CloudEngineHub/RP1_hardware/00_Docs/README.md

# 硬件说明文档

[RP1 硬件系统架构（PDF）](RP1_Hardware_Architecture.pdf)

先按整机配置选择 BOM，再通过料号查找对应的设计与制造文件。

| 资料 | 内容 |
| --- | --- |
| [整机 BOM](../04_BOM/README.md) | 各配置的物料料号与数量 |
| [机械结构](../01_Mechanic/README.md) | 装配体、零件模型、工程图与制造要求 |
| [PCB](../02_PCB/README.md) | 板级 BOM、Gerber、贴装坐标与加工要求 |
| [线束](../03_Harness/README.md) | 线束 BOM、图纸与制作规范 |

[返回 RP1 硬件首页](../README_CN.md)
