CloudEngineHub/RP1_hardware/02_PCB/11_RBE_PWR_140WCHG/README.md

# 140WCHG 板贴装说明

[PCB 资料](../README.md) · [项目首页](../../README_CN.md)

资料料号：YCL.E000223；板卡修订：V1.0。

| 位号 | 装配状态 | 单板装配数量 |
| --- | --- | --- |
| R59 | NC，不装 | 0 |

[BOM](01_BOM_140WCHG_2026-09-09.xlsx) 的主表为装配物料清单，[CPL](04_CPL_140WCHG_2026-09-16.xlsx) 的主表为有效贴装坐标，两者均包含 164 个装配位号。

47kΩ／FRC0603F4702TS 的装配位号为 `R17,R30`，单板数量为 2。BOM 的 `NC_List` 表单独保留 R59，数量为 0，不计入装配采购数量。

BOM 第 57 行的 `Unique ID` 保留原分组导出追溯信息，原分组包含 R59。各 ID 与位号的逐项映射未确认；采购及装配以主表的 `Designator`、`Quantity` 和有效 CPL 为准。导出装配 BOM 时，仅使用原 BOM 主表，不使用 `NC_List`。
