CloudEngineHub/RP1_hardware/02_PCB/06_RBE-PWR-HEAD/README.md

# HEAD 板贴装说明

资料料号：YCL.E000225；板卡修订：V2.0。

| 位号 | 装配状态 | 单板装配数量 |
| --- | --- | --- |
| C30 | NC，不装 | 0 |

[BOM](01_BOM_HEAD_2026-09-09.xlsx) 的主表为装配物料清单。[CPL](04_CPL_HEAD_2026-09-16.xlsx) 的主表为有效贴装坐标，均包含 200 个装配位号。

CPL 的 `NC_List` 表保留 C30 的型号、封装和原坐标，仅用于追溯。导出或导入贴装坐标时，只使用原 CPL 主表，不使用 `NC_List`。
