CloudEngineHub/RP1_hardware/03_Harness/README.md

# 线束资料

本目录提供 RP1 的 42 种线束及对应 PDF 图纸。

| 资料 | 内容 |
| --- | --- |
| [RP1_Harness_BOM.xlsx](RP1_Harness_BOM.xlsx) | 线束名称、线径、连接器、端子与数量 |
| [加工图纸](Drawings/) | 线束加工图纸 |
| [线束制作规范.docx](线束制作规范.docx) | 制作流程、端接要求与检验方法 |

按线束名称查找图纸。`ARM_10线材` 对应 [ARM_10_信号线.pdf](Drawings/ARM_10_信号线.pdf)。

## BODY01 图纸

BODY01 线束加工图纸

[查看图纸 PDF](Drawings/RP1-BODY01-0线材.pdf)

整机配置所需物料见 [整机 BOM](../04_BOM/README.md)。

[返回 RP1 硬件首页](../README_CN.md)
