CloudEngineHub/RP1_hardware/01_Mechanic/02_Manufacturing/01_CNC/CMF说明/RP1_CNC_CMF_Specification.xlsx

序号 | 零件代号 | 零件名称 | 颜色 | 材质 | 工艺 | 三维视图缩略图
1 | YCL.M000227 | 腰部一号（LS版） | 蓝 | AL6061 | 喷砂、喷涂
2 | YCL.M000228 | 腰部一号抱箍（LS版） | 蓝 | AL6061 | 喷砂、喷涂
3 | YCL.M000229 | 髋关节前（LS版） | 白 | AL6061 | 喷砂、喷涂
4 | YCL.M000230 | 髋关节后（LS版） | 白 | AL6061 | 喷砂、喷涂
5 | YCL.M000231 | 髋关节左（LS版） | 蓝 | AL6061 | 喷砂、喷涂
6 | YCL.M000232 | 髋关节右（LS版） | 蓝 | AL6061 | 喷砂、喷涂
7 | YCL.M000234 | 髋关节限位环 | 蓝 | AL6061 | 喷砂、喷涂
8 | YCL.M000237 | 髋关节电机盖板 | 蓝 | AL6061 | 喷砂、喷涂
9 | YCL.M000239 | 髋关节左抱箍 | 蓝 | AL6061 | 喷砂、喷涂
10 | YCL.M000240 | 髋关节右抱箍 | 蓝 | AL6061 | 喷砂、喷涂
11 | YCL.M000289 | 髋关节前盖板 | 灰 | AL6061 | 喷砂、喷涂
12 | YCL.M000312 | 小臂下本体 | 白 | AL6061 | 喷砂、喷涂
13 | YCL.M000324 | 手腕端头本体 | 白 | AL6061 | 喷砂、喷涂
14 | YCL.M000330 | 转接板固定件 | 白 | AL6061 | 喷砂、喷涂
15 | YCL.M000331 | RP_Hand转接件 | 白 | AL6061 | 喷砂、喷涂
16 | YCL.M000342 | 肩部抱箍 | 白 | AL6061 | 喷砂、喷涂
17 | YCL.M000372 | 造型手本体 | 白 | AL6061 | 喷砂、喷涂
18 | YCL.M000373 | 造型手盖子 | 白 | AL6061 | 喷砂、喷涂
19 | YCL.M000374 | 镜向造型手本体 | 白 | AL6061 | 喷砂、喷涂
20 | YCL.M000376 | 镜向造型手盖子 | 白 | AL6061 | 喷砂、喷涂
21 | YCL.M000437 | 髋关节后盖板 | 灰 | AL6061 | 喷砂、喷涂
22 | YCL.M000444 | 小腿前盖板 | 灰 | ABS | 打磨、喷涂
23 | YCL.M000445 | 小腿后盖板 | 灰 | ABS | 打磨、喷涂
24 | YCL.M000446 | 小腿电机分离块（减重优化） | 白 | AL6061 | 喷砂、喷涂
25 | YCL.M000447 | 小腿本体右（减重优化） | 白 | AL6061 | 喷砂、喷涂
26 | YCL.M000448 | 小腿本体左（减重优化） | 白 | AL6061 | 喷砂、喷涂
27 | YCL.M000449 | 小腿脚踝分离块（减重优化） | 白 | AL6061 | 喷砂、喷涂
28 | YCL.M000451 | 镜向小腿脚踝分离块（减重优化） | 白 | AL6061 | 喷砂、喷涂
29 | YCL.M000452 | 镜向小腿本体左（减重优化） | 白 | AL6061 | 喷砂、喷涂
30 | YCL.M000453 | 镜向小腿本体右（减重优化） | 白 | AL6061 | 喷砂、喷涂
31 | YCL.M000454 | 镜向小腿电机分离块（减重优化） | 白 | AL6061 | 喷砂、喷涂
32 | YCL.M000471 | 手腕本体 | 蓝 | AL6061 | 喷砂、喷涂
33 | YCL.M000472 | 镜向手腕本体 | 蓝 | AL6061 | 喷砂、喷涂
34 | YCL.M000473 | 手腕上抱箍 | 蓝 | AL6061 | 喷砂、喷涂
35 | YCL.M000474 | 手腕下抱箍 | 蓝 | AL6061 | 喷砂、喷涂
36 | YCL.M000475 | 大腿卡箍后 | 白 | AL6061 | 喷砂、喷涂
37 | YCL.M000477 | 大腿卡箍前 | 白 | AL6061 | 喷砂、喷涂
38 | YCL.M000481 | 大腿下本体右 | 白 | AL6061 | 喷砂、喷涂
39 | YCL.M000485 | 大腿下盖板左 | 白 | AL6061 | 喷砂、喷涂
40 | YCL.M000486 | 大腿下盖板右 | 白 | AL6061 | 喷砂、喷涂
41 | YCL.M000640 | 75肩部抱箍（01版） | 蓝 | AL6061 | 喷砂、喷涂
42 | YCL.M000641 | 75肩部本体（01版） | 蓝 | AL6061 | 喷砂、喷涂
43 | YCL.M000642 | 大臂上本体（01版） | 白 | AL6061 | 喷砂、喷涂
44 | YCL.M000643 | 大臂上抱箍（01版） | 白 | AL6061 | 喷砂、喷涂
45 | YCL.M000644 | 大臂下前分件(01版) | 白 | AL6061 | 喷砂、喷涂
46 | YCL.M000645 | 大臂下后分件(01版) | 白 | AL6061 | 喷砂、喷涂
47 | YCL.M000646 | 小臂上本体左（02版） | 白 | AL6061 | 喷砂、喷涂
48 | YCL.M000647 | 小臂上本体右（02版） | 白 | AL6061 | 喷砂、喷涂
49 | YCL.M000648 | 镜向小臂上本体左（02版） | 白 | AL6061 | 喷砂、喷涂
50 | YCL.M000649 | 镜向小臂上本体右（02版） | 白 | AL6061 | 喷砂、喷涂
51 | YCL.M000650 | 镜向大臂下前分件(01版) | 白 | AL6061 | 喷砂、喷涂
52 | YCL.M000651 | 镜向大臂下后分件(01版) | 白 | AL6061 | 喷砂、喷涂
53 | YCL.M000652 | 镜向75肩部抱箍(01版) | 蓝 | AL6061 | 喷砂、喷涂
54 | YCL.M000656 | 镜向75肩部本体(01版) | 蓝 | AL6061 | 喷砂、喷涂
55 | YCL.M000657 | 脚板（01版） | 蓝 | AL6061 | 喷砂、喷涂
56 | YCL.M000662 | 大腿抱箍(01版) | 白 | AL6061 | 喷砂、喷涂
57 | YCL.M000663 | 大腿本体(01版) | 白 | AL6061 | 喷砂、喷涂
58 | YCL.M000666 | 大腿下电机抱箍（01版） | 白 | AL6061 | 喷砂、喷涂
59 | YCL.M000667 | 大腿下本体左(02版) | 白 | AL6061 | 喷砂、喷涂
60 | YCL.M000669 | 镜向大腿下电机抱箍（01版） | 白 | AL6061 | 喷砂、喷涂
61 | YCL.M000670 | 镜向大腿下本体左(02版) | 白 | AL6061 | 喷砂、喷涂
62 | YCL.M000671 | 镜向大腿卡箍后 | 白 | AL6061 | 喷砂、喷涂
63 | YCL.M000672 | 镜向大腿下盖板左 | 白 | AL6061 | 喷砂、喷涂
64 | YCL.M000673 | 镜向大腿卡箍前 | 白 | AL6061 | 喷砂、喷涂
65 | YCL.M000674 | 镜向大腿下本体右 | 白 | AL6061 | 喷砂、喷涂
66 | YCL.M000675 | 镜向大腿下盖板右 | 白 | AL6061 | 喷砂、喷涂
67 | YCL.M000708 | 把手 | 白 | AL6061 | 喷砂、喷涂
68 | YCL.M000716 | kickme版本躯干后壳 | 白 | PC | 打磨、喷涂
69 | YCL.M000717 | kickme版本躯干前壳 | 白 | PC | 打磨、喷涂
70 | YCL.M000722 | 脚板 | 蓝 | AL6061 | 喷砂、喷涂
71 | YCL.M000740 | 头部灯带嵌板 | 白 | ABS | 打磨、喷涂
72 | YCL.M000741 | 运控头头部 | 白 | ABS | 打磨、喷涂
73 | YCL.M000748 | 小电池弹性臂按键 | 白 | PC | 打磨、喷涂
74 | YCL.M000787 | KICKME运控头主体 | 白 | ABS | 打磨、喷涂
75 | YCL.M000788 | KICKME运控头螺丝遮挡盖 | 白 | ABS | 打磨、喷涂
