CloudEngineHub/RP1_hardware/02_PCB/01_FPC柔性板/07_参考图_FPC.jpg

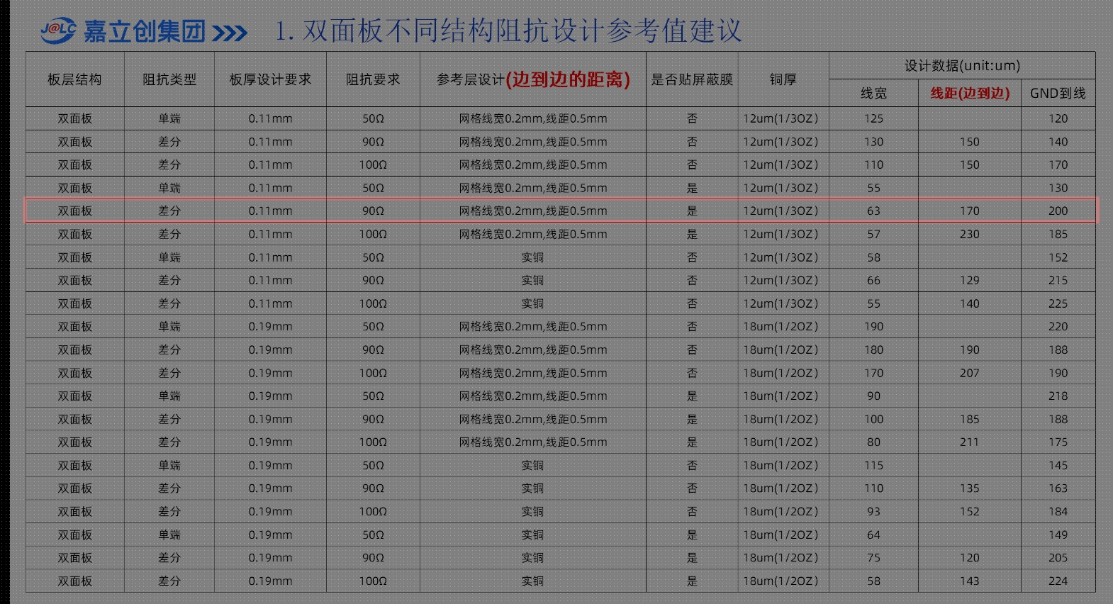
02_PCB/01_FPC柔性板/07_参考图_FPC.jpg
