CloudEngineHub/RP1_hardware/04_BOM/README.md

# RP1 整机 BOM

[返回仓库](../README.md) · [结构资料](../01_Mechanic/README.md) · [PCB](../02_PCB/README.md) · [线束](../03_Harness/README.md)

本目录提供 RP1.3.4 两种配置的整机物料清单。

## 文件与配置

| 配置 | BOM 文件 |
| --- | --- |
| `5DOF_MotionHead` | [RP1_BOM_5DOF_MotionHead.xlsx](RP1_BOM_5DOF_MotionHead.xlsx) |
| `7DOF_MotionHead` | [RP1_BOM_7DOF_MotionHead.xlsx](RP1_BOM_7DOF_MotionHead.xlsx) |

## 工作表

| 工作表 | 内容 |
| --- | --- |
| `总BOM` | 整机装配件、结构件、标准件、板卡、线束及外购件的料号、名称、数量、修订和材料信息 |
| `包材` | 包装物料清单 |

## 使用

按所选配置使用对应 BOM，并通过料号查找配套资料。结构模型与加工文件见 [01_Mechanic](../01_Mechanic/README.md)，板级 BOM 与 PCB 制造文件见 [02_PCB](../02_PCB/README.md)，线束图纸与物料表见 [03_Harness](../03_Harness/README.md)。
