CloudEngineHub/RP1_hardware/03_Harness/RP1_Harness_BOM.xlsx

序号 | 部位 | 线束名称 | 线材规格 | 连接器 | 端子 | 数量
1 | 头部 | NX_Eth_HEAD线材 | 26AWG | A1002H-8P-2+标准网口 | A1002-TP | 1
2 | 头部 | RP1-HEAD1线材 | 28AWG | XT30U (2+2)-F | XT30U (2+2)-F | 1
3 | 头部 | RP1-HEAD2线材 | 28AWG | XT30U (2+2)-F | XT30U (2+2)-F | 1
4 | 头部 | RP1-HEAD3线材 | 28AWG | XT30U (2+2)-F | XT30U (2+2)-F | 1
5 | 主控 | RP1-BODY01-0线材 | CQ-RXG0250 | XT30U (2+2)-F | XT30U (2+2)-F | 1
6 | 主控 | RP1-BODY02-0线材 | CQ-RXG0250 | XT30U (2+2)-F | XT30U (2+2)-F | 1
7 | 主控 | RP1-BODY03-0线材 | CQ-RXG0250 | XT30U (2+2)-F | XT30U (2+2)-F | 1
8 | 主控 | RP1-BODY04-0线材 | CQ-RXG0250 | XT30U (2+2)-F | XT30U (2+2)-F | 1
9 | 主控 | RP1-BODY05-0线材 | CQ-RXG0250 | XT30U (2+2)-F | XT30U (2+2)-F | 1
10 | 主控 | RP1-BODY06-0线材 | 28AWG | GH1.25 4pin | GH1.25 | 1
11 | 主控 | Body_ETH线材 | 26AWG | KW30-8P |  | 2
12 | 主控 | Body-485线材 | 28AWG | A1257H-2P | A1257-TP | 1
13 | 主控 | BODY-stop线材 | 28AWG | A1501H-4P+A2012H-2P | A1501-TP+A2006-TP | 1
14 | 主控 | LED灯板线 | 28AWG | A1257H-3P | A1257-TP | 1
15 | 手部 | RP1-ARM01-0线材 | CQ-RXG0250 | XT30U (2+2)-F | XT30U (2+2)-F | 2
16 | 手部 | RP1-ARM02-0线材 | CQ-RXG0250 | XT30U (2+2)-F | XT30U (2+2)-F | 2
17 | 手部 | RP1-ARM03-0线材 | CQ-RXG0250 | XT30U (2+2)-F | XT30U (2+2)-F | 2
18 | 手部 | RP1-ARM04-0线材 | CQ-RXG0250 | XT30 (2+2)PB-M | XT30 (2+2)PB-M | 2
19 | 手部 | RP1-ARM05-0线材 | CQ-RXG0250 | XT30U (2+2)-F | XT30U (2+2)-F | 2
20 | 手部 | RP1-ARM06-0线材 | CQ-RXG0250 | XT30U (2+2)-F | XT30U (2+2)-F | 2
21 | 手部 | RP1-ARM07-0线材 | CQ-RXG0250 | XT30 (2+2)PB-M | XT30 (2+2)PB-M | 2
22 | 手部 | RP1-ARM08-0线材 | CQ-RXG0250 | XT30U (2+2)-F | XT30U (2+2)-F | 2
23 | 手部 | ARM_10线材 | 28AWG | A2001H-6P | A2001-TP | 2
24 | 手部 | 手部转接线 | 26AWG | PH2.0 6P+ZER-06V-S | SPH-002T-P0.5S +SZE-003T-P0.3 | 2
25 | 腿部 | RP1-LEG01-0线材 | CQ-RXG0250 | XT30U (2+2)-F | XT30U (2+2)-F | 2
26 | 腿部 | RP1-LEG02-0线材 | CQ-RXG0250 | XT30U (2+2)-F | XT30U (2+2)-F | 2
27 | 腿部 | RP1-LEG03-0线材 | CQ-RXG0250 | XT30U (2+2)-F | XT30U (2+2)-F | 2
28 | 腿部 | RP1-LEG04-0线材 | CQ-RXG0250 | XT30 (2+2)PB-M | XT30U (2+2)PB-M | 2
29 | 腿部 | RP1-LEG05-0线材 | CQ-RXG0250 | XT30U (2+2)-F | XT30U (2+2)-F | 2
30 | 腿部 | RP1-LEG06-0线材 | CQ-RXG0250 | XT30U (2+2)-F+XT30(2+2)PB-M | XT30U (2+2)-F+XT30 (2+2)PB-M | 2
31 | 腿部 | RP1-LEG07-0线材 | CQ-RXG0250 | XT30U (2+2)-F | XT30U (2+2)-F | 2
32 | 背板 | Back-GPIO线材 | 28AWG | A1257H-7P | A1257-T | 1
33 | 背板 | Back-Key线材 | 28AWG | A1257H-4P | A1257-T | 1
34 | 背板 | Back_Eth_NX线材 | 26AWG | A1002H-8P-2 | A1002-TP | 1
35 | 背板 | BACK-POWER-NX线材 | 16AWG | PH2.0 6pin+ XT30-F | A2001-TP | 1
36 | 背板 | 电池供电线背部 | 18AWG | XT30-M | XT30-M | 1
37 | 背板 | 电池供电线主控 | 14AWG | XT60-F | XT60-F | 1
38 | 背板 | 电池供电线 | 18AWG | XT30-F | XT30-F | 1
39 | 背板 | 小电池保护板长线 | 16AWG | XT30-F | XT30-F | 1
40 | 背板 | 小电池保护板短线 | 16AWG | XT30-F | XT30-F | 1
41 | 腰部 | RP1-POWER01-0线材 | 28AWG | XT30U (2+2)-F | XT30U (2+2)-F | 1
42 | 腰部 | RP1-POWER02-0线材 | 28AWG | XT30U (2+2)-F | XT30U (2+2)-F | 1
 |  | 数量合计 |  |  |  | 60
