CloudEngineHub/RP1_hardware/02_PCB/08_RBE-PWR-MCAP/01_BOM_MCAP_2026-09-07.xlsx

No. | Quantity | Comment | Designator | Footprint | Value | Manufacturer Part | Manufacturer
1 | 5 | CAP_TH_BD13-L30 | C1,C2,C4,C6,C7 | CAP-TH_BD13-L30-P10.00-L45-W15-FD
2 | 1 | 100nF | C9 | C0603 | 100nF | FCC0603B104K500CT | FOJAN(富捷)
3 | 1 | DDZ16ASF-7 | D1 | SOD-323F_L2.0-W1.6-LS2.5-RD |  | DDZ16ASF-7 | DIODES(美台)
4 | 1 | HSY0149A | Q1 | TOLL-8_L10.4-W9.9-P1.20-LS11.7-BL_2 |  | HSY0149A | HUASHUO(华朔)
5 | 1 | 280kΩ | R1 | R1206 | 280kΩ | FRC1206F2803TS | FOJAN(富捷)
6 | 1 | 680kΩ | R2 | R1206 | 680kΩ | FRC1206J684 TS | FOJAN(富捷)
7 | 1 | XT30PW(2+2)-M.G.B | U1 | CONN-TH_4P-XT30PW-M |  | XT30PW(2+2)-M.G.B | AMASS(艾迈斯)
