CloudEngineHub/RP1_hardware/02_PCB/04_RBE-PWR-FAN/01_BOM_FAN_V2.0.xlsx

No. | Quantity | Comment | Designator | Footprint | Value | Name | Device | Supplier | Voltage Rated | Tolerance
1 | 5 | 100nF | C1,C2,C3,C5,C9 | C0402 | 100nF | 100nF | CAP_0603
2 | 1 | 33pF | C4 | C0402 | 33pF | 33pF | CAP_0603
3 | 1 | 4.7uF | C6 | C1206 | 4.7uF | 4.7uF | GRM31CC72A475KE11L | LCSC |  | ±10%
4 | 1 | 47uF | C7 | C1210 | 47uF | 47uF | HGC1210R5476M250NSVK | LCSC |  | ±20%
5 | 1 | 47uF | C8 | C1206 | 47uF | 47uF | HGC1206R5476M250NSPJ | LCSC |  | ±20%
6 | 1 | 1.25-2P | CN1 | CONN-SMD_1.25-2P |  | 1.25-2P | 1.25-2P | LCSC
7 | 1 | WAFER-254W-2A | CN2 | CONN-SMD_2P-L10.0-W7.8-P2.5 |  | WAFER-254W-2A | WAFER-254W-2A | LCSC
8 | 1 | SMBJ60A | D1 | SMB_L4.5-W3.7-LS5.4-RD |  | SMBJ60A | SMBJ60A_C49066953 | LCSC
9 | 1 | DSS310 | D2 | SOD-123F_L2.8-W1.8-LS3.7-RD |  | DSS310 | DSS310 | LCSC
10 | 1 | 68uH | L1 | IND-SMD_L7.2-W6.6_GPSR07X0 | 68uH | 68uH | CYA0650-68UH | LCSC |  | ±20%
11 | 1 | AO3400 | Q1 | SOT-23-3_L2.9-W1.3-P1.90-LS2.4-BR |  | AO3400 | AO3400_C181090 | LCSC
12 | 1 | 47kΩ | R1 | R0402 | 47kΩ | 47kΩ | FRC0402F4702TS | LCSC |  | ±1%
13 | 1 | 4.7kΩ | R2 | R0402 | 4.7kΩ | 4.7kΩ | RC0402FR-074K7L | LCSC |  | ±1%
14 | 1 | 100kΩ | R3 | R0402 | 100kΩ | 100kΩ | FRC0402F1003TS | LCSC |  | ±1%
15 | 1 | 8.06kΩ | R4 | R0402 | 8.06kΩ | 8.06kΩ | RC0402FR-078K06L | LCSC |  | ±1%
16 | 1 | 140kΩ | R5 | R0402 | 140kΩ | 140kΩ | RC0402FR-07140KL | LCSC |  | ±1%
17 | 1 | 68k | R6 | R0402 | 68k | 68k | Res_0603
18 | 1 | 100K | R7 | R0603 | 100K | 100K | Res_0603
19 | 1 | 4.7k | R8 | R0402 | 4.7k | 4.7k | Res_0603
20 | 2 | ZX-PH2.0-WT2P | U1,U2 | CONN-SMD_ZX-PH2.0-WT2P |  | ZX-PH2.0-WT2P | ZX-PH2.0-WT2P | LCSC
21 | 1 | TL331IDBVR | U3 | SOT-23-5_L3.0-W1.7-P0.95-LS2.8-BR |  | TL331IDBVR | TL331IDBVR | LCSC
22 | 1 | MX8015EP | U4 | ESOP-8_L4.9-W3.9-P1.27-LS6.0-BL-EP |  | MX8015EP | MX8015EP | LCSC
