CloudEngineHub/RP1_hardware/01_Mechanic/02_Manufacturing/01_CNC/RP1_CNC_BOM.xlsx

序号 | 料号 | 零件名称 | 版本 | 材料要求 | 5DOF 运控头 单机数量 | 7DOF 运控头 单机数量
1 | YCL.A000018 | 热压连杆装配体左 | 1 |  | 1 | 1
2 | YCL.A000019 | 热压连杆装配体右 | 1 |  | 1 | 1
3 | YCL.M000225 | 腰部Yaw限位环 | 1 | AISI 1045 钢，冷拔 | 1 | 1
4 | YCL.M000226 | 腰部Roll限位环 | 1 | AISI 1045 钢，冷拔 | 1 | 1
5 | YCL.M000227 | 腰部一号（LS版） | 2 | AL6061-T6 | 1 | 1
6 | YCL.M000228 | 腰部一号抱箍（LS版） | 1 | AL6061-T6 | 1 | 1
7 | YCL.M000229 | 髋关节前（LS版） | 1 | AL6061-T6 | 1 | 1
8 | YCL.M000230 | 髋关节后（LS版） | 1 | AL6061-T6 | 1 | 1
9 | YCL.M000231 | 髋关节左（LS版） | 1 | AL6061-T6 | 1 | 1
10 | YCL.M000232 | 髋关节右（LS版） | 1 | AL6061-T6 | 1 | 1
11 | YCL.M000234 | 髋关节限位环（LS版） | 1 | AISI 1045 钢，冷拔 | 2 | 2
12 | YCL.M000237 | 髋关节电机盖板 | 1 | AL6061-T6 | 2 | 2
13 | YCL.M000238 | 腰部电机罩壳（LS版） | 1 | AL6061-T6 | 1 | 1
14 | YCL.M000239 | 髋关节左抱箍 | 1 | AL6061-T6 | 1 | 1
15 | YCL.M000240 | 髋关节右抱箍 | 1 | AL6061-T6 | 1 | 1
16 | YCL.M000243 | 风机固定块 | 1 | AL6061-T6 | 2 | 2
17 | YCL.M000249 | Yaw限位3 | 1 | 45 | 2 | 2
18 | YCL.M000271 | Pitch限位 | 1 | 45 | 1 | 1
19 | YCL.M000272 | 脚底十字轴 | 1 | 45 | 2 | 2
20 | YCL.M000284 | 镜向Pitch限位 | 1 | #45 | 1 | 1
21 | YCL.M000289 | 髋关节前盖板 | 1 | AL6061-T6 | 1 | 1
22 | YCL.M000292 | 膝盖轴承座 | 1 | P20 | 2 | 2
23 | YCL.M000312 | 小臂下本体 | 1 | AL6061-T6 | 0 | 2
24 | YCL.M000324 | 手腕端头本体 | 1 | AL6061-T6 | 0 | 2
25 | YCL.M000330 | 转接板固定件 | 1 | AL6061-T6 | 0 | 2
26 | YCL.M000331 | 灵巧手转接件 | 1 | AL6061-T6 | 0 | 2
27 | YCL.M000332 | 手臂转接法兰 | 1 | AL6061-T6 | 2 | 2
28 | YCL.M000334 | 限位环 | 1 | 45 | 2 | 2
29 | YCL.M000336 | 肘部轴承座 | 1 | P20 | 2 | 2
30 | YCL.M000337 | 限位环2 | 1 | 45 | 2 | 2
31 | YCL.M000341 | 55限位环 | 1 | 45 | 0 | 4
32 | YCL.M000342 | 肩部抱箍 |  | AL6061-T6 | 2 | 2
33 | YCL.M000372 | 造型手本体 | 1 | AL6061-T6 | 1 | 0
34 | YCL.M000373 | 造型手盖子 | 1 | AL6061-T6 | 1 | 0
35 | YCL.M000374 | 镜向造型手本体 | 1 | AL6061-T6 | 1 | 0
36 | YCL.M000376 | 镜向造型手盖子 | 1 | AL6061-T6 | 1 | 0
37 | YCL.M000399 | 75限位环 | 1 | 45 | 2 | 2
38 | YCL.M000437 | 髋关节后盖板 | 1 | AL6061-T6 | 1 | 1
39 | YCL.M000446 | 小腿电机分离块 | 1 | AL6061-T6 | 1 | 1
40 | YCL.M000447 | 小腿本体右 | 1 | AL6061-T6 | 1 | 1
41 | YCL.M000448 | 小腿本体左 | 1 | AL6061-T6 | 1 | 1
42 | YCL.M000449 | 小腿脚踝分离块 | 1 | AL6061-T6 | 1 | 1
43 | YCL.M000451 | 镜向小腿脚踝分离块 | 1 | AL6061-T6 | 1 | 1
44 | YCL.M000452 | 镜向小腿本体左 | 1 | AL6061-T6 | 1 | 1
45 | YCL.M000453 | 镜向小腿本体右 | 1 | AL6061-T6 | 1 | 1
46 | YCL.M000454 | 镜向小腿电机分离块 | 1 | AL6061 | 1 | 1
47 | YCL.M000471 | 手腕本体 | 1 | AL6061-T6 | 0 | 1
48 | YCL.M000472 | 镜向手腕本体 | 1 | AL6061-T6 | 0 | 1
49 | YCL.M000473 | 手腕上抱箍 | 1 | AL6061-T6 | 0 | 2
50 | YCL.M000474 | 手腕下抱箍 | 1 | AL6061-T6 | 0 | 2
51 | YCL.M000475 | 大腿卡箍后 | 1 | AL6061-T6 | 2 | 2
52 | YCL.M000477 | 大腿卡箍前 | 1 | AL6061-T6 | 2 | 2
53 | YCL.M000481 | 大腿下本体右 | 1 | AL6061-T6 | 1 | 1
54 | YCL.M000485 | 大腿下盖板左 | 1 | AL6061-T6 | 2 | 2
55 | YCL.M000486 | 大腿下盖板右 | 1 | AL6061-T6 | 2 | 2
56 | YCL.M000640 | 75肩部抱箍（01版） | 1 | AL6061-T6 | 1 | 1
57 | YCL.M000641 | 75肩部本体（01版） | 1 | AL6061-T6 | 1 | 1
58 | YCL.M000642 | 大臂上本体（01版） | 1 | AL6061-T6 | 2 | 2
59 | YCL.M000643 | 大臂上抱箍（01版） | 1 | AL6061-T6 | 2 | 2
60 | YCL.M000644 | 大臂下前分件(01版) | 1 | AL6061-T6 | 1 | 1
61 | YCL.M000645 | 大臂下后分件(01版) | 1 | AL6061-T6 | 1 | 1
62 | YCL.M000646 | 小臂上本体左（02版） | 1 | AL6061-T6 | 1 | 1
63 | YCL.M000647 | 小臂上本体右（02版） | 1 | AL6061-T6 | 1 | 1
64 | YCL.M000648 | 镜向小臂上本体左（02版） | 1 | AL6061-T6 | 1 | 1
65 | YCL.M000649 | 镜向小臂上本体右（02版） | 1 | AL6061-T6 | 1 | 1
66 | YCL.M000650 | 镜向大臂下前分件(01版) | 1 | AL6061-T6 | 1 | 1
67 | YCL.M000651 | 镜向大臂下后分件(01版) | 1 | AL6061-T6 | 1 | 1
68 | YCL.M000652 | 镜向75肩部抱箍(01版) | 1 | AL6061-T6 | 1 | 1
69 | YCL.M000656 | 镜向75肩部本体(01版) | 1 | AL6061-T6 | 1 | 1
70 | YCL.M000659 | 脚底固定二号（02版） | 1 | 45 | 2 | 2
71 | YCL.M000660 | Roll限位 | 1 | 45 | 2 | 2
72 | YCL.M000662 | 大腿抱箍（量产） | 1 | AL6061-T6 | 2 | 2
73 | YCL.M000663 | 大腿本体（量产） | 1 | AL6061-T6 | 2 | 2
74 | YCL.M000664 | Yaw限位4（03版） | 1 | 45 | 2 | 2
75 | YCL.M000665 | 大腿法兰右 | 1 | AL6061-T6 | 1 | 1
76 | YCL.M000666 | 大腿下电机抱箍（01版） | 1 | AL6061-T6 | 1 | 1
77 | YCL.M000667 | 大腿下本体左(02版) | 1 | AL6061-T6 | 1 | 1
78 | YCL.M000668 | 大腿法兰左 | 1 | AL6061-T6 | 1 | 1
79 | YCL.M000669 | 镜向大腿下电机抱箍（01版） | 1 | AL6061-T6 | 1 | 1
80 | YCL.M000670 | 镜向大腿下本体左(02版) | 1 | AL6061-T6 | 1 | 1
81 | YCL.M000674 | 镜向大腿下本体右 | 1 | AL6061-T6 | 1 | 1
82 | YCL.M000702 | 腰部支架 |  | AL6061-T6 | 2 | 2
83 | YCL.M000703 | 外层拓扑支架 |  | AL6061-T6 | 1 | 1
84 | YCL.M000704 | kickme版本躯干框架 |  | AL6061-T6 | 1 | 1
85 | YCL.M000708 | 把手-kickme |  | AL6061-T6 | 1 | 1
86 | YCL.M000713 | PC缓冲支架 |  | PC | 1 | 1
87 | YCL.M000714 | 交互头安装支架 |  | AL6061-T6 | 1 | 1
88 | YCL.M000716 | kickme版本躯干后壳 |  | PC | 1 | 1
89 | YCL.M000717 | kickme 版本躯干前壳 |  | PC | 1 | 1
90 | YCL.M000722 | 脚板 | 1 | AL7075 | 2 | 2
91 | YCL.M000723 | 脚面 | 1 | 聚氨酯PU | 2 | 2
92 | YCL.M000746 | 前壳卡扣件 |  | PC | 2 | 2
93 | YCL.M000750 | 充电板安装与定位支架 |  | AL6061-T6 | 1 | 1
94 | YCL.M000765 | 镜向97限位环 | 1 | 45 | 1 | 1
95 | YCL.M000766 | 97限位环 | 1 | 45 | 1 | 1
96 | YCL.M000782 | 运控头转接件支架 |  | AL6061-T6 | 1 | 1
97 | YCL.M000818 | 脚踝限位环2 | 1 | 45 | 4 | 4
98 | YCL.M000925 | 鞋垫 | 1 | 止滑型TPU | 2 | 2
99 | YCL.M000927 | 运控头根部安装转接件 |  | AL6061-T6 | 1 | 1
100 | YCL.M000946 | 小腿前盖板 | 1 | 6061-T6 | 2 | 2
101 | YCL.M000947 | 小腿后盖板 | 1 | 6061-T6 | 2 | 2
102 | YCL.M000948 | 侧边线槽 |  | AL5052 | 1 | 1
103 | YCL.M000949 | 运控头拓展板 |  | AL6061-T6 | 1 | 1
 |  | 单机数量合计 |  |  | 127 | 141
