CloudEngineHub/RP1_hardware/01_Mechanic/02_Manufacturing/01_CNC/5DOF/YCL.M000373 造型手盖子.STEP

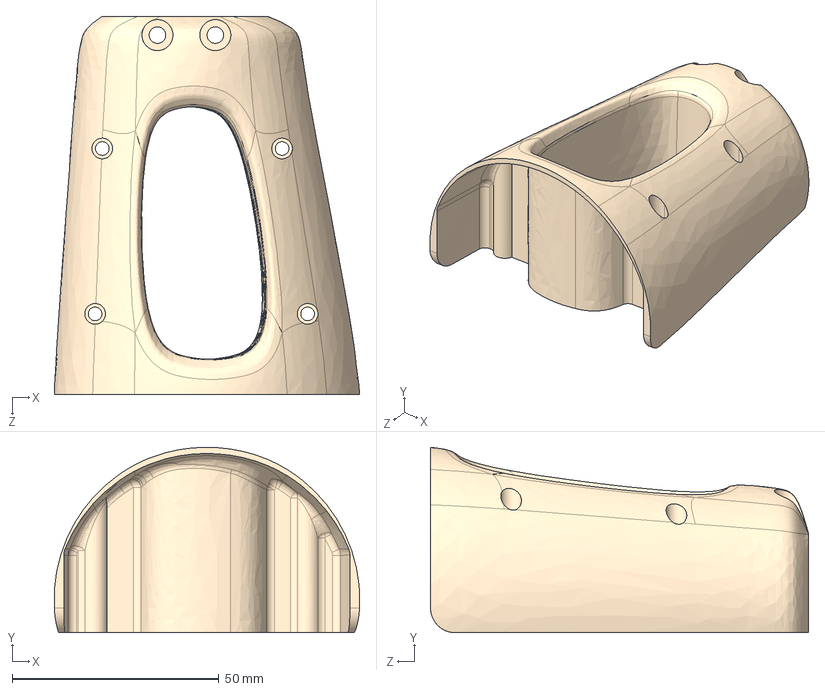
[picture p5: CAD file, 2026-09-30]
01_Mechanic/02_Manufacturing/01_CNC/5DOF/YCL.M000373 造型手盖子.STEP
73.9 x 44.8 x 91.4 mm
