CloudEngineHub/RP1_hardware/01_Mechanic/02_Manufacturing/01_CNC/7DOF/YCL.M000331 灵巧手转接件.STEP

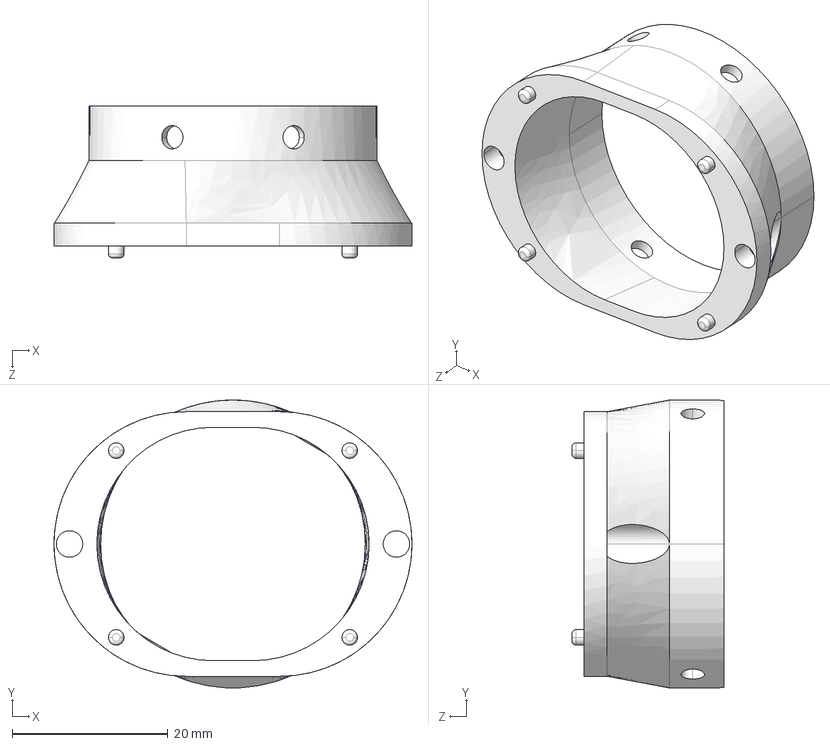
[picture p6: CAD file, 2026-10-15]
01_Mechanic/02_Manufacturing/01_CNC/7DOF/YCL.M000331 灵巧手转接件.STEP
46.0 x 37.0 x 19.5 mm
