CloudEngineHub/RP1_hardware/01_Mechanic/02_Manufacturing/01_CNC/Common/YCL.M000231_髋关节左（LS版）.STEP

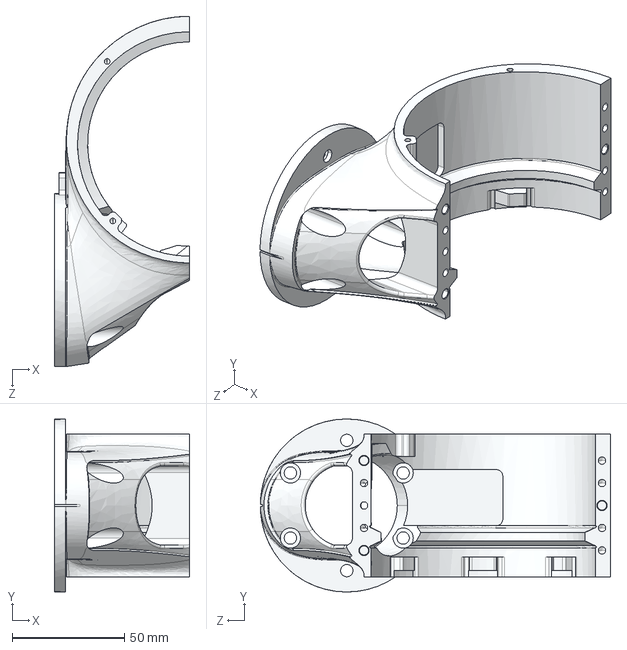
[picture p7: CAD file, 2026-09-30]
01_Mechanic/02_Manufacturing/01_CNC/Common/YCL.M000231_髋关节左（LS版）.STEP
60.2 x 77.1 x 156.1 mm
