CloudEngineHub/RP1_hardware/01_Mechanic/02_Manufacturing/02_3D_Printing/STEP_3D模型/YCL.M000250 压线块1.STEP

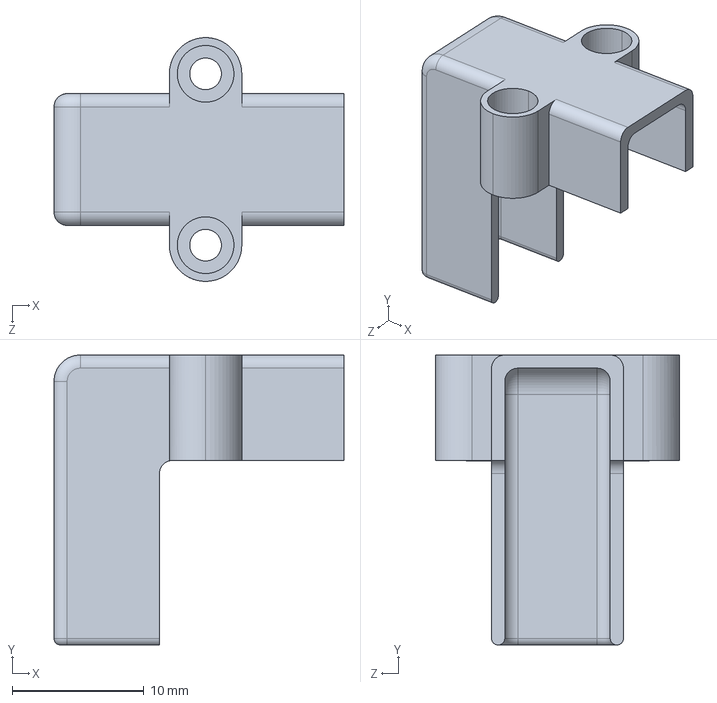
[picture p8: CAD file, 2026-09-30]
01_Mechanic/02_Manufacturing/02_3D_Printing/STEP_3D模型/YCL.M000250 压线块1.STEP
22.0 x 22.0 x 18.5 mm
