CloudEngineHub/RP1_hardware/01_Mechanic/02_Manufacturing/03_Rubber/STEP_3D模型/YCL.M000241_髋关节防撞垫.STEP

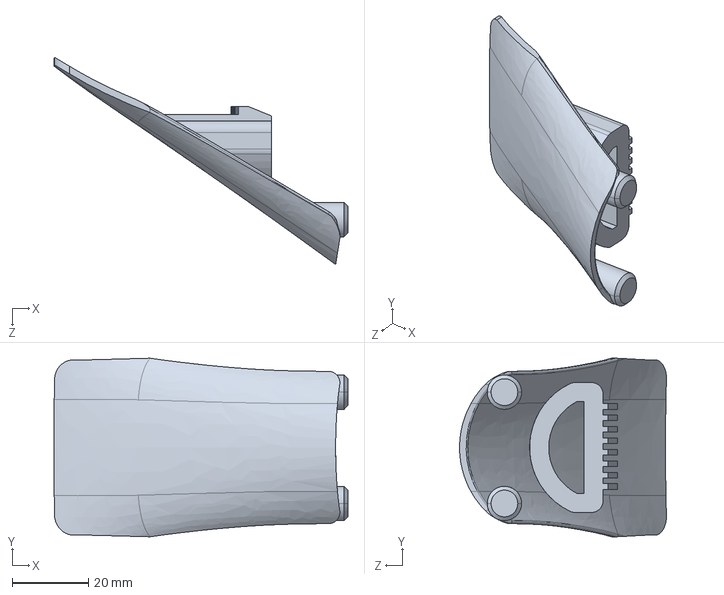
[picture p9: CAD file, 2026-09-30]
01_Mechanic/02_Manufacturing/03_Rubber/STEP_3D模型/YCL.M000241_髋关节防撞垫.STEP
77.0 x 46.8 x 54.2 mm
