CloudEngineHub/RP1_hardware/02_PCB/04_RBE-PWR-FAN/03_3D_FAN_V2.0.step

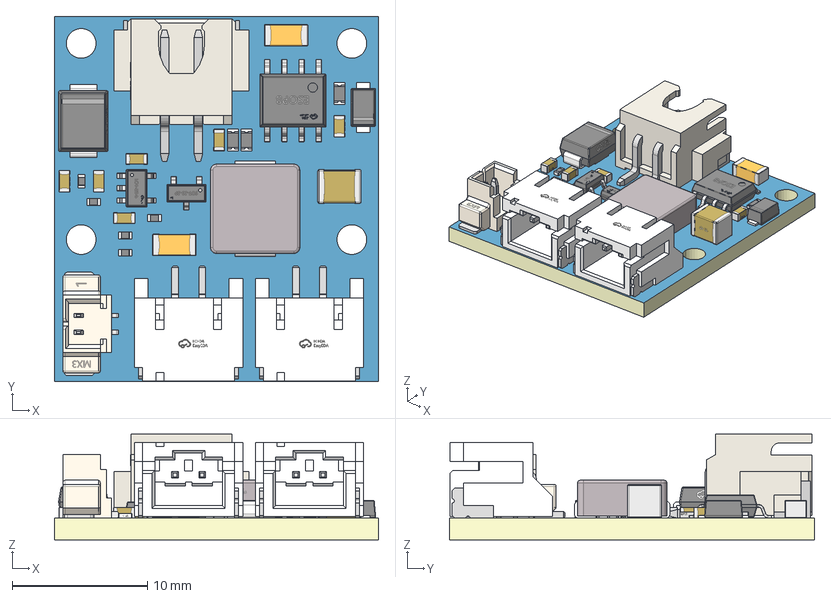
[picture p10: CAD file, 2026-09-30]
02_PCB/04_RBE-PWR-FAN/03_3D_FAN_V2.0.step
24.0 x 27.0 x 7.80 mm
Board~cwHV
TopCopper~cwHV
BottomCopper~cwHV
TopSilkscreen~cwHV
BottomSilkscreen~cwHV
TopFpcStiffener~cwHV
BottomFpcStiffener~cwHV
SMB_L4.5-W3.7-LS5.4-RD~SMB_L4.5-W3.7-LS5.4-RD~H7X9
SOD-123F_L2.8-W1.8-LS3.7-RD~SOD-123FL_L2.8-W1.8-LS3.7-RD-1~wsQN
R0402~R0402_L1.0-W0.5-H0.4~82rY x 5
R0402~R0603~82xX x 3
IND-SMD_L7.2-W6.6_GPSR07X0~IND-SMD_L7.2-W6.6-H3.0_GPSR07X0~H6Aj
CONN-SMD_2P-L10.0-W7.8-P2.5~CONN-SMD_2P-L10.0-W7.8-P2.5~Q8ck
C1210~C1210_L3.2-W2.5-H2.5~qlRi
C1206~C1206_L3.2-W1.6-H1.3~1Lzj x 2
ESOP-8_L4.9-W3.9-P1.27-LS6.0-BL-EP~ESOP-8_L4.9-W3.9-H1.6-LS6.0-P1.27~XwuK
CONN-SMD_ZX-PH2.0-WT2P~CONN-SMD_ZX-PH2.0-WT2P~Pmhs x 2
CONN-SMD_1.25-2P~CONN-SMD_1.25-2P~86q5
SOT-23-3_L2.9-W1.3-P1.90-LS2.4-BR~SOT-23-3P_L2.9-W1.3-H1.0-LS2.4-P0.95~QDDv
C0402~C0603_L1.6-W0.8-H0.8~mHzT x 6
SOT-23-5_L3.0-W1.7-P0.95-LS2.8-BR~SOT-23-5_L2.9-W1.6-H1.1-LS2.8-P0.95~9Cm8
