CloudEngineHub/RP1_hardware/02_PCB/05_RBE-PWR-HANDPlusPro/03_3D_HAND.step

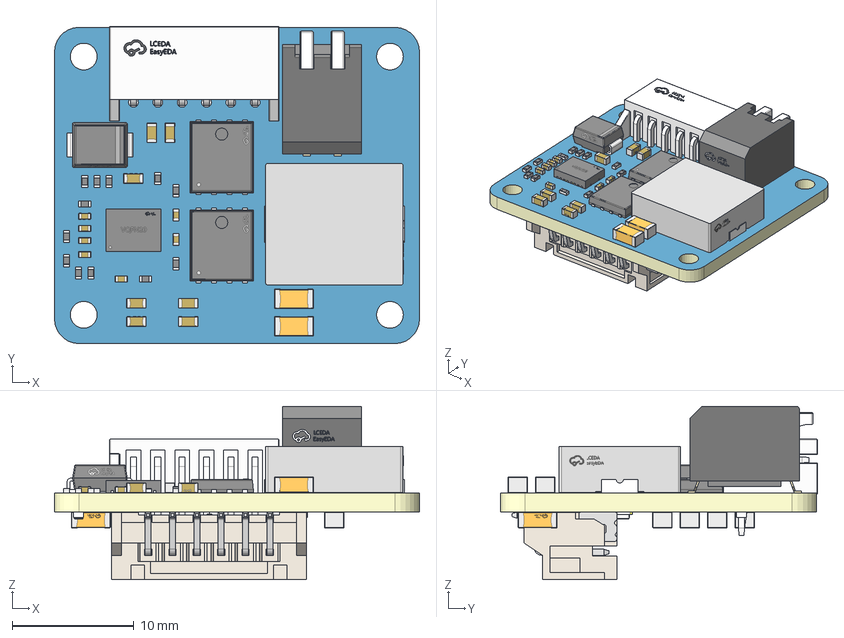
[picture p11: CAD file, 2026-09-30]
02_PCB/05_RBE-PWR-HANDPlusPro/03_3D_HAND.step
30.0 x 26.1 x 14.2 mm
Board~qohw
TopCopper~qohw
BottomCopper~qohw
TopSilkscreen~qohw
BottomSilkscreen~qohw
TopFpcStiffener~qohw
BottomFpcStiffener~qohw
C0603~C0603_L1.6-W0.8-H0.8~7yf3 x 7
R0402~R0402_L1.0-W0.5-H0.4~RjEz x 12
CONN-SMD_6P-P2.00_DEALON_PH-6PWB~CONN-SMD_6P-P2.00_DEALON_PH-6PWB~TEMH
C0402~C0402~qnve x 7
LED0603-RD~LED0603-RD~U6EP
DFN-8_L5.9-W5.2-P1.27-LS6.2-BL~DFN-8_L5.9-W5.2-P1.27-LS6.2-BL~wCYP x 2
CONN-TH_6P-P2.00_S6B-PH-K-S-LF-SN~CONN-TH_6P-P2.00_S6B-PH-K-S-LF-SN~wb2F
R0603~R0603~6FHI x 2
IND-SMD_L11.5-W10.0_FXL1040~IND-SMD_L11.5-W10.0-H3.8_FXL1040~XhAg
SMB_L4.5-W3.7-LS5.4-RD~SMB_L4.5-W3.7-LS5.4-RD~Vbv1
SW-SMD_DSPV02LSGET~SW-SMD_DSPV02LSGET-L6.5-W10.1-H7.1-P2.54-LS9.3~TFxo
VQFN-20_L4.5-W3.5-P0.50-BL-EP~VQFN-20_L4.5-W3.5-H1.0-P0.50-BL-EP~1ulL
C1206~C1206_L3.2-W1.6-H1.3~Xzcf x 7
