CloudEngineHub/RP1_hardware/02_PCB/07_RBE-PWR-HOTSWAP/03_3D_HOTSWAP_2026-09-18.step

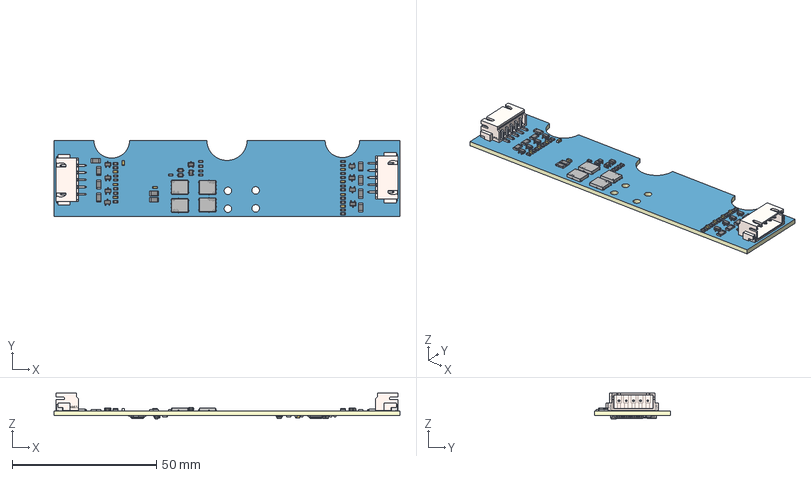
[picture p12: CAD file, 2026-09-30]
02_PCB/07_RBE-PWR-HOTSWAP/03_3D_HOTSWAP_2026-09-18.step
120.0 x 26.5 x 8.96 mm
Board~zzIS
TopCopper~zzIS
BottomCopper~zzIS
TopSilkscreen~zzIS
BottomSilkscreen~zzIS
TopFpcStiffener~zzIS
BottomFpcStiffener~zzIS
R0603~R0603~K6G3 x 36
DFN-5_L4.9-W5.9-P1.27-LS6.2-BL~DFN-5_L4.9-W5.9-H1.0-P1.27-LS6.2-BL~dKUq x 4
C0603~C0603_L1.6-W0.8-H0.8~9XmF x 19
R1206~R1206_L3.2-W1.6-H0.6~J1uA x 10
SOT-323-3_L2.0-W1.3-P1.30-LS2.1-BL~SOT-323-3_L2.0-W1.3-P1.30-LS2.1-BL~g8VF x 2
SOT-323-3_L2.1-W1.3-P1.30-LS2.3-BL~SOT-323-3_L2.1-W1.3-P1.30-LS2.3-BL~TfNc x 8
SOD-323_L1.8-W1.3-LS2.5-RD~SOD-323_L1.7-W1.3-H1.1-LS2.5~CR40 x 3
CONN-SMD_5P-P2.54_MEGASTAR_ZX-XH2.54-5PWT~CONN-SMD_5P-P2.54_MEGASTAR_ZX-XH2.54-5PWT~taBz x 2
SOT-323-3_L2.2-W1.3-P1.30-LS2.1-BR~SOT-323-3_L2.0-W1.3-H1.0-LS2.1-P1.30~Bu1m x 3
TSSOP-28_L9.7-W4.4-P0.65-LS6.4-BL~TSSOP-28_L9.7-W4.4-H1.0-LS6.4-P0.65~4Zbo x 2
