CloudEngineHub/RP1_hardware/02_PCB/10_RBE-SENS-IMU/03_3D_IMU_2026-09-16.step

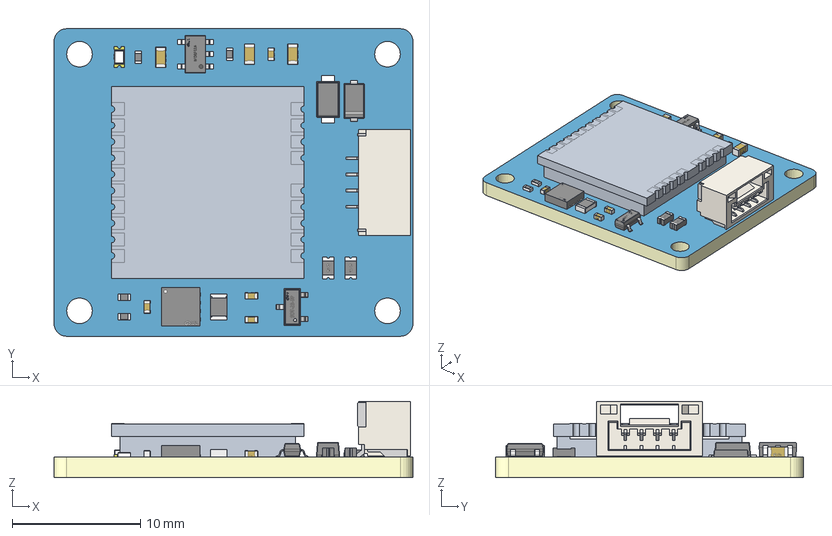
[picture p13: CAD file, 2026-09-30]
02_PCB/10_RBE-SENS-IMU/03_3D_IMU_2026-09-16.step
28.0 x 24.0 x 5.95 mm
Board~UrRD
TopCopper~UrRD
BottomCopper~UrRD
TopSilkscreen~UrRD
BottomSilkscreen~UrRD
TopFpcStiffener~UrRD
BottomFpcStiffener~UrRD
LED0603-RD~LED0603-RD~dst8
C0402~C0402_L1.0-W0.5-H0.5~U6qh x 4
HI02_HI05~HI02_HI05-3D~VfXQ
F0603~F0603_L1.7-W0.9-H0.7~ImrO x 2
SOD-123FL_L2.8-W1.8-LS3.7-BI~SOD-123FL_L2.8-W1.8-LS3.7-BI~y6qi
R0402~R0402_L1.0-W0.5-H0.4~9igT x 4
C0603~C0603_L1.6-W0.8-H0.8~tfub x 3
R0805~R0805_L2.0-W1.3-H0.6~6MmU
CONN-SMD_4P-P1.25_XUNPU_WAFER-GH1.25-4PWB~CONN-SMD_4P-P1.25_XUNPU_WAFER-GH1.25-4PWB~Us1u
SOT-23-5_L2.9-W1.6-P0.95-LS2.8-BL~SOT-23-5_L2.9-W1.6-P0.95-LS2.8-BL~bc1S
DFN-8_L3.0-W3.0-P0.65-BL-EP~DFN-8_L3.0-W3.0-H0.9-P0.65~Dx5J
SOD-123_L2.7-W1.6-LS3.7-RD~SOD-123_L2.7-W1.6-H1.4-LS3.7~3rno
SOT-23-3_L2.9-W1.3-P1.90-LS2.4-BR~SOT-23-3P_L2.9-W1.3-H1.0-LS2.4-P0.95~mSkA
