CloudEngineHub/RP1_hardware/01_Mechanic/02_Manufacturing/01_CNC/7DOF/YCL.M000324 手腕端头本体.STEP

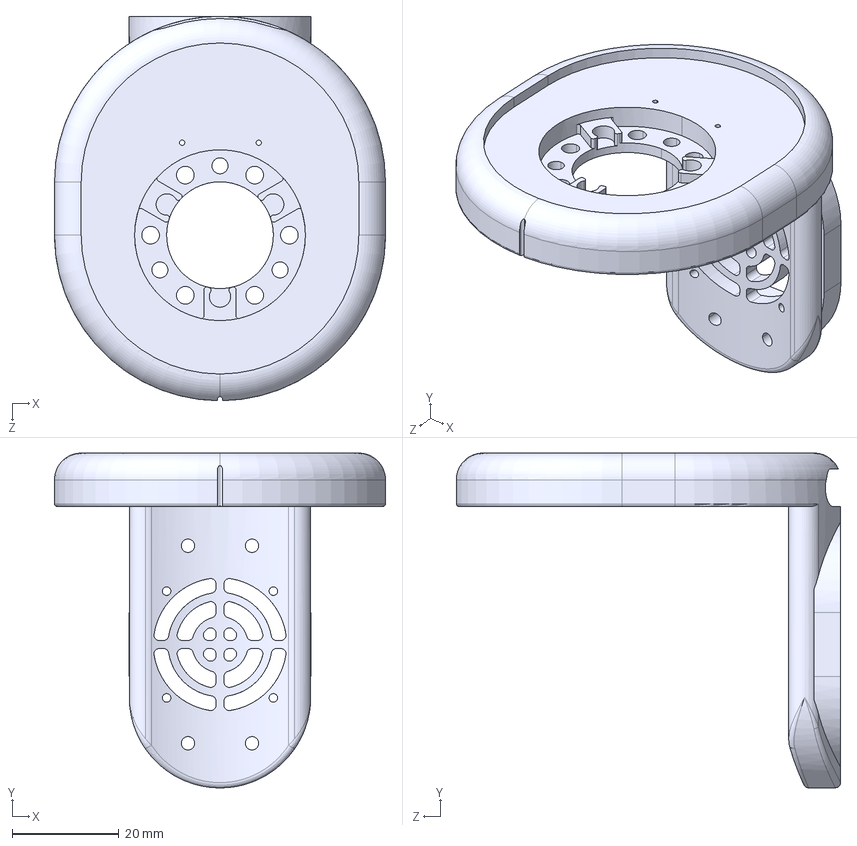
[picture p14: CAD file, 2026-09-30]
01_Mechanic/02_Manufacturing/01_CNC/7DOF/YCL.M000324 手腕端头本体.STEP
62.0 x 62.7 x 72.0 mm
