CloudEngineHub/RP1_hardware/01_Mechanic/02_Manufacturing/01_CNC/Common/YCL.M000243_风机固定块.STEP

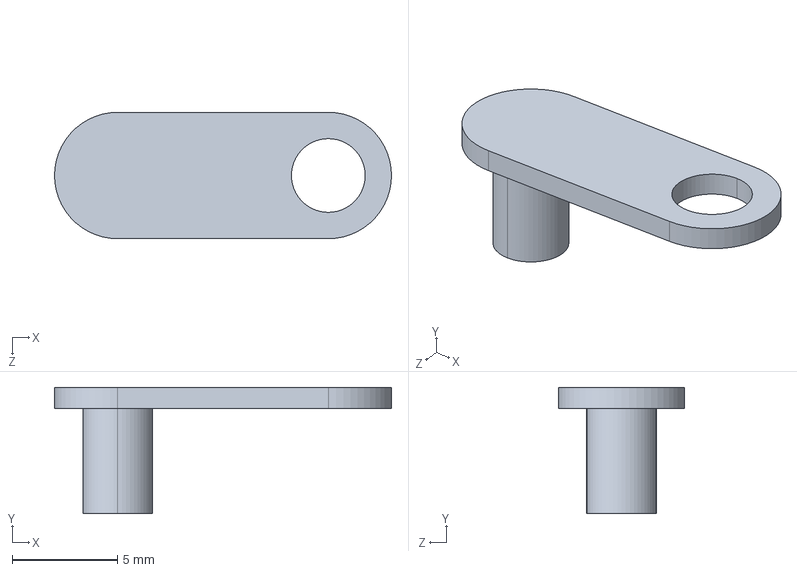
[picture p15: CAD file, 2026-09-30]
01_Mechanic/02_Manufacturing/01_CNC/Common/YCL.M000243_风机固定块.STEP
16.0 x 6.00 x 6.00 mm
