CloudEngineHub/RP1_hardware/01_Mechanic/02_Manufacturing/02_3D_Printing/STEP_3D模型/YCL.M000983 交互头走线槽.STEP

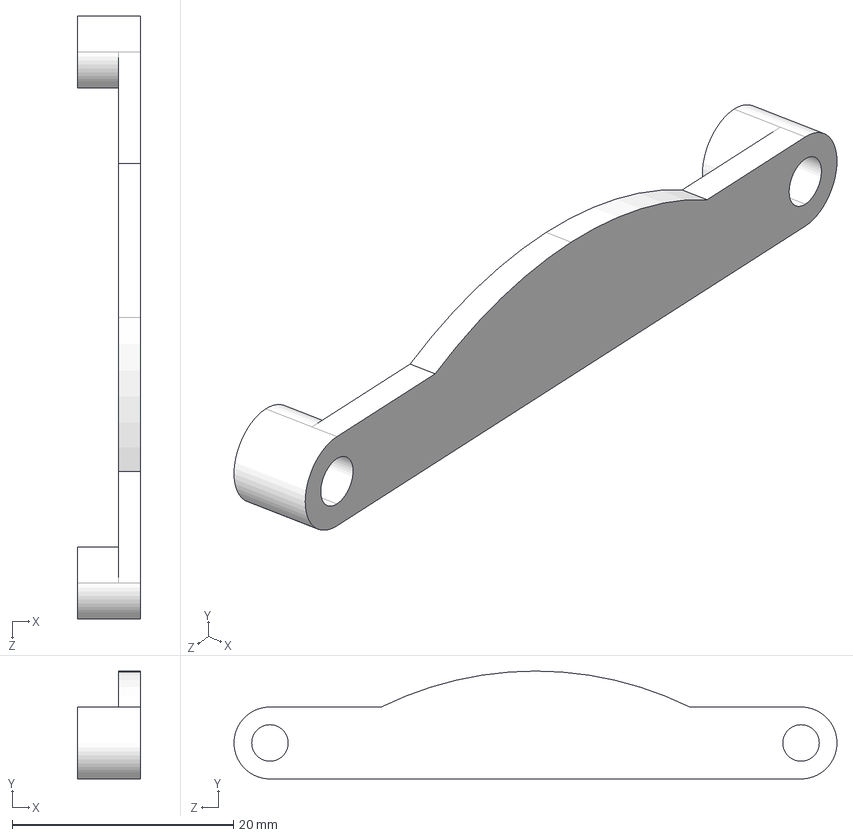
[picture p16: CAD file, 2026-09-30]
01_Mechanic/02_Manufacturing/02_3D_Printing/STEP_3D模型/YCL.M000983 交互头走线槽.STEP
5.70 x 9.75 x 54.5 mm
