CloudEngineHub/RP1_hardware/01_Mechanic/02_Manufacturing/03_Rubber/STEP_3D模型/YCL.M000371 造型手主体.STEP

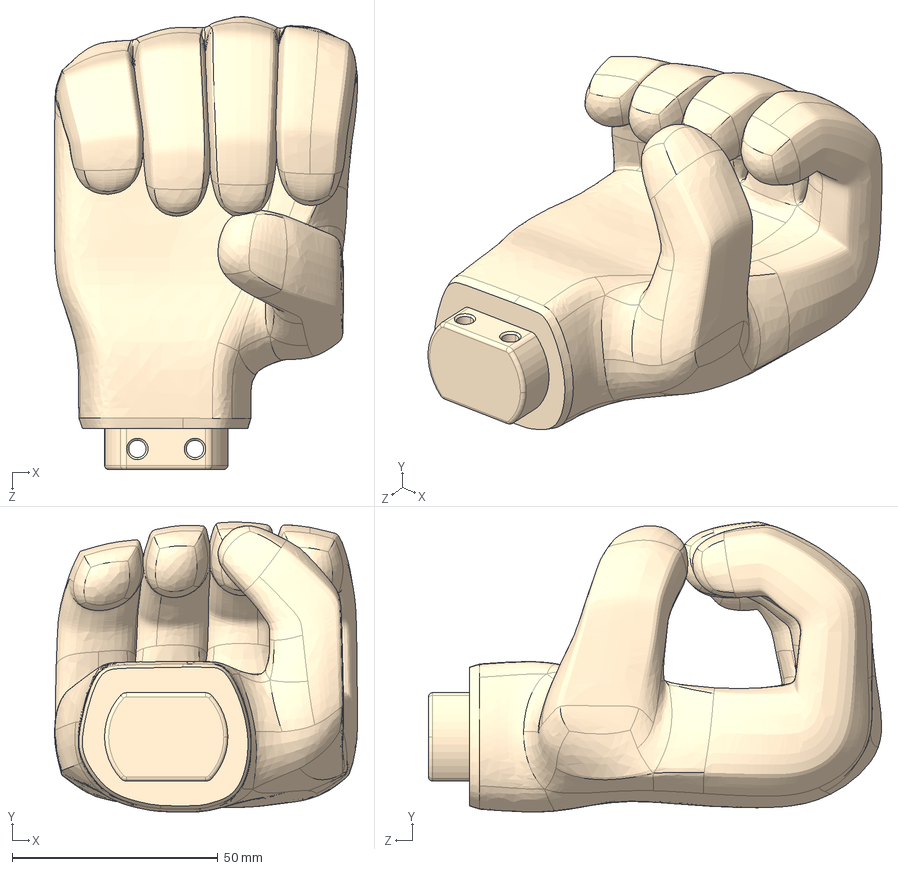
[picture p17: CAD file, 2026-09-30]
01_Mechanic/02_Manufacturing/03_Rubber/STEP_3D模型/YCL.M000371 造型手主体.STEP
73.7 x 70.5 x 110.2 mm
