CloudEngineHub/RP1_hardware/01_Mechanic/02_Manufacturing/01_CNC/5DOF/YCL.M000372 造型手本体.STEP

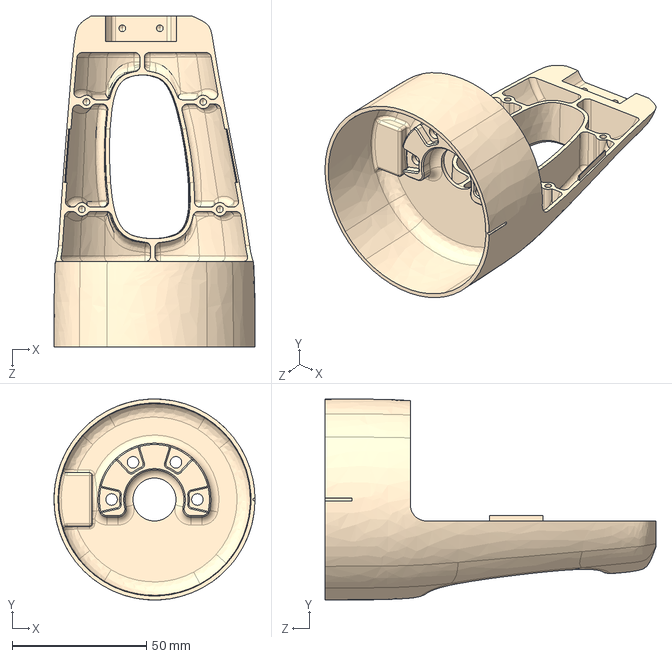
[picture p18: CAD file, 2026-09-30]
01_Mechanic/02_Manufacturing/01_CNC/5DOF/YCL.M000372 造型手本体.STEP
74.9 x 74.8 x 123.2 mm
