CloudEngineHub/RP1_hardware/01_Mechanic/02_Manufacturing/01_CNC/7DOF/YCL.M000341 55限位环.STEP

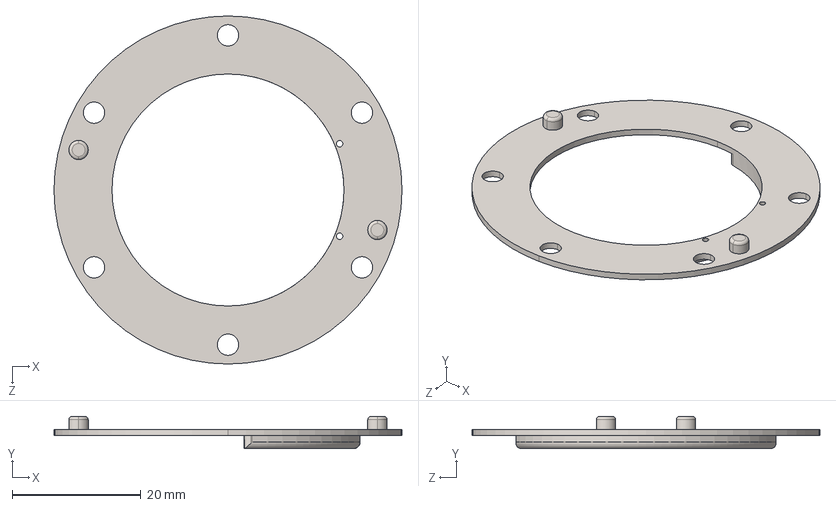
[picture p19: CAD file, 2026-09-30]
01_Mechanic/02_Manufacturing/01_CNC/7DOF/YCL.M000341 55限位环.STEP
54.0 x 5.00 x 54.0 mm
