CloudEngineHub/RP1_hardware/01_Mechanic/02_Manufacturing/01_CNC/Common/YCL.M000674 镜向大腿下本体右.STEP

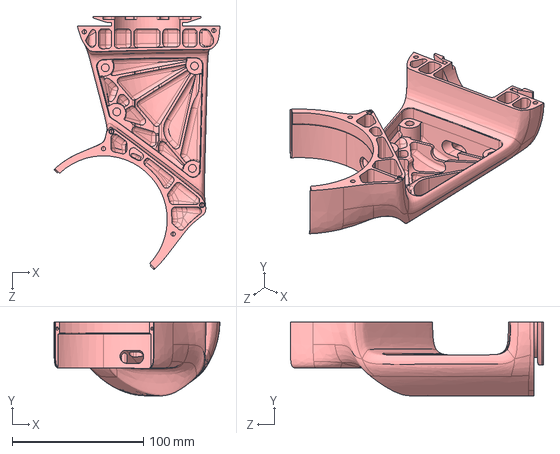
[picture p20: CAD file, 2026-09-30]
01_Mechanic/02_Manufacturing/01_CNC/Common/YCL.M000674 镜向大腿下本体右.STEP
126.3 x 56.2 x 192.7 mm
