CloudEngineHub/RP1_hardware/01_Mechanic/02_Manufacturing/02_3D_Printing/STEP_3D模型/YCL.M000787 KICKME运控头螺丝遮挡盖.STEP

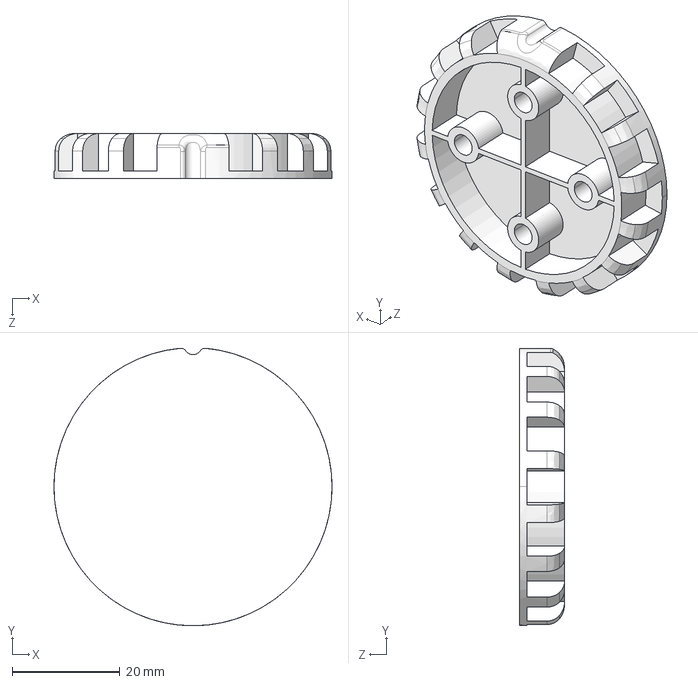
[picture p21: CAD file, 2026-09-30]
01_Mechanic/02_Manufacturing/02_3D_Printing/STEP_3D模型/YCL.M000787 KICKME运控头螺丝遮挡盖.STEP
51.7 x 51.6 x 8.36 mm
