CloudEngineHub/RP1_hardware/01_Mechanic/02_Manufacturing/03_Rubber/STEP_3D模型/YCL.M000706 kickme把手胶塞-r.STEP

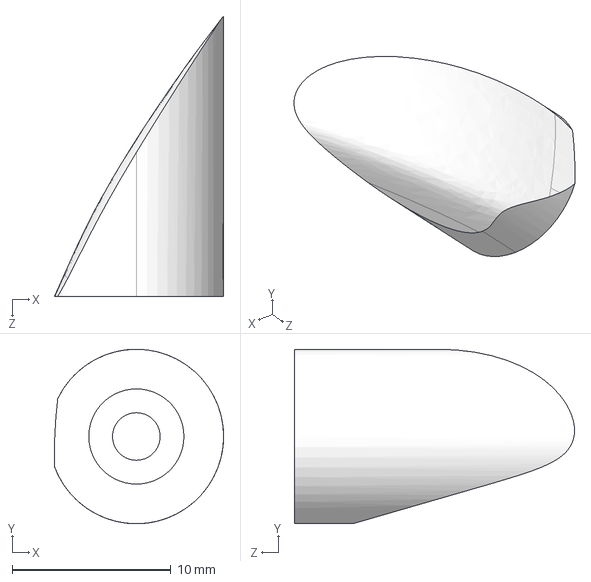
[picture p22: CAD file, 2026-09-30]
01_Mechanic/02_Manufacturing/03_Rubber/STEP_3D模型/YCL.M000706 kickme把手胶塞-r.STEP
10.7 x 11.0 x 17.7 mm
