CloudEngineHub/RP1_hardware/01_Mechanic/02_Manufacturing/01_CNC/Common/YCL.M000451 镜向小腿脚踝分离块.STEP

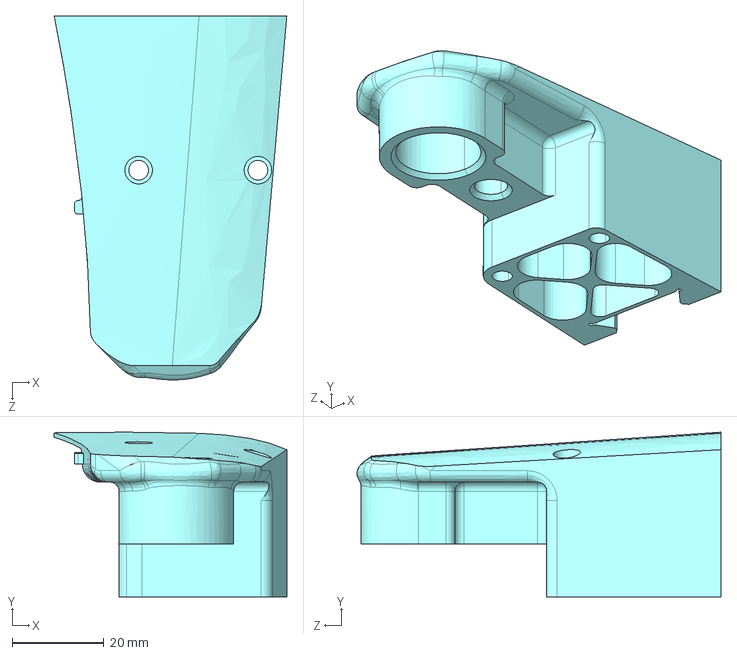
[picture p23: CAD file, 2026-09-30]
01_Mechanic/02_Manufacturing/01_CNC/Common/YCL.M000451 镜向小腿脚踝分离块.STEP
50.7 x 35.9 x 79.4 mm
