CloudEngineHub/RP1_hardware/01_Mechanic/02_Manufacturing/02_3D_Printing/STEP_3D模型/YCL.M000747 后壳卡扣件.STEP

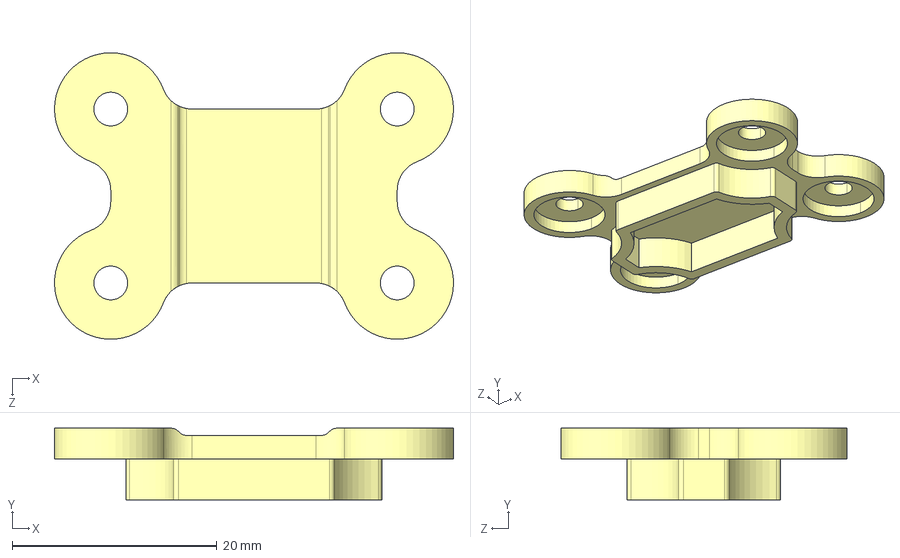
[picture p24: CAD file, 2026-09-30]
01_Mechanic/02_Manufacturing/02_3D_Printing/STEP_3D模型/YCL.M000747 后壳卡扣件.STEP
39.0 x 7.00 x 28.0 mm
