CloudEngineHub/RP1_hardware/01_Mechanic/02_Manufacturing/03_Rubber/STEP_3D模型/YCL.M000290_髋关节橡胶盖板.STEP

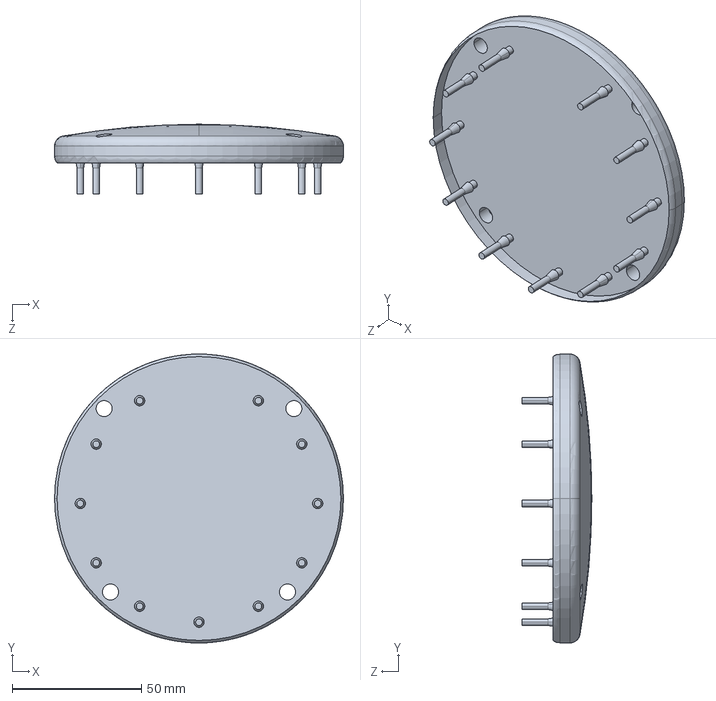
[picture p25: CAD file, 2026-09-30]
01_Mechanic/02_Manufacturing/03_Rubber/STEP_3D模型/YCL.M000290_髋关节橡胶盖板.STEP
112.0 x 111.9 x 27.0 mm
