CloudEngineHub/RP1_hardware/01_Mechanic/02_Manufacturing/01_CNC/7DOF/YCL.M000330 转接板固定件.STEP

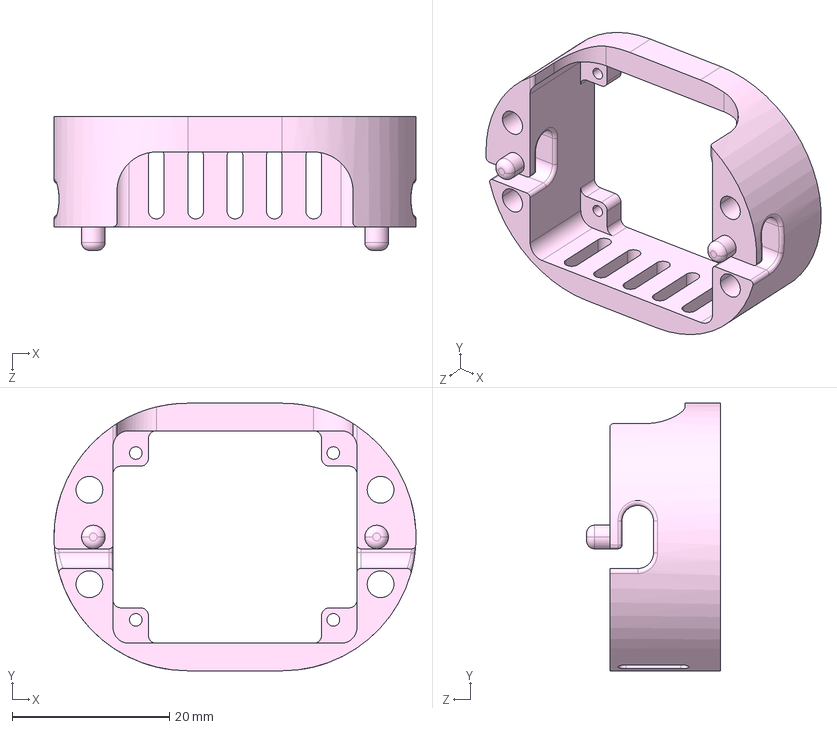
[picture p26: CAD file, 2026-09-30]
01_Mechanic/02_Manufacturing/01_CNC/7DOF/YCL.M000330 转接板固定件.STEP
46.0 x 34.0 x 17.0 mm
