CloudEngineHub/RP1_hardware/01_Mechanic/02_Manufacturing/01_CNC/Common/YCL.M000284 镜向Pitch限位.STEP

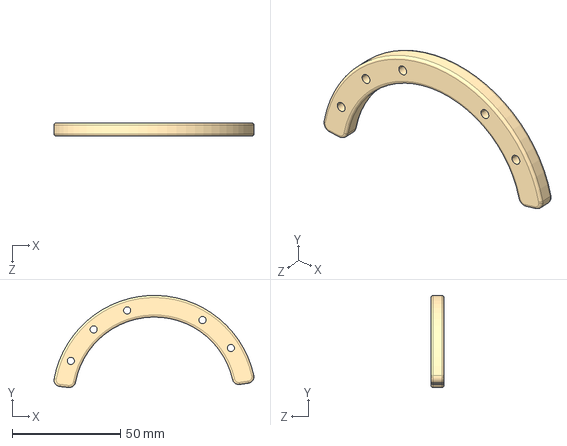
[picture p27: CAD file, 2026-09-30]
01_Mechanic/02_Manufacturing/01_CNC/Common/YCL.M000284 镜向Pitch限位.STEP
92.2 x 42.5 x 6.00 mm
