CloudEngineHub/RP1_hardware/01_Mechanic/02_Manufacturing/02_3D_Printing/STEP_3D模型/YCL.M000270 小腿压线块2.STEP

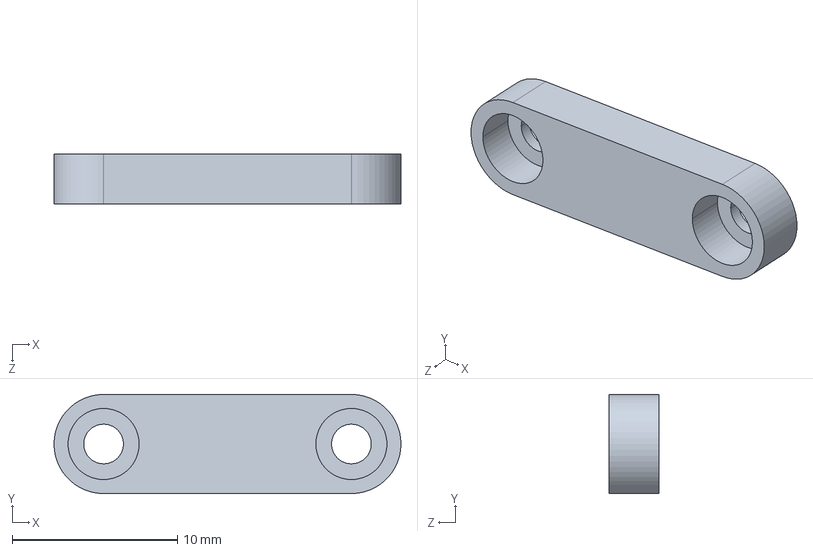
[picture p28: CAD file, 2026-09-30]
01_Mechanic/02_Manufacturing/02_3D_Printing/STEP_3D模型/YCL.M000270 小腿压线块2.STEP
21.0 x 6.00 x 3.00 mm
