CloudEngineHub/RP1_hardware/01_Mechanic/02_Manufacturing/01_CNC/Common/YCL.M000667 大腿下本体左(02版).STEP

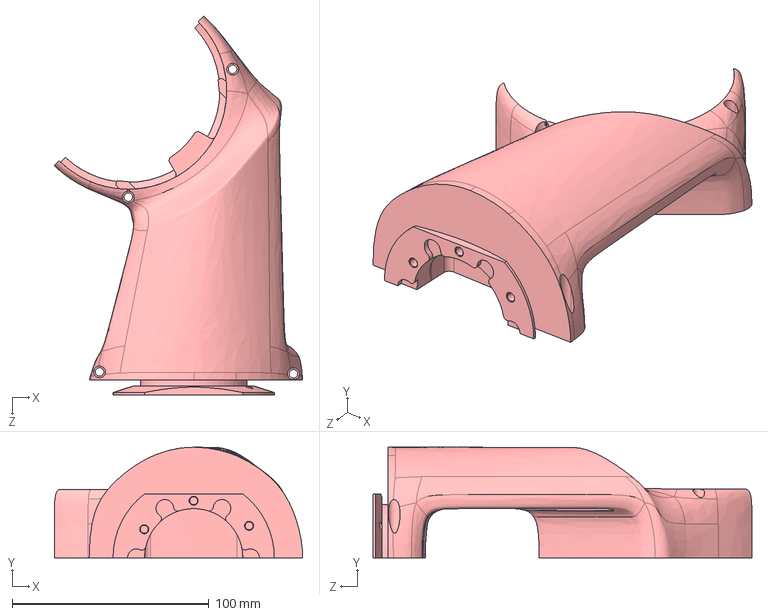
[picture p29: CAD file, 2026-09-30]
01_Mechanic/02_Manufacturing/01_CNC/Common/YCL.M000667 大腿下本体左(02版).STEP
126.3 x 56.2 x 192.7 mm
