CloudEngineHub/RP1_hardware/01_Mechanic/02_Manufacturing/02_3D_Printing/STEP_3D模型/YCL.M000443 小腿盖板.STEP

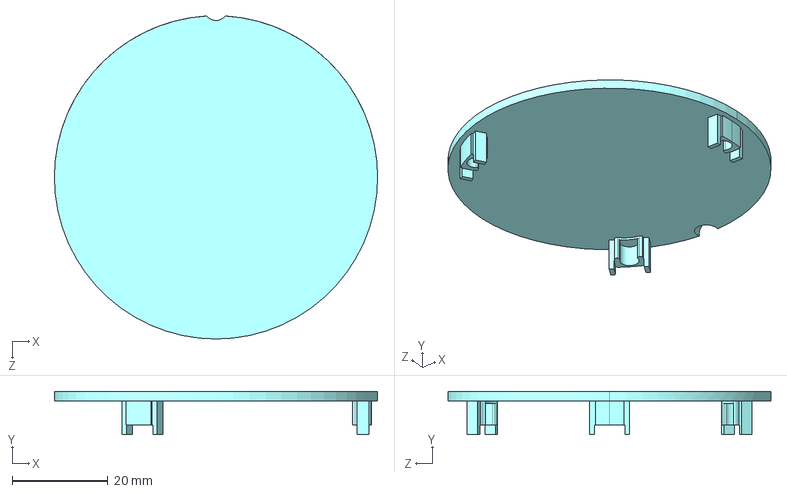
[picture p30: CAD file, 2026-09-30]
01_Mechanic/02_Manufacturing/02_3D_Printing/STEP_3D模型/YCL.M000443 小腿盖板.STEP
67.5 x 9.00 x 67.4 mm
