CloudEngineHub/RP1_hardware/01_Mechanic/02_Manufacturing/01_CNC/Common/YCL.M000562 PITCH-YAW电机连接支架.STEP

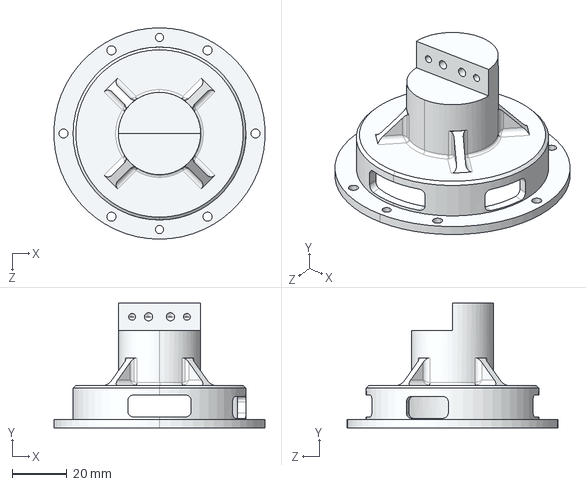
[picture p31: CAD file, 2026-09-30]
01_Mechanic/02_Manufacturing/01_CNC/Common/YCL.M000562 PITCH-YAW电机连接支架.STEP
76.9 x 45.5 x 77.0 mm
