CloudEngineHub/RP1_hardware/01_Mechanic/02_Manufacturing/02_3D_Printing/STEP_3D模型/YCL.M000822-02 交互头上外壳支架.STEP

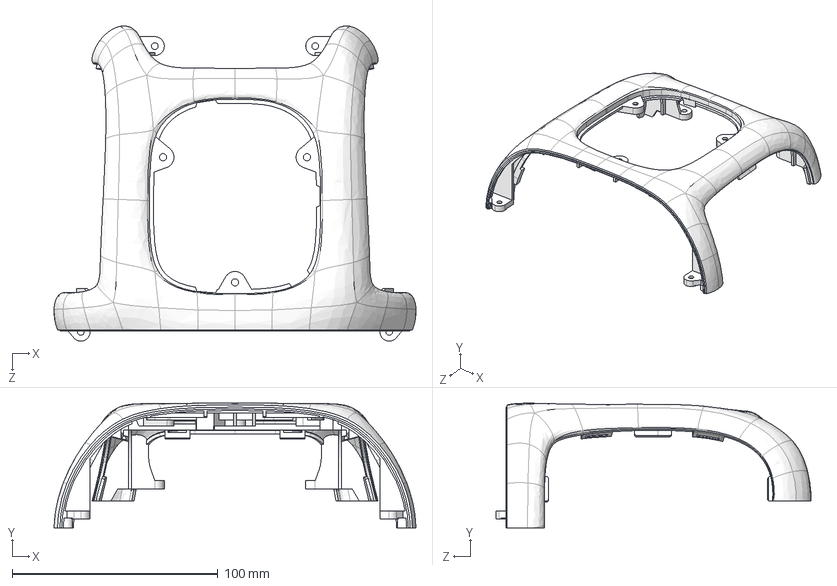
[picture p32: CAD file, 2026-09-30]
01_Mechanic/02_Manufacturing/02_3D_Printing/STEP_3D模型/YCL.M000822-02 交互头上外壳支架.STEP
176.1 x 60.7 x 153.4 mm
