CloudEngineHub/RP1_hardware/01_Mechanic/02_Manufacturing/02_3D_Printing/STEP_3D模型/YCL.M000559_腰部roll固线块.STEP

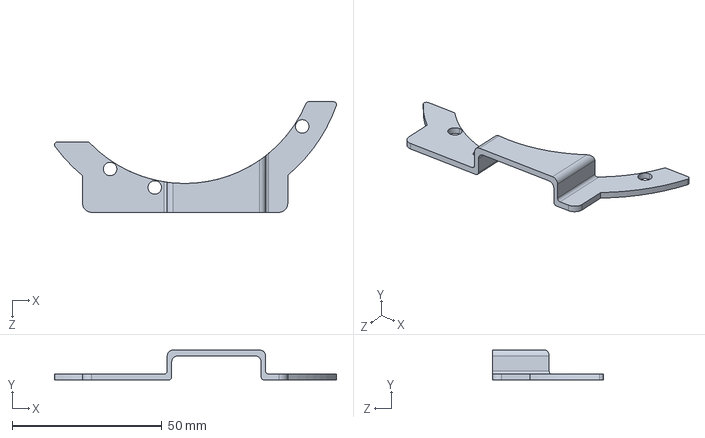
[picture p33: CAD file, 2026-09-30]
01_Mechanic/02_Manufacturing/02_3D_Printing/STEP_3D模型/YCL.M000559_腰部roll固线块.STEP
94.3 x 10.0 x 37.0 mm
