CloudEngineHub/RP1_hardware/01_Mechanic/02_Manufacturing/01_CNC/Common/YCL.M000564-02 头部PITCH电机法兰.STEP

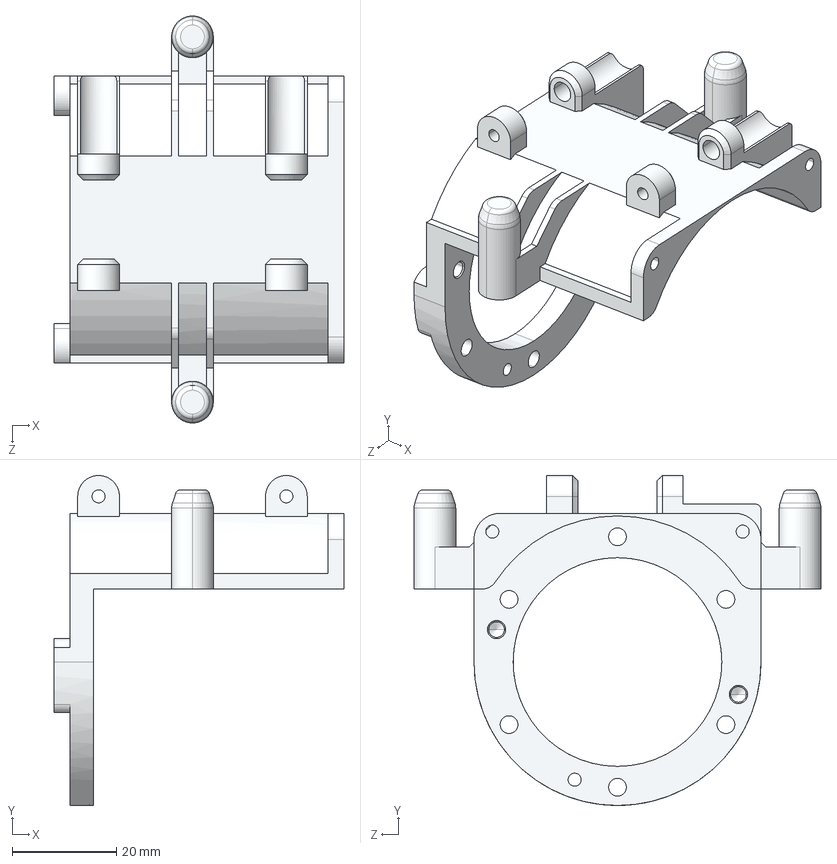
[picture p34: CAD file, 2026-09-30]
01_Mechanic/02_Manufacturing/01_CNC/Common/YCL.M000564-02 头部PITCH电机法兰.STEP
55.5 x 63.2 x 78.0 mm
