CloudEngineHub/RP1_hardware/01_Mechanic/02_Manufacturing/02_3D_Printing/STEP_3D模型/YCL.M000709 竖装背板壳.STEP

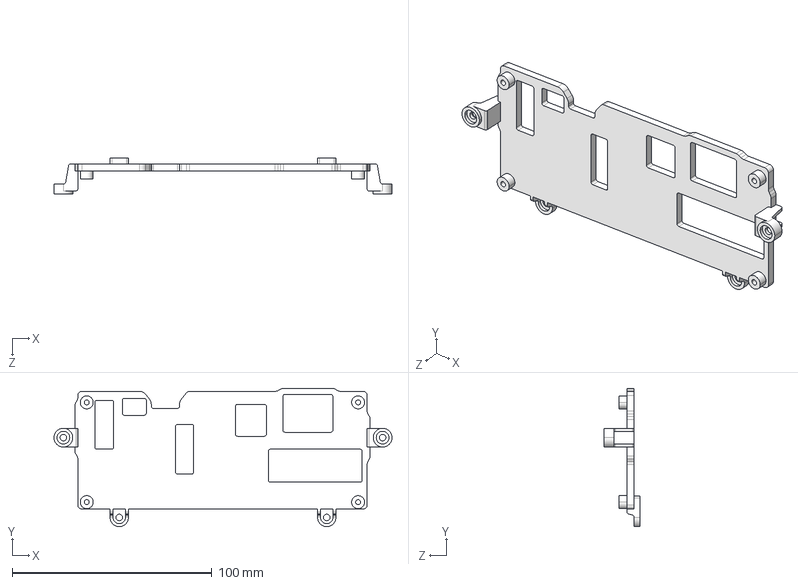
[picture p35: CAD file, 2026-09-30]
01_Mechanic/02_Manufacturing/02_3D_Printing/STEP_3D模型/YCL.M000709 竖装背板壳.STEP
169.4 x 69.3 x 18.0 mm
