CloudEngineHub/RP1_hardware/01_Mechanic/02_Manufacturing/01_CNC/Common/YCL.M000818 脚踝限位环2.STEP

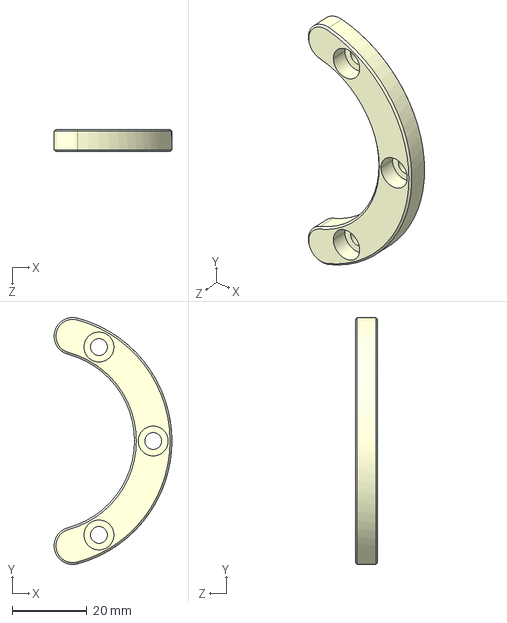
[picture p36: CAD file, 2026-09-30]
01_Mechanic/02_Manufacturing/01_CNC/Common/YCL.M000818 脚踝限位环2.STEP
31.5 x 66.0 x 6.00 mm
