CloudEngineHub/RP1_hardware/01_Mechanic/02_Manufacturing/01_CNC/Common/YCL.M000336 肘部轴承座.STEP

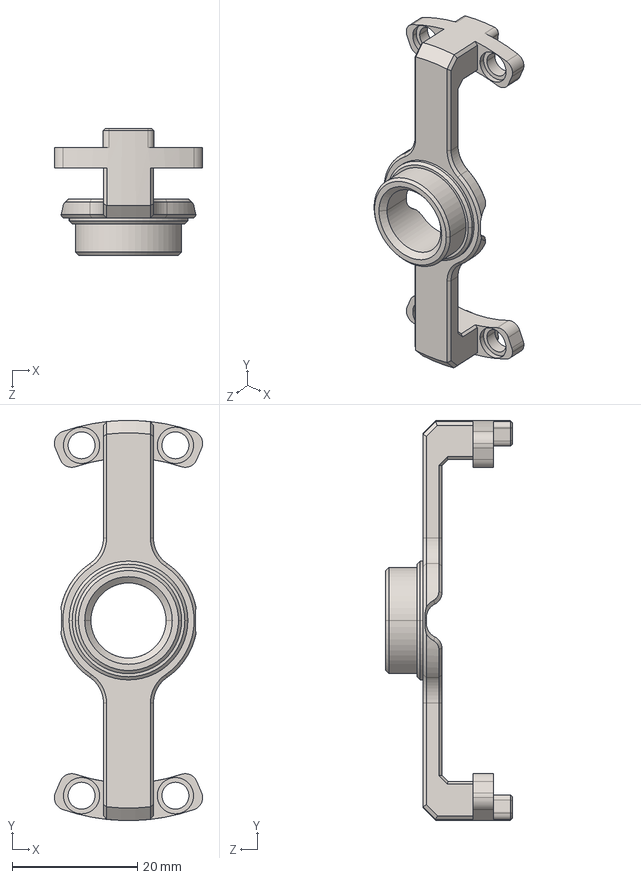
[picture p38: CAD file, 2026-09-30]
01_Mechanic/02_Manufacturing/01_CNC/Common/YCL.M000336 肘部轴承座.STEP
23.7 x 64.0 x 20.2 mm
