CloudEngineHub/RP1_hardware/01_Mechanic/02_Manufacturing/02_3D_Printing/STEP_3D模型/YCL.M000977 明美电池仓下分件.STEP

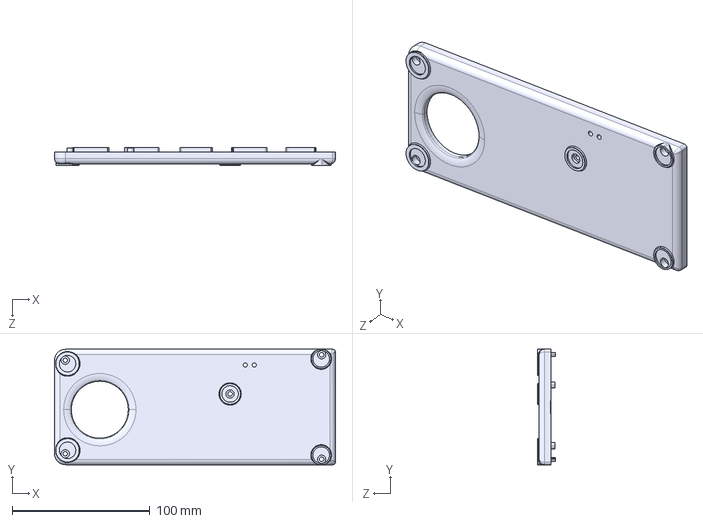
[picture p39: CAD file, 2026-09-30]
01_Mechanic/02_Manufacturing/02_3D_Printing/STEP_3D模型/YCL.M000977 明美电池仓下分件.STEP
203.8 x 83.8 x 13.0 mm
