CloudEngineHub/RP1_hardware/01_Mechanic/02_Manufacturing/01_CNC/Common/YCL.M000713-02 PC缓冲支架.STEP

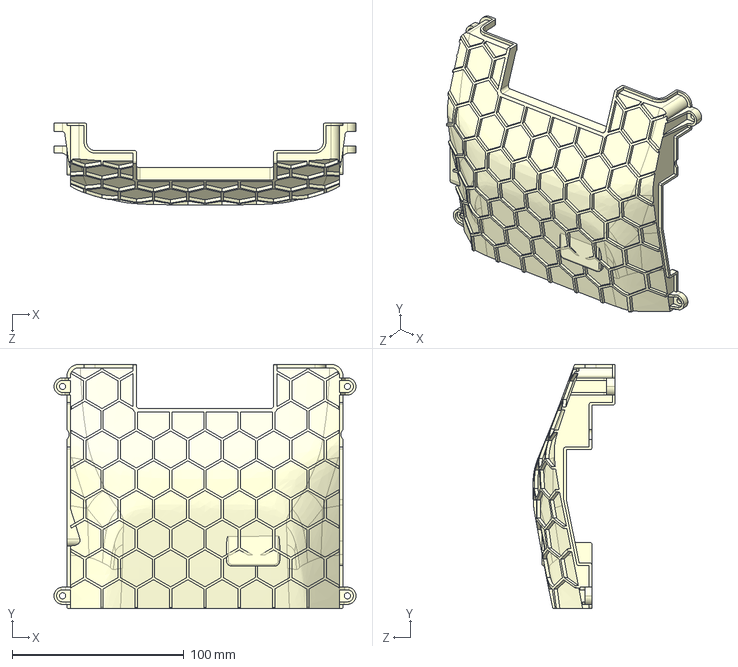
[picture p40: CAD file, 2026-09-30]
01_Mechanic/02_Manufacturing/01_CNC/Common/YCL.M000713-02 PC缓冲支架.STEP
176.0 x 142.4 x 47.8 mm
