CloudEngineHub/RP1_hardware/01_Mechanic/02_Manufacturing/02_3D_Printing/STEP_3D模型/YCL.M000710 kickme_版本电池导向支架.STEP

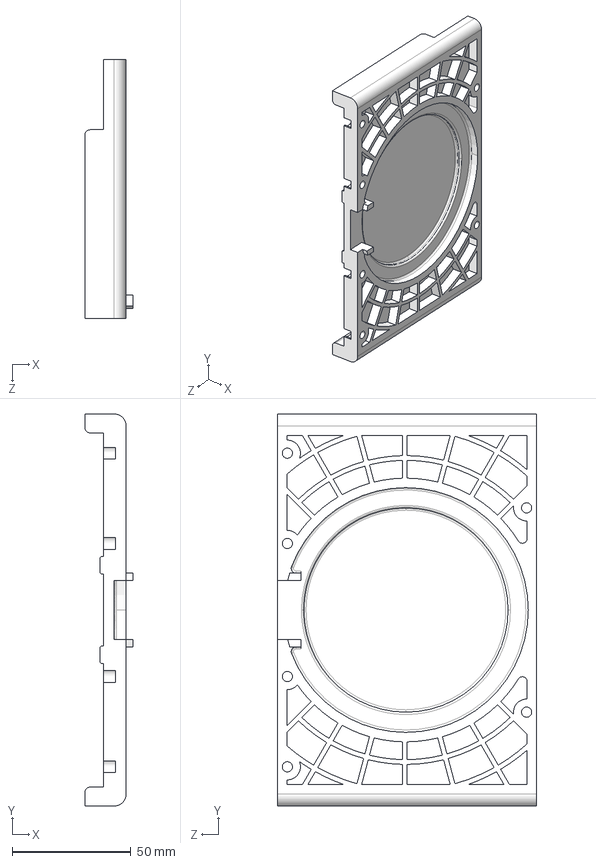
[picture p41: CAD file, 2026-09-30]
01_Mechanic/02_Manufacturing/02_3D_Printing/STEP_3D模型/YCL.M000710 kickme_版本电池导向支架.STEP
20.4 x 165.0 x 109.1 mm
