CloudEngineHub/RP1_hardware/01_Mechanic/02_Manufacturing/01_CNC/Common/YCL.M000644 大臂下前分件(01版).STEP

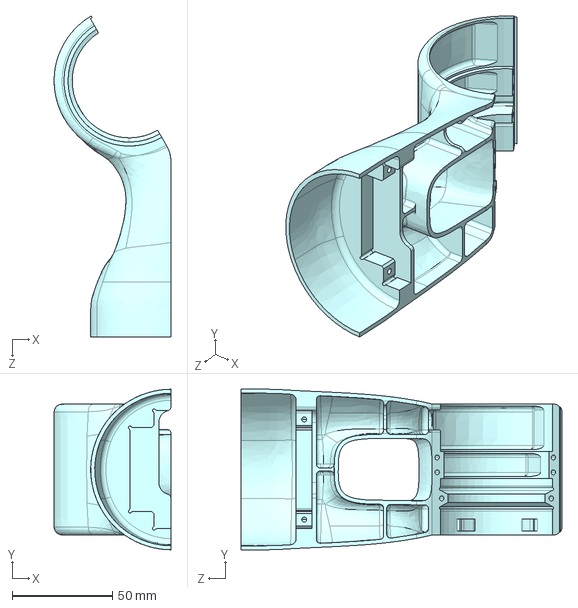
[picture p42: CAD file, 2026-09-30]
01_Mechanic/02_Manufacturing/01_CNC/Common/YCL.M000644 大臂下前分件(01版).STEP
58.2 x 80.0 x 160.0 mm
