CloudEngineHub/RP1_hardware/01_Mechanic/02_Manufacturing/02_3D_Printing/STEP_3D模型/YCL.M000402 镜向75肩部盖子.STEP

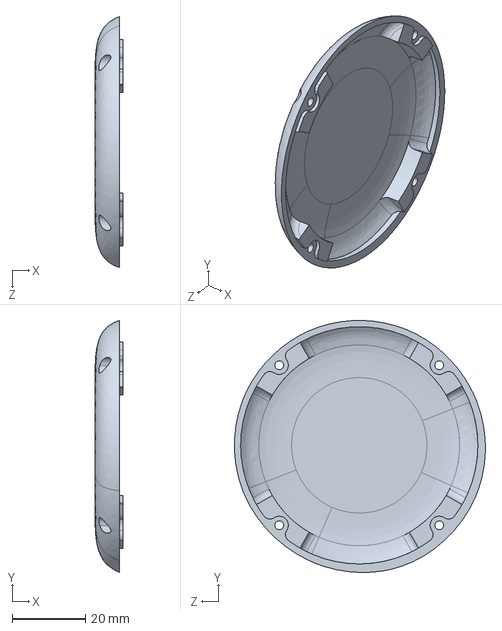
[picture p43: CAD file, 2026-09-30]
01_Mechanic/02_Manufacturing/02_3D_Printing/STEP_3D模型/YCL.M000402 镜向75肩部盖子.STEP
7.64 x 69.0 x 68.7 mm
