CloudEngineHub/RP1_hardware/01_Mechanic/02_Manufacturing/01_CNC/Common/YCL.M000640 75肩部抱箍（01版）.STEP

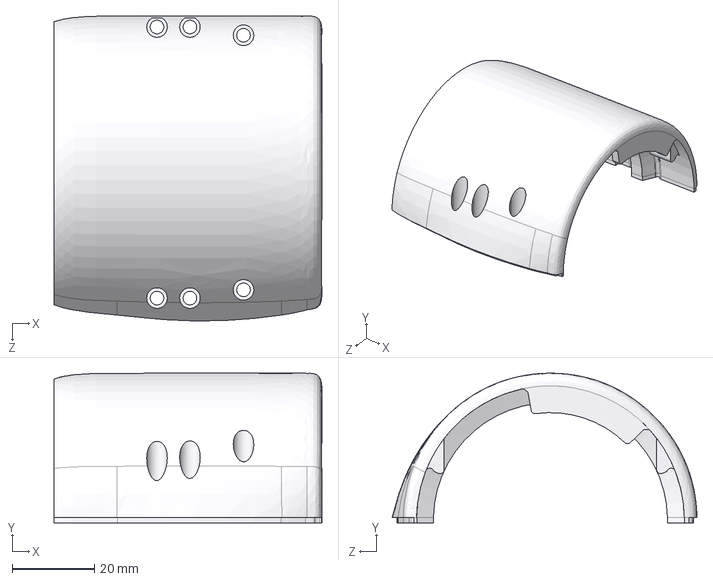
[picture p44: CAD file, 2026-09-30]
01_Mechanic/02_Manufacturing/01_CNC/Common/YCL.M000640 75肩部抱箍（01版）.STEP
65.0 x 36.3 x 74.0 mm
