CloudEngineHub/RP1_hardware/01_Mechanic/02_Manufacturing/02_3D_Printing/STEP_3D模型/YCL.M000928 颈部理线夹.STEP

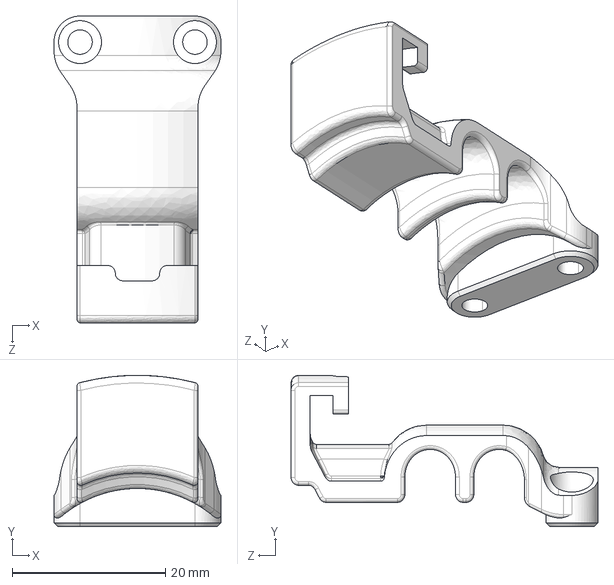
[picture p45: CAD file, 2026-09-30]
01_Mechanic/02_Manufacturing/02_3D_Printing/STEP_3D模型/YCL.M000928 颈部理线夹.STEP
21.8 x 19.7 x 40.1 mm
