CloudEngineHub/RP1_hardware/01_Mechanic/02_Manufacturing/01_CNC/Common/YCL.M000649 镜向小臂上本体右（02版）.STEP

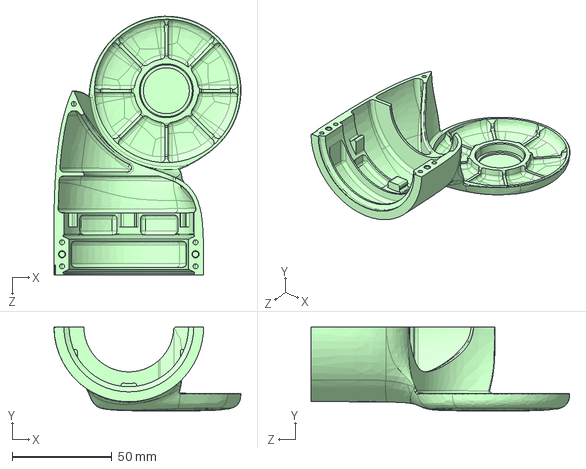
[picture p46: CAD file, 2026-09-30]
01_Mechanic/02_Manufacturing/01_CNC/Common/YCL.M000649 镜向小臂上本体右（02版）.STEP
93.6 x 41.9 x 129.4 mm
