CloudEngineHub/RP1_hardware/01_Mechanic/02_Manufacturing/02_3D_Printing/STEP_3D模型/YCL.M000826-02 交互头后装饰盖.STEP

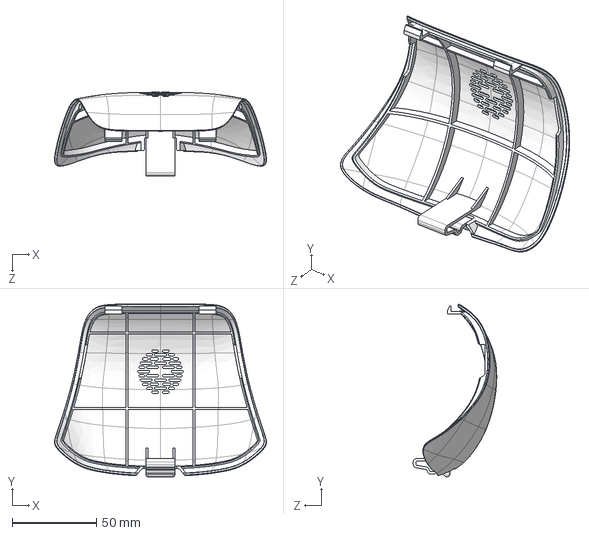
[picture p47: CAD file, 2026-09-30]
01_Mechanic/02_Manufacturing/02_3D_Printing/STEP_3D模型/YCL.M000826-02 交互头后装饰盖.STEP
125.9 x 102.6 x 49.6 mm
