CloudEngineHub/RP1_hardware/01_Mechanic/02_Manufacturing/01_CNC/Common/YCL.M000486 大腿下盖板右.STEP

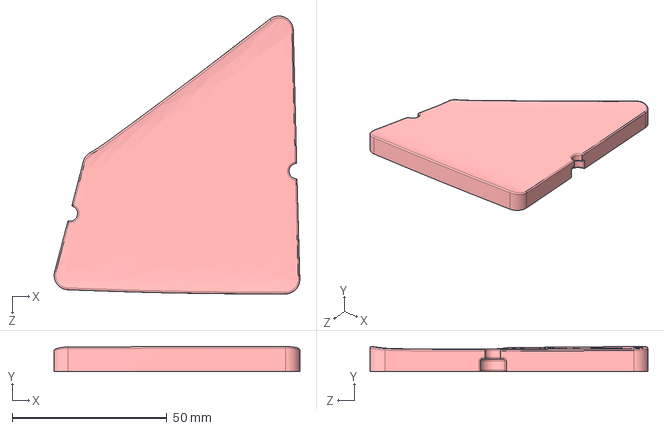
[picture p48: CAD file, 2026-09-30]
01_Mechanic/02_Manufacturing/01_CNC/Common/YCL.M000486 大腿下盖板右.STEP
79.4 x 8.15 x 89.8 mm
