CloudEngineHub/RP1_hardware/01_Mechanic/02_Manufacturing/01_CNC/Common/YCL.M000646 小臂上本体左（02版）.STEP

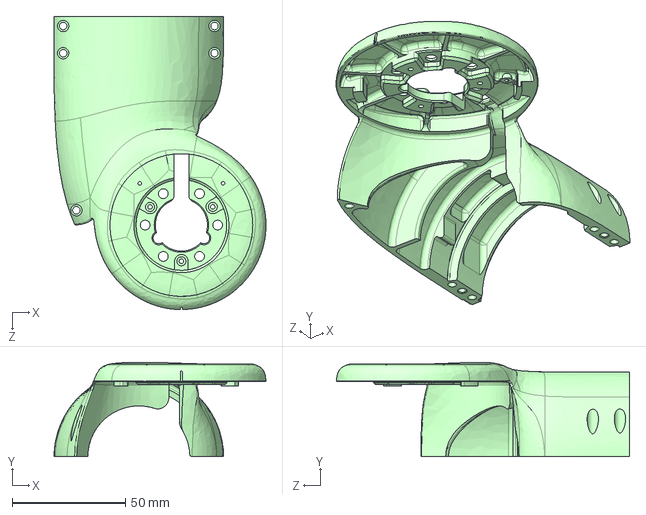
[picture p50: CAD file, 2026-09-30]
01_Mechanic/02_Manufacturing/01_CNC/Common/YCL.M000646 小臂上本体左（02版）.STEP
93.6 x 41.6 x 129.4 mm
