CloudEngineHub/RP1_hardware/01_Mechanic/02_Manufacturing/02_3D_Printing/STEP_3D模型/YCL.M000930 背板FPC压板.STEP

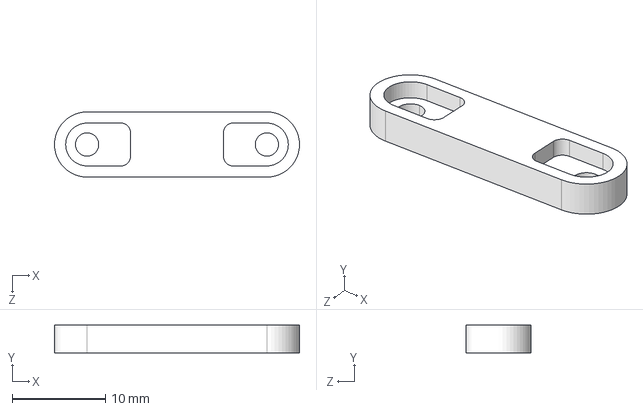
[picture p51: CAD file, 2026-09-30]
01_Mechanic/02_Manufacturing/02_3D_Printing/STEP_3D模型/YCL.M000930 背板FPC压板.STEP
26.3 x 3.00 x 7.00 mm
