CloudEngineHub/RP1_hardware/01_Mechanic/02_Manufacturing/01_CNC/Common/YCL.M000453 镜向小腿本体右.STEP

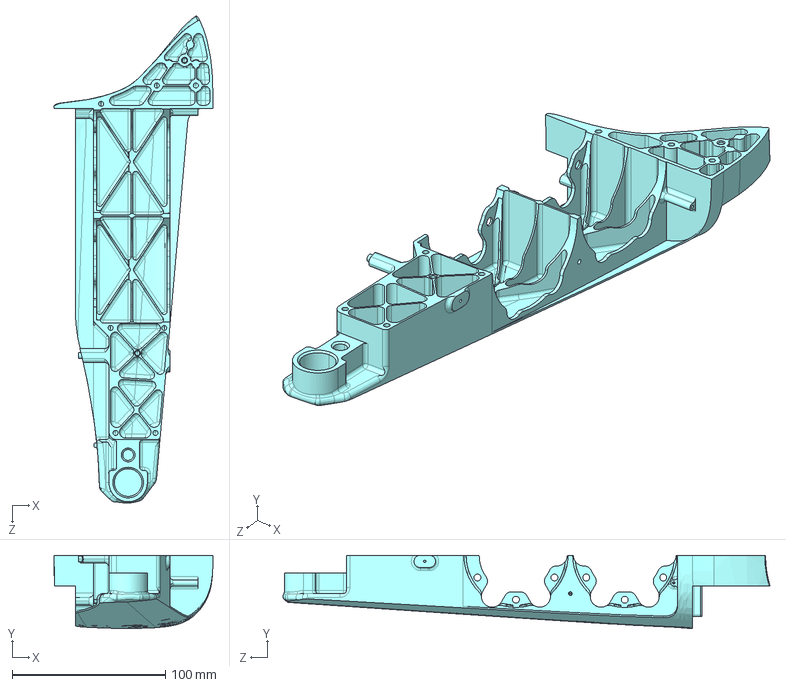
[picture p52: CAD file, 2026-09-30]
01_Mechanic/02_Manufacturing/01_CNC/Common/YCL.M000453 镜向小腿本体右.STEP
103.7 x 47.9 x 317.8 mm
