CloudEngineHub/RP1_hardware/01_Mechanic/02_Manufacturing/02_3D_Printing/STEP_3D模型/YCL.M000824-02 交互头SOC板主体支架.STEP

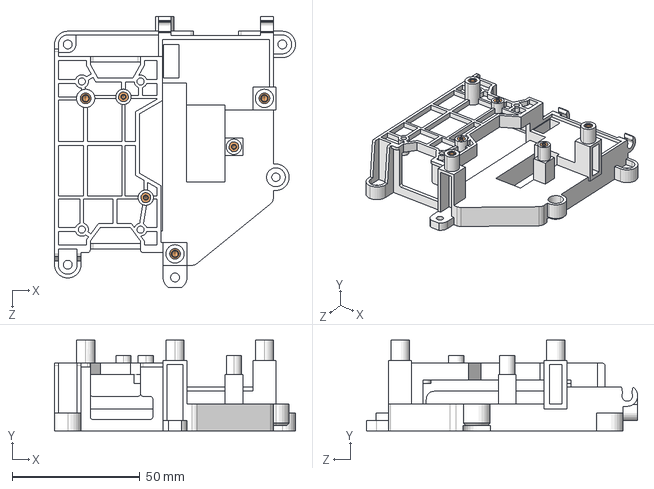
[picture p53: CAD file, 2026-09-30]
01_Mechanic/02_Manufacturing/02_3D_Printing/STEP_3D模型/YCL.M000824-02 交互头SOC板主体支架.STEP
94.4 x 35.5 x 106.3 mm
