CloudEngineHub/RP1_hardware/01_Mechanic/02_Manufacturing/01_CNC/Common/YCL.M000477 大腿卡箍前.STEP

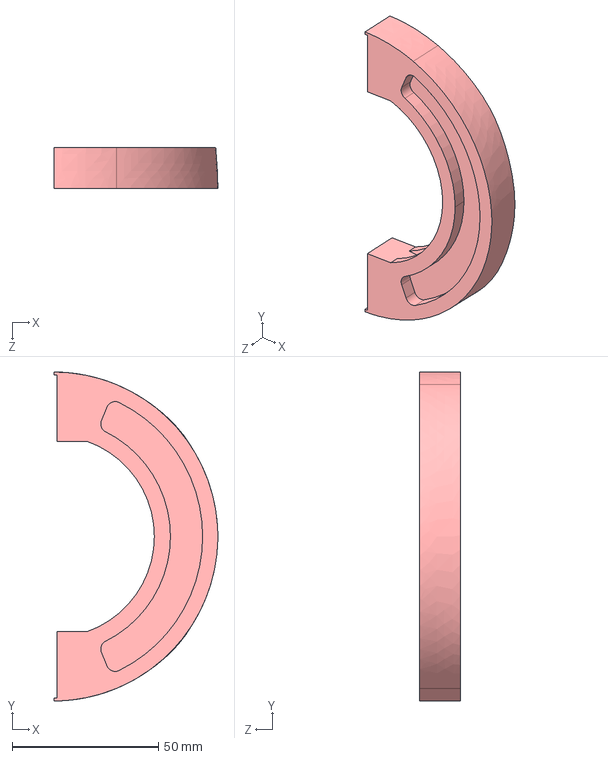
[picture p54: CAD file, 2026-09-30]
01_Mechanic/02_Manufacturing/01_CNC/Common/YCL.M000477 大腿卡箍前.STEP
56.0 x 112.4 x 14.0 mm
