CloudEngineHub/RP1_hardware/01_Mechanic/02_Manufacturing/02_3D_Printing/STEP_3D模型/YCL.M000340 手臂压线块5.STEP

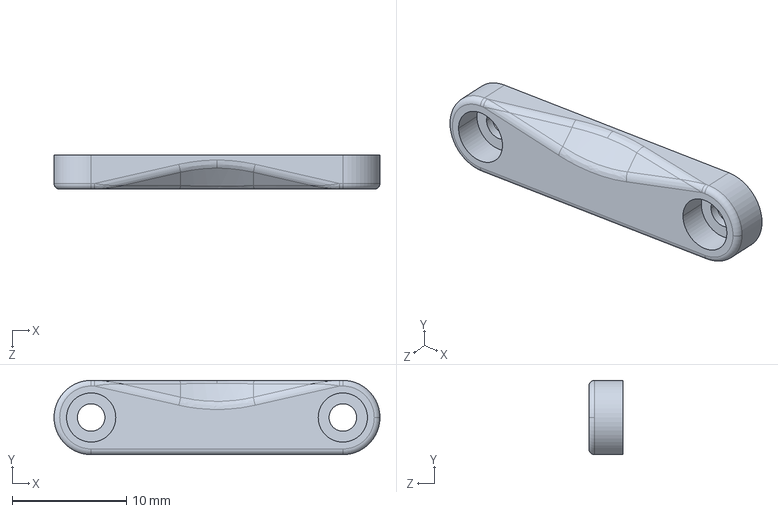
[picture p55: CAD file, 2026-09-30]
01_Mechanic/02_Manufacturing/02_3D_Printing/STEP_3D模型/YCL.M000340 手臂压线块5.STEP
28.5 x 6.50 x 3.00 mm
