CloudEngineHub/RP1_hardware/01_Mechanic/02_Manufacturing/01_CNC/Common/YCL.M000722 脚板.STEP

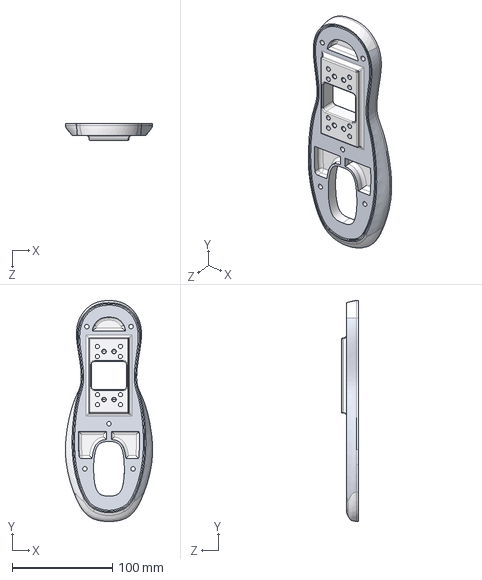
[picture p56: CAD file, 2026-09-30]
01_Mechanic/02_Manufacturing/01_CNC/Common/YCL.M000722 脚板.STEP
87.2 x 220.7 x 17.0 mm
