CloudEngineHub/RP1_hardware/01_Mechanic/02_Manufacturing/01_CNC/Common/YCL.M000746 前壳卡扣件.STEP

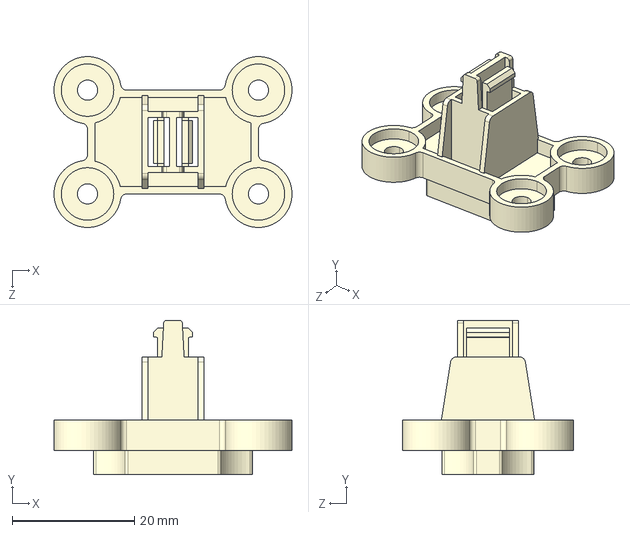
[picture p57: CAD file, 2026-09-30]
01_Mechanic/02_Manufacturing/01_CNC/Common/YCL.M000746 前壳卡扣件.STEP
39.0 x 25.3 x 28.0 mm
