CloudEngineHub/RP1_hardware/01_Mechanic/02_Manufacturing/02_3D_Printing/STEP_3D模型/YCL.M000827-02 交互头侧装饰盖-L.STEP

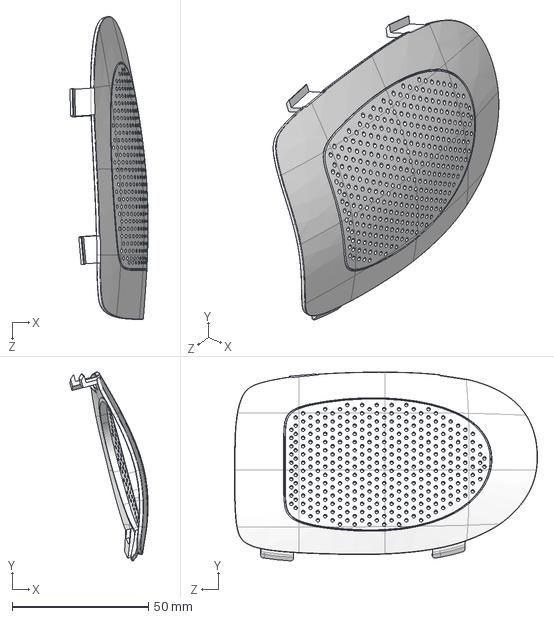
[picture p58: CAD file, 2026-09-30]
01_Mechanic/02_Manufacturing/02_3D_Printing/STEP_3D模型/YCL.M000827-02 交互头侧装饰盖-L.STEP
28.7 x 69.4 x 111.3 mm
