CloudEngineHub/RP1_hardware/01_Mechanic/02_Manufacturing/02_3D_Printing/STEP_3D模型/YCL.M000819-02 交互头外壳前盖.STEP

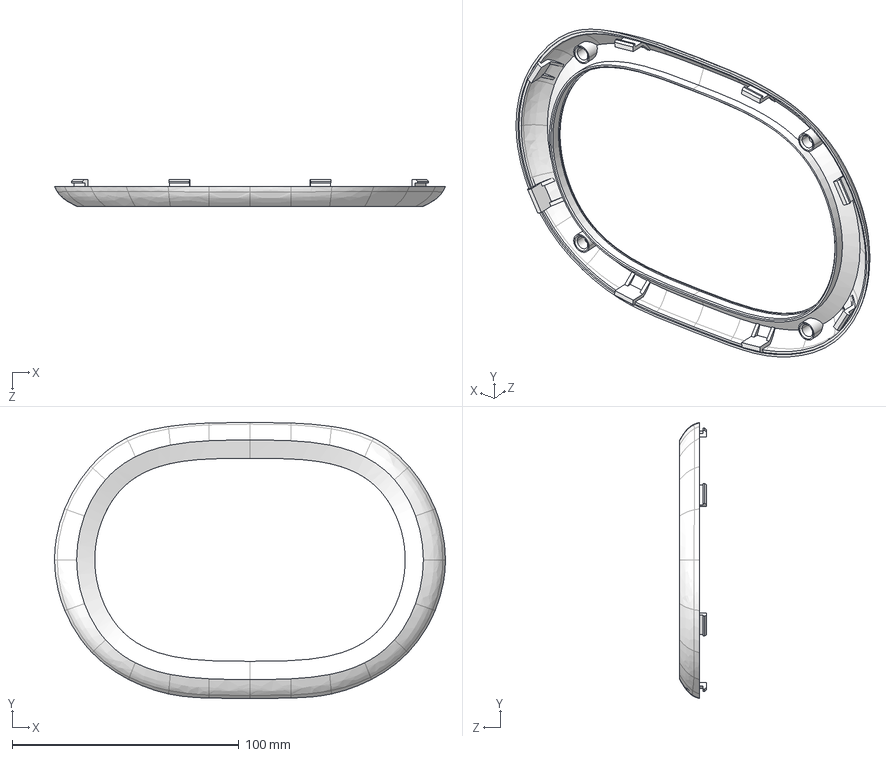
[picture p60: CAD file, 2026-09-30]
01_Mechanic/02_Manufacturing/02_3D_Printing/STEP_3D模型/YCL.M000819-02 交互头外壳前盖.STEP
172.5 x 121.8 x 11.8 mm
