CloudEngineHub/RP1_hardware/01_Mechanic/02_Manufacturing/01_CNC/Common/YCL.M000717-03 kickme版本躯干前壳.STEP

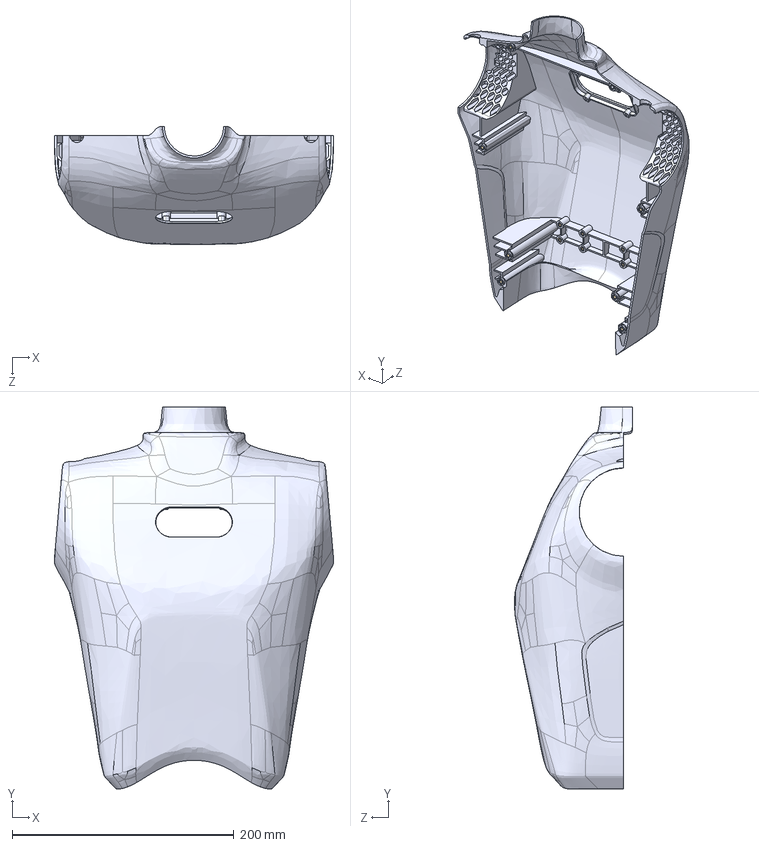
[picture p61: CAD file, 2026-09-30]
01_Mechanic/02_Manufacturing/01_CNC/Common/YCL.M000717-03 kickme版本躯干前壳.STEP
252.0 x 344.5 x 106.2 mm
