CloudEngineHub/RP1_hardware/01_Mechanic/02_Manufacturing/02_3D_Printing/STEP_3D模型/YCL.M000311 小臂下盖子.STEP

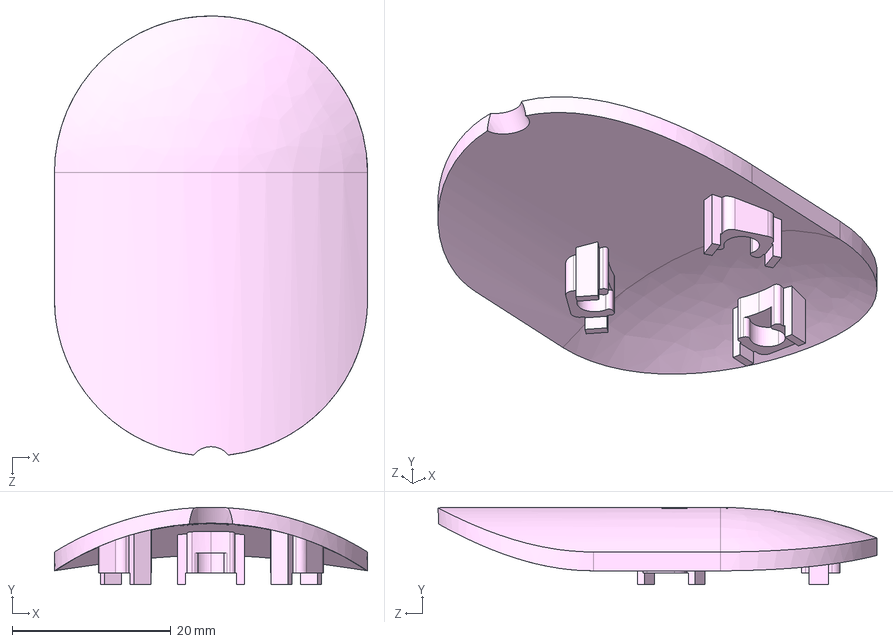
[picture p62: CAD file, 2026-09-30]
01_Mechanic/02_Manufacturing/02_3D_Printing/STEP_3D模型/YCL.M000311 小臂下盖子.STEP
39.5 x 9.75 x 55.4 mm
