CloudEngineHub/RP1_hardware/01_Mechanic/02_Manufacturing/01_CNC/Common/YCL.M000704 kickme版本躯干框架.STEP

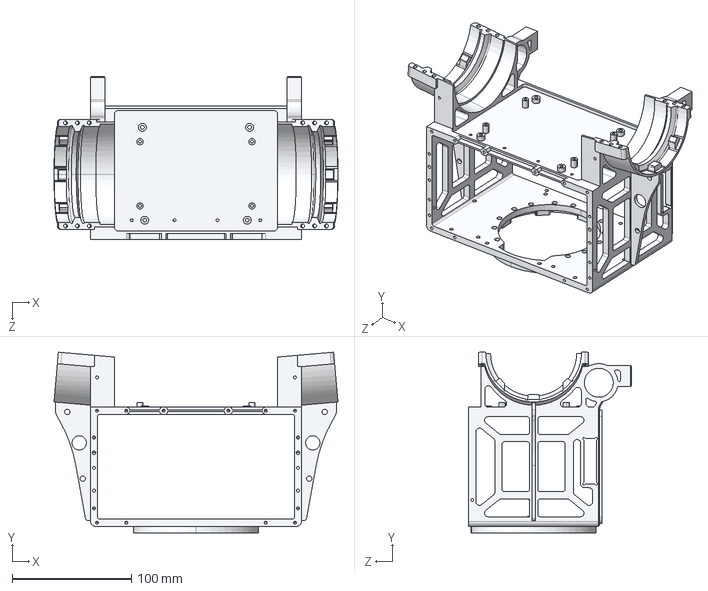
[picture p63: CAD file, 2026-09-30]
01_Mechanic/02_Manufacturing/01_CNC/Common/YCL.M000704 kickme版本躯干框架.STEP
238.4 x 151.7 x 136.5 mm
