CloudEngineHub/RP1_hardware/01_Mechanic/02_Manufacturing/02_3D_Printing/STEP_3D模型/YCL.M000718 达妙orin支架.STEP

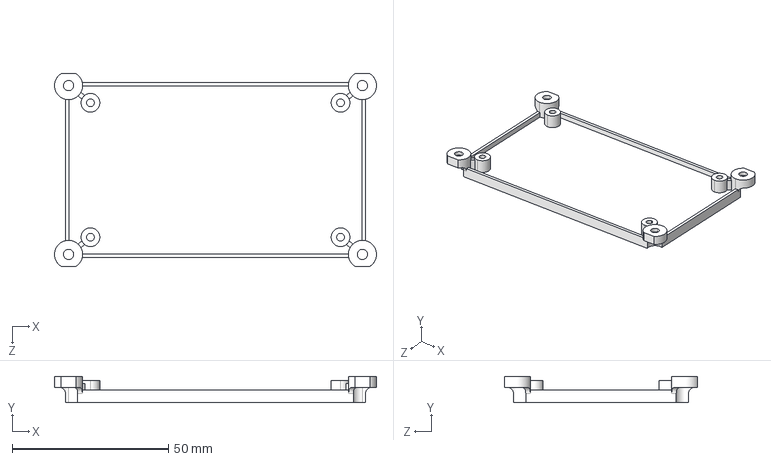
[picture p64: CAD file, 2026-09-30]
01_Mechanic/02_Manufacturing/02_3D_Printing/STEP_3D模型/YCL.M000718 达妙orin支架.STEP
103.0 x 8.40 x 61.6 mm
