CloudEngineHub/RP1_hardware/01_Mechanic/02_Manufacturing/01_CNC/Common/YCL.M000347_风机固定支架（腰部）.STEP

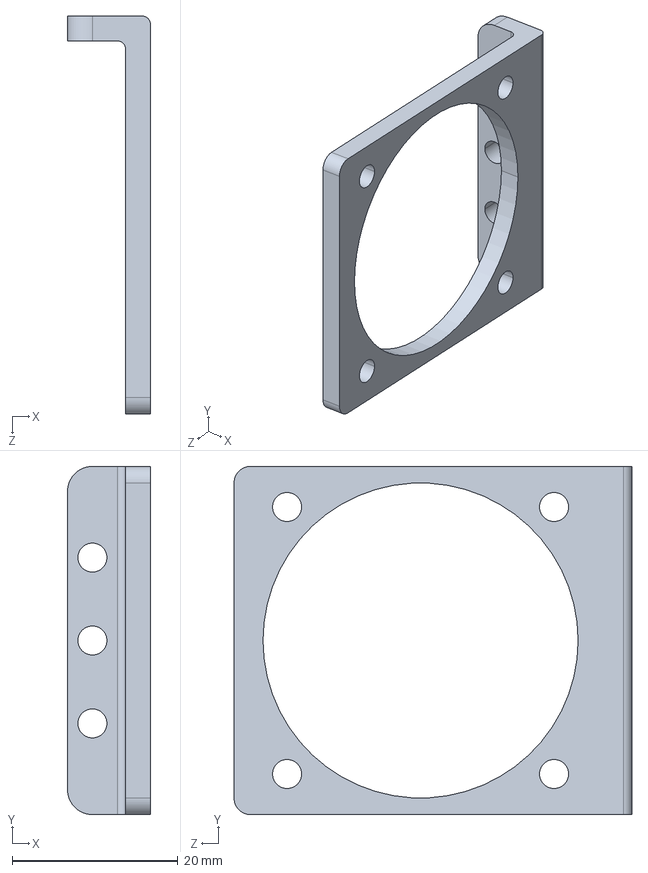
[picture p65: CAD file, 2026-09-30]
01_Mechanic/02_Manufacturing/01_CNC/Common/YCL.M000347_风机固定支架（腰部）.STEP
10.0 x 42.0 x 48.0 mm
