CloudEngineHub/RP1_hardware/01_Mechanic/02_Manufacturing/01_CNC/Common/YCL.M000226_腰部Roll限位环.STEP

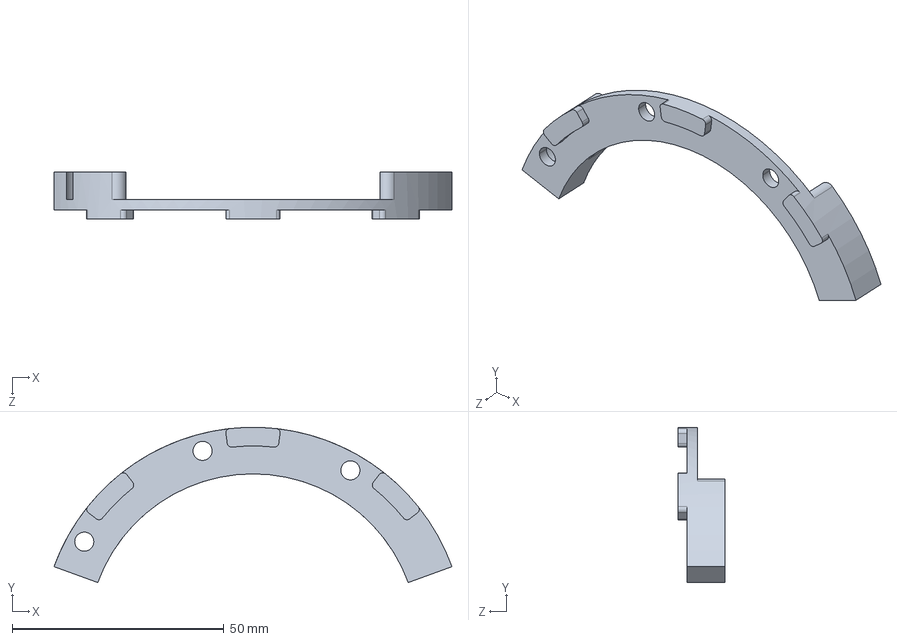
[picture p66: CAD file, 2026-09-30]
01_Mechanic/02_Manufacturing/01_CNC/Common/YCL.M000226_腰部Roll限位环.STEP
94.0 x 36.6 x 11.2 mm
