CloudEngineHub/RP1_hardware/01_Mechanic/02_Manufacturing/01_CNC/Common/YCL.M000332 手臂转接法兰.STEP

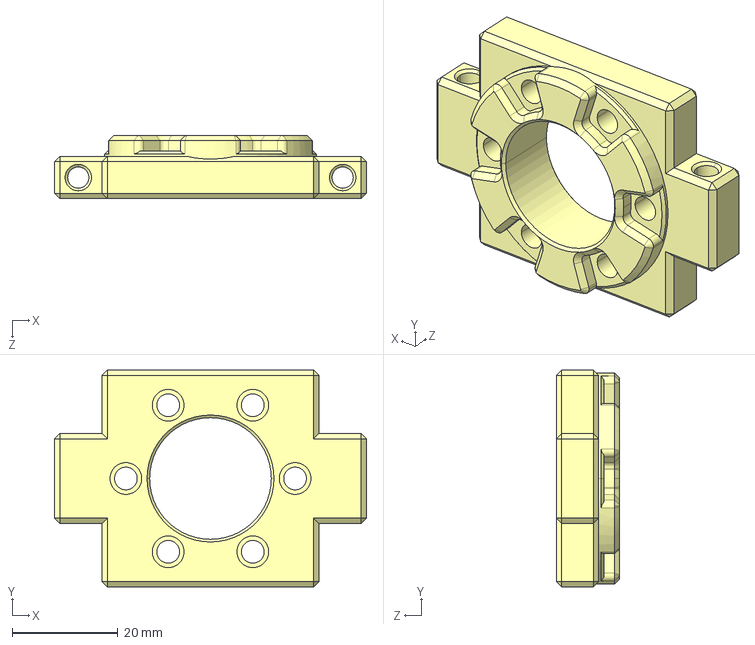
[picture p67: CAD file, 2026-09-30]
01_Mechanic/02_Manufacturing/01_CNC/Common/YCL.M000332 手臂转接法兰.STEP
59.0 x 41.0 x 12.0 mm
