CloudEngineHub/RP1_hardware/01_Mechanic/02_Manufacturing/01_CNC/Common/YCL.M000292 膝盖轴承座.STEP

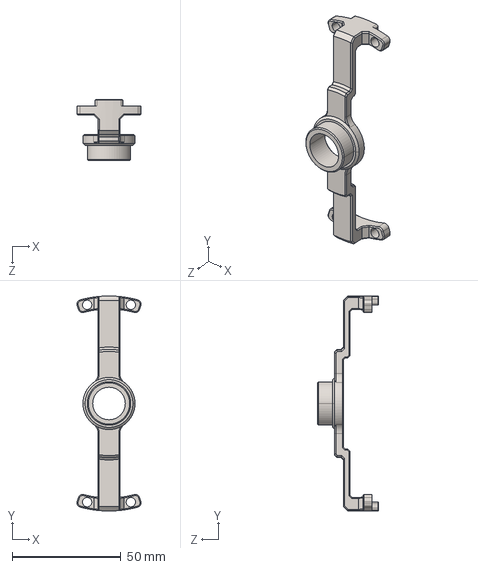
[picture p68: CAD file, 2026-09-30]
01_Mechanic/02_Manufacturing/01_CNC/Common/YCL.M000292 膝盖轴承座.STEP
29.5 x 99.0 x 28.2 mm
