CloudEngineHub/RP1_hardware/01_Mechanic/02_Manufacturing/01_CNC/Common/YCL.M000645 大臂下后分件(01版).STEP

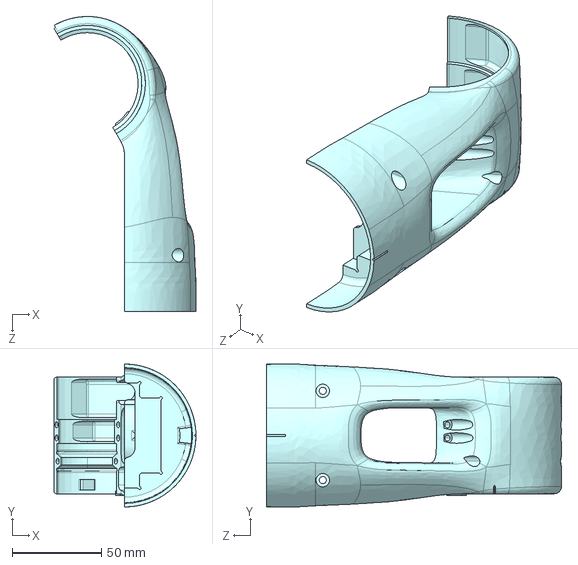
[picture p69: CAD file, 2026-09-30]
01_Mechanic/02_Manufacturing/01_CNC/Common/YCL.M000645 大臂下后分件(01版).STEP
79.4 x 80.0 x 165.1 mm
