CloudEngineHub/RP1_hardware/01_Mechanic/02_Manufacturing/01_CNC/Common/YCL.M000448 小腿本体左.STEP

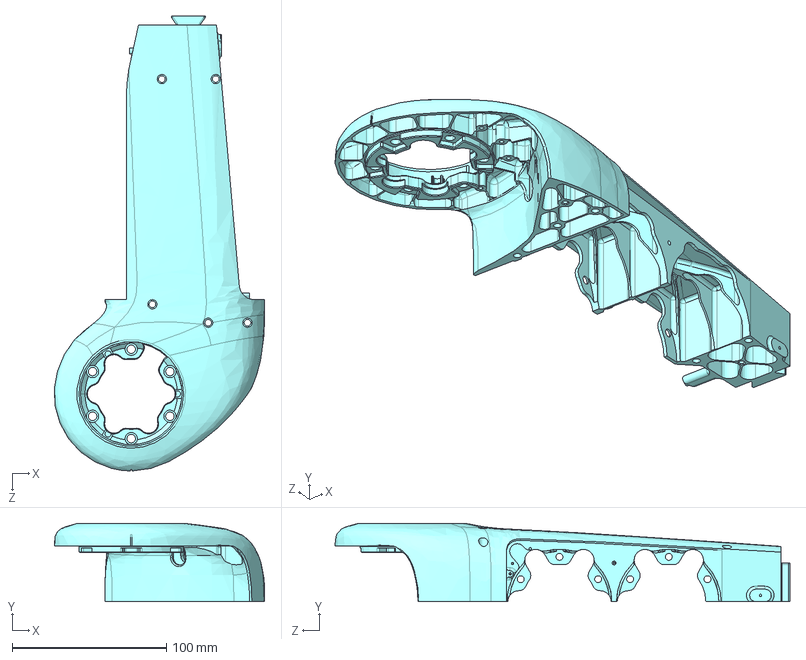
[picture p70: CAD file, 2026-09-30]
01_Mechanic/02_Manufacturing/01_CNC/Common/YCL.M000448 小腿本体左.STEP
136.6 x 50.7 x 295.4 mm
