CloudEngineHub/RP1_hardware/01_Mechanic/02_Manufacturing/01_CNC/Common/YCL.M000642 大臂上本体（01版）.STEP

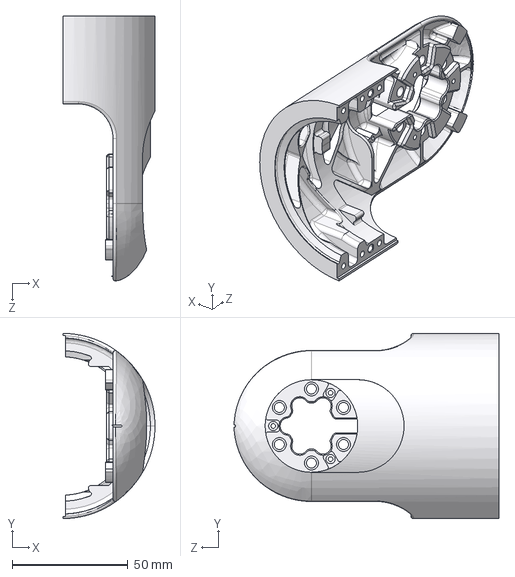
[picture p71: CAD file, 2026-09-30]
01_Mechanic/02_Manufacturing/01_CNC/Common/YCL.M000642 大臂上本体（01版）.STEP
39.8 x 80.0 x 114.4 mm
