CloudEngineHub/RP1_hardware/01_Mechanic/02_Manufacturing/01_CNC/Common/YCL.M000454 镜向小腿电机分离块.STEP

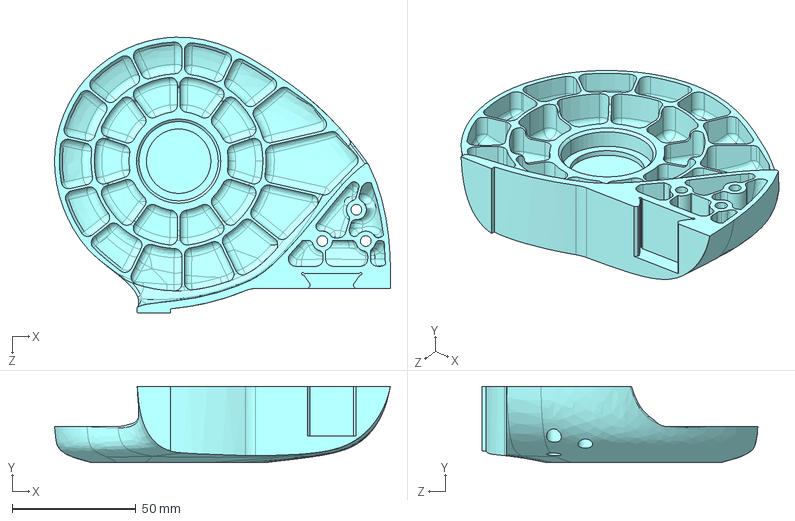
[picture p72: CAD file, 2026-09-30]
01_Mechanic/02_Manufacturing/01_CNC/Common/YCL.M000454 镜向小腿电机分离块.STEP
135.5 x 30.7 x 111.2 mm
