CloudEngineHub/RP1_hardware/01_Mechanic/02_Manufacturing/01_CNC/Common/YCL.M000664 Yaw限位4（03版）.STEP

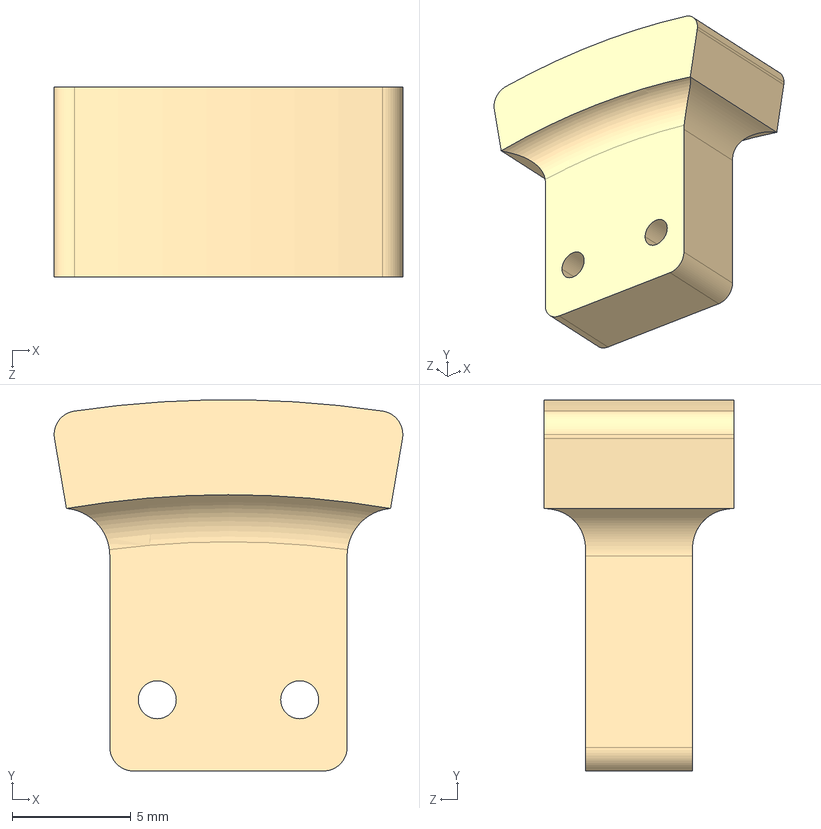
[picture p73: CAD file, 2026-09-30]
01_Mechanic/02_Manufacturing/01_CNC/Common/YCL.M000664 Yaw限位4（03版）.STEP
14.7 x 15.6 x 8.00 mm
