CloudEngineHub/RP1_hardware/01_Mechanic/02_Manufacturing/01_CNC/Common/YCL.M000702 腰部支架.STEP

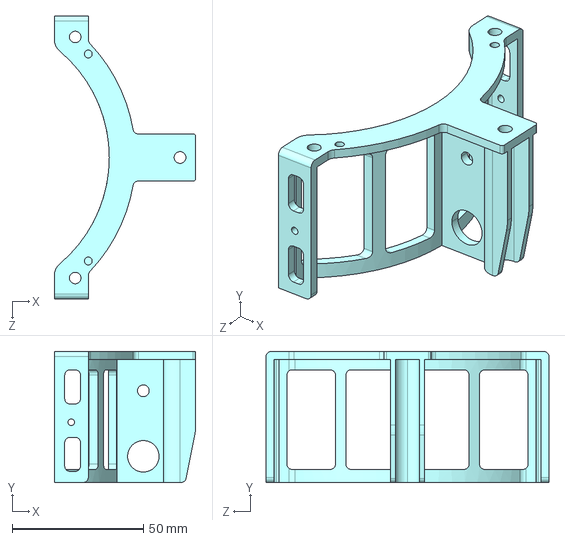
[picture p74: CAD file, 2026-09-30]
01_Mechanic/02_Manufacturing/01_CNC/Common/YCL.M000702 腰部支架.STEP
54.0 x 50.0 x 108.0 mm
