CloudEngineHub/RP1_hardware/01_Mechanic/02_Manufacturing/01_CNC/Common/YCL.M000334 限位环.STEP

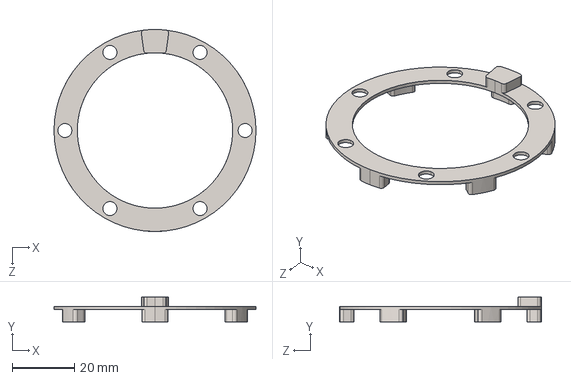
[picture p75: CAD file, 2026-09-30]
01_Mechanic/02_Manufacturing/01_CNC/Common/YCL.M000334 限位环.STEP
65.0 x 8.00 x 65.0 mm
