CloudEngineHub/RP1_hardware/01_Mechanic/02_Manufacturing/01_CNC/Common/YCL.M000708 把手-kickme.STEP

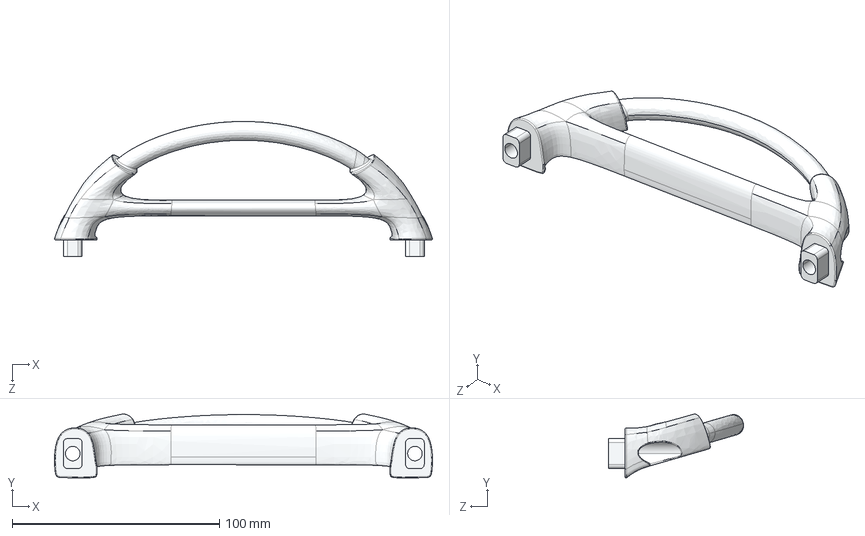
[picture p76: CAD file, 2026-09-30]
01_Mechanic/02_Manufacturing/01_CNC/Common/YCL.M000708 把手-kickme.STEP
182.3 x 30.8 x 65.2 mm
