CloudEngineHub/RP1_hardware/01_Mechanic/02_Manufacturing/01_CNC/Common/YCL.M000982 屏幕减震泡棉.STEP

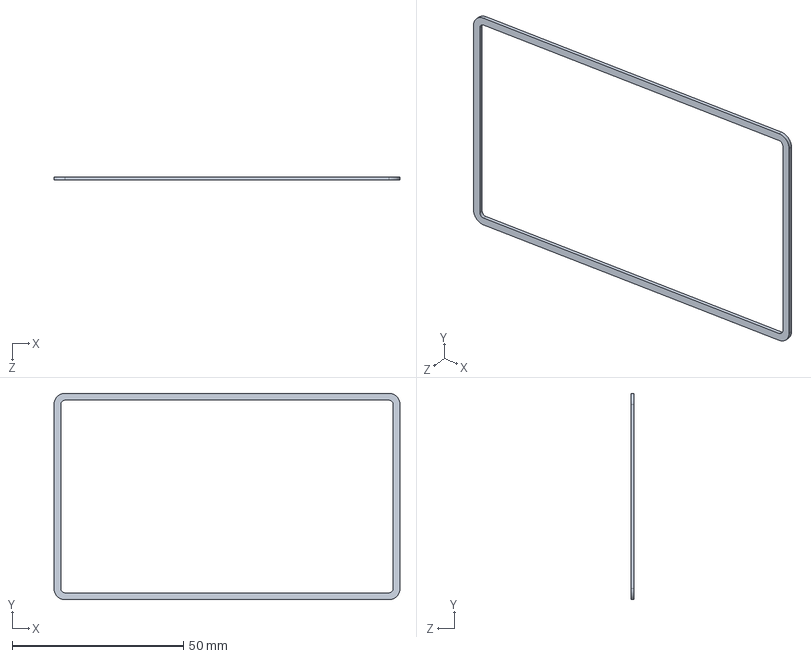
[picture p77: CAD file, 2026-09-30]
01_Mechanic/02_Manufacturing/01_CNC/Common/YCL.M000982 屏幕减震泡棉.STEP
101.0 x 60.2 x 1 mm
