CloudEngineHub/RP1_hardware/01_Mechanic/02_Manufacturing/01_CNC/Common/YCL.M000610 集电板主体支架.STEP

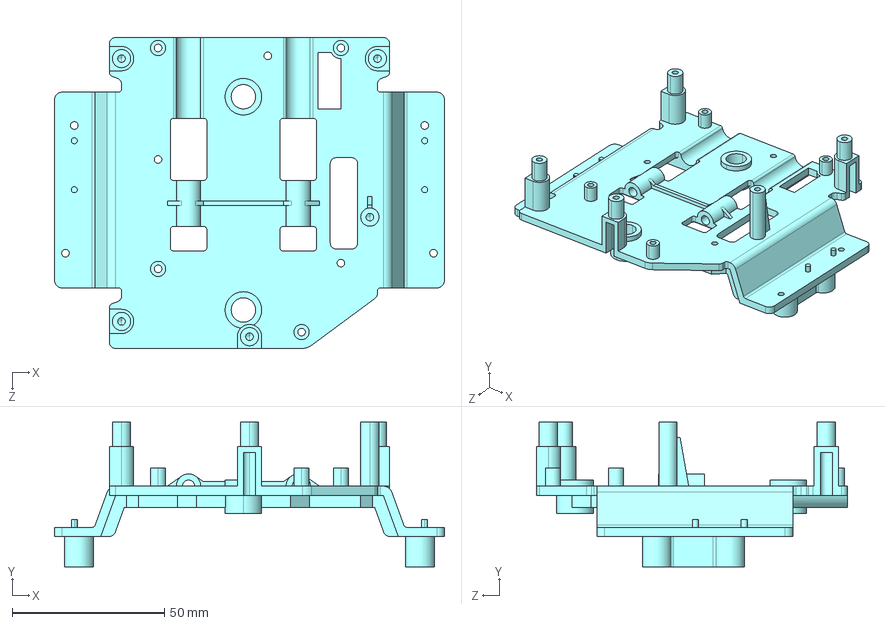
[picture p78: CAD file, 2026-09-30]
01_Mechanic/02_Manufacturing/01_CNC/Common/YCL.M000610 集电板主体支架.STEP
128.0 x 47.5 x 102.0 mm
