CloudEngineHub/RP1_hardware/01_Mechanic/02_Manufacturing/01_CNC/Common/YCL.M000227_腰部一号（LS版）.STEP

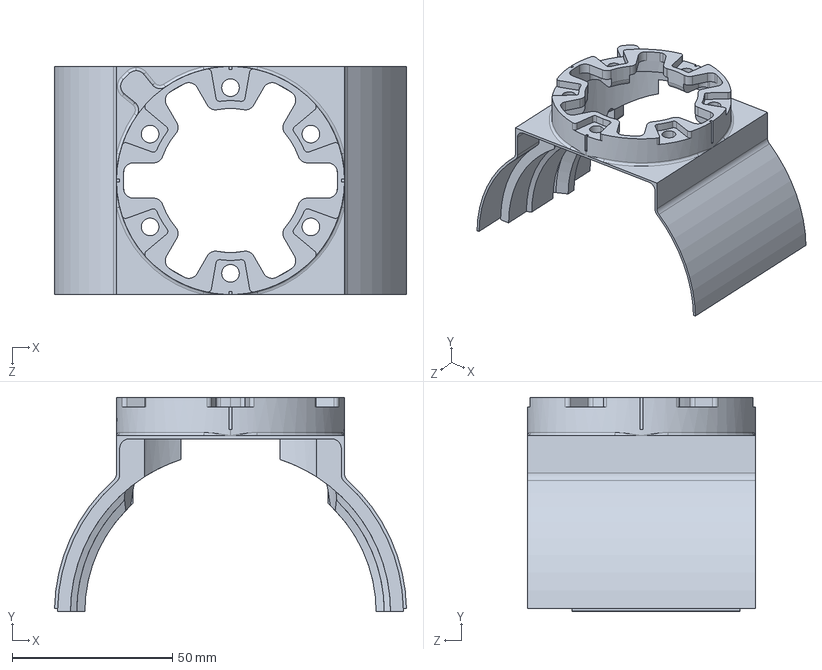
[picture p80: CAD file, 2026-09-30]
01_Mechanic/02_Manufacturing/01_CNC/Common/YCL.M000227_腰部一号（LS版）.STEP
110.0 x 67.0 x 71.2 mm
