CloudEngineHub/RP1_hardware/01_Mechanic/02_Manufacturing/01_CNC/Common/YCL.M000249 Yaw限位3.STEP

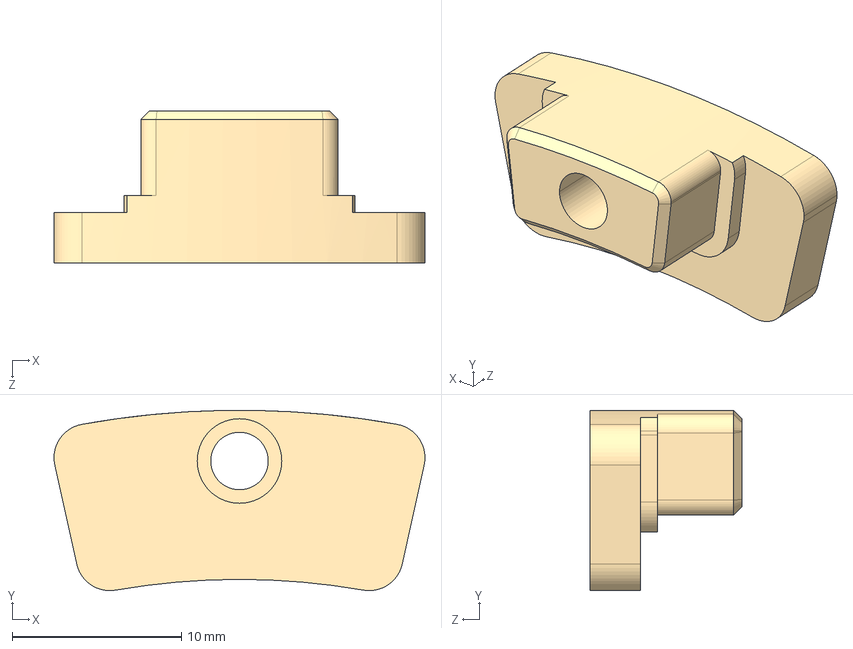
[picture p81: CAD file, 2026-09-30]
01_Mechanic/02_Manufacturing/01_CNC/Common/YCL.M000249 Yaw限位3.STEP
21.9 x 10.7 x 9.00 mm
