CloudEngineHub/RP1_hardware/(list of files, cad)

Other CAD files:
02_PCB/06_RBE-PWR-HEAD/03_3D_HEAD_2026-09-28.step
01_Mechanic/02_Manufacturing/01_CNC/5DOF/YCL.M000376 镜向造型手盖子.STEP
01_Mechanic/02_Manufacturing/01_CNC/7DOF/YCL.M000331 雷赛灵巧手转接件.STEP
01_Mechanic/02_Manufacturing/01_CNC/Common/YCL.M000481 大腿下本体右.STEP
01_Mechanic/02_Manufacturing/02_3D_Printing/STEP_3D模型/YCL.M000398 75肩部盖子.STEP
01_Mechanic/02_Manufacturing/01_CNC/Common/YCL.M000670 镜向大腿下本体左(02版).STEP
01_Mechanic/02_Manufacturing/01_CNC/Common/YCL.M000271 Pitch限位.STEP
01_Mechanic/02_Manufacturing/01_CNC/Common/YCL.M000485 大腿下盖板左.STEP
01_Mechanic/02_Manufacturing/01_CNC/Common/YCL.M000648 镜向小臂上本体左（02版）.STEP
