CloudEngineHub/RP1_hardware/01_Mechanic/02_Manufacturing/02_3D_Printing/CMF说明/RP1_3D_Print_CMF_Specification.xlsx

序号 | 零件代号 | 零件名称 | 颜色 | 材质 | 工艺 | 三维视图缩略图
1 | YCL.M000298 | 大臂上盖子 | 灰 | ABS | 打磨、喷涂
2 | YCL.M000308 | 小臂上盖子 | 灰 | ABS | 打磨、喷涂
3 | YCL.M000311 | 小臂下盖子 | 灰 | ABS | 打磨、喷涂
4 | YCL.M000313 | 镜向小臂上盖子 | 灰 | ABS | 打磨、喷涂
5 | YCL.M000323 | 手腕端头盖板 | 灰 | ABS | 打磨、喷涂
6 | YCL.M000398 | 75肩部盖子 | 蓝 | ABS | 打磨、喷涂
7 | YCL.M000402 | 镜向75肩部盖子 | 蓝 | ABS | 打磨、喷涂
8 | YCL.M000435 | 大腿盖子 | 灰 | ABS | 打磨、喷涂
9 | YCL.M000443 | 小腿盖板 | 灰 | ABS | 打磨、喷涂
10 | YCL.M000744 | logo灯盖 | 白 | ABS | 打磨、喷涂
11 | YCL.M000787 | 运控头螺丝遮挡盖 | 白 | ABS | 打磨、喷涂
12 | YCL.M000790 | KICKME版本头部面部 | 白 | UFS9002 树脂 | 打磨、喷涂
13 | YCL.M000819 | 交互头-外壳前盖 | 白 | ABS | 打磨、喷涂
14 | YCL.M000821 | 交互头-屏幕顶盖 | 黑 | ABS | 打磨、喷涂
15 | YCL.M000822 | 交互头-上外壳支架 | 白 | ABS | 打磨、喷涂
16 | YCL.M000823 | 交互头-下外壳支架 | 白 | ABS | 打磨、喷涂
17 | YCL.M000825 | 交互头-上装饰盖 | 白 | ABS | 打磨、喷涂
18 | YCL.M000826 | 交互头-后装饰盖 | 白 | ABS | 打磨、喷涂
19 | YCL.M000827 | 交互头-侧装饰盖-L | 白 | ABS | 打磨、喷涂
20 | YCL.M000828 | 交互头-侧装饰盖-R | 白 | ABS | 打磨、喷涂
