CloudEngineHub/RP1_hardware/01_Mechanic/02_Manufacturing/03_Rubber/PDF文件/YCL.M000743-02 调试口软胶盖.pdf

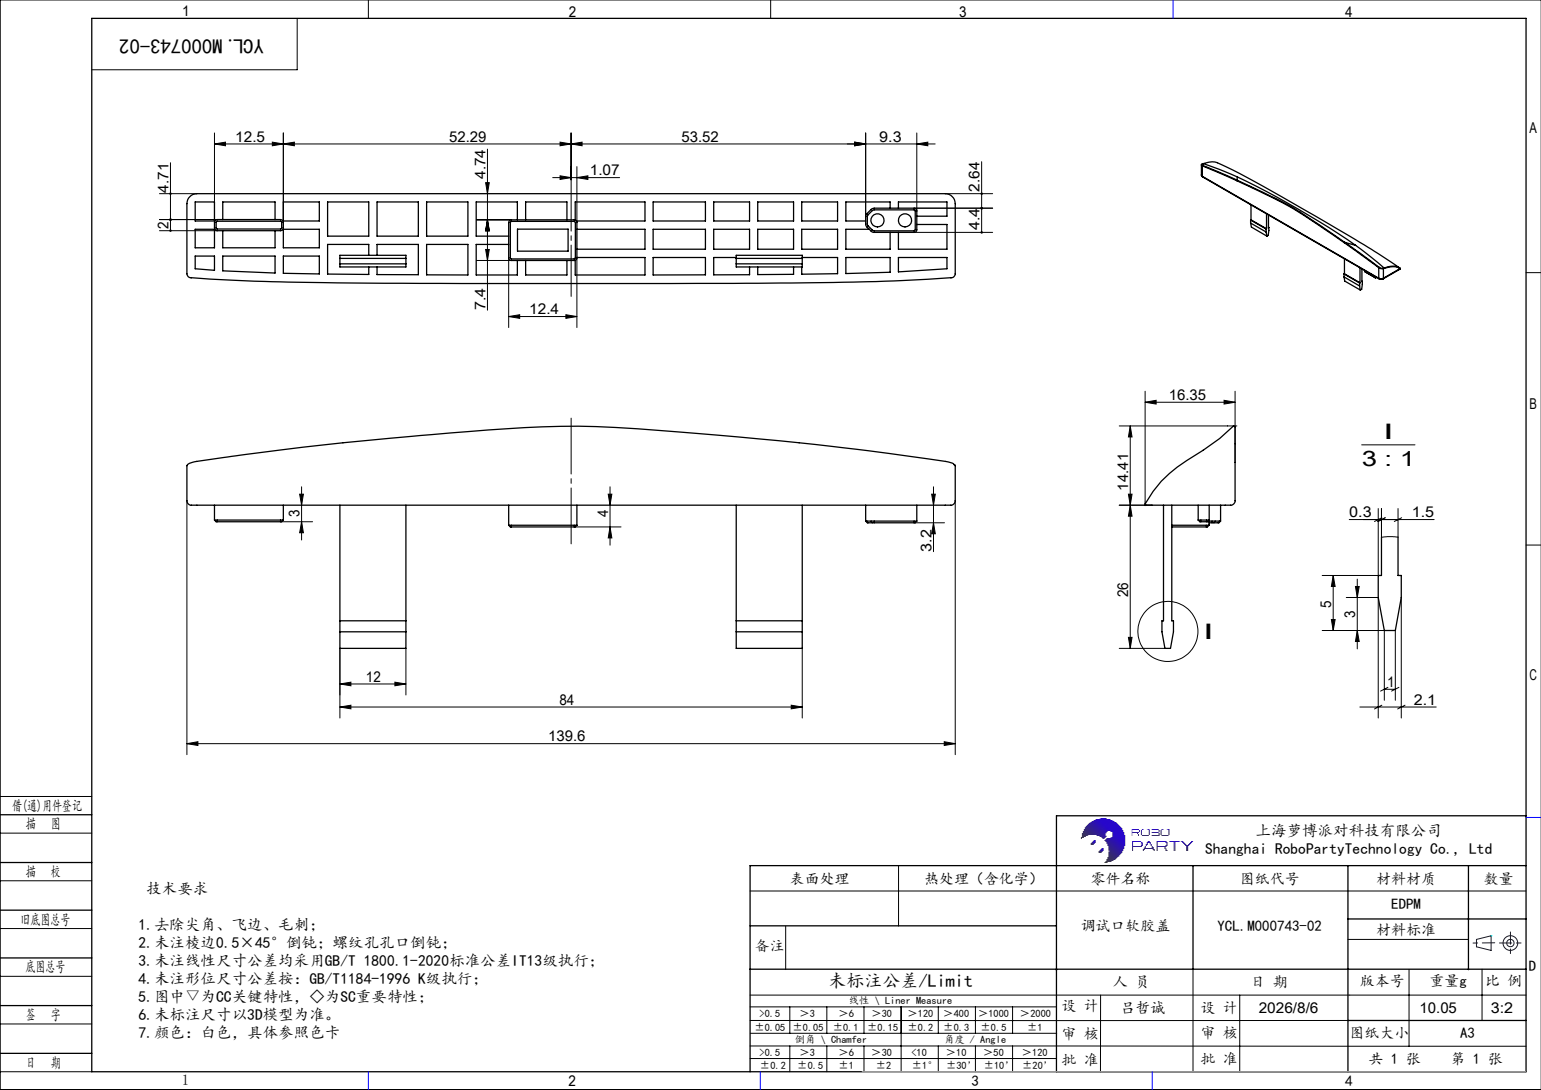
[picture p82: page 1]

Shanghai RoboPartyTechnology Co., Ltd

表面处理 | 热处理（含化学） | 零件名称 | 图纸代号 | 材料材质 | 数量

调试口软胶盖 | YCL.M000743-02 | EDPM

1.去除尖角、飞边、毛刺；
2.未注棱边0.5×45°倒钝；螺纹孔孔口倒钝；
3.未注线性尺寸公差均采用GB/T 1800.1-2020标准公差IT13级执行；
4.未注形位尺寸公差按：GB/T1184-1996 K级执行；
5.图中▽为CC关键特性，◇为SC重要特性；
6.未标注尺寸以3D模型为准。
7.颜色：白色，具体参照色卡

材料标准

未标注公差/Limit | 人 员 | 日 期 | 版本号 | 重量g | 比 例
线性 \ Liner Measure | 设 计 | 吕哲诚 | 设 计 | 2026/8/6 | | 10.05 | 3:2

±0.05 | ±0.05 | ±0.1 | ±0.15 | ±0.2 | ±0.3 | ±0.5 | ±1 | 审 核 | 审 核 | 图纸大小 | A3
>0.5 | ＞3 | ＞6 | ＞30 | <10 | ＞10 | ＞50 | ＞120 | 批 准 | 批 准 | 共 1 张 第 1 张
±0.2 | ±0.5 | ±1 | ±2 | ±1° | ±30’ | ±10’ ±20’

倒角 \ Chamfer | | | | 角度 / Angle
