CloudEngineHub/RP1_hardware/01_Mechanic/02_Manufacturing/02_3D_Printing/PDF文件/YCL.M000398 75肩部盖子.pdf

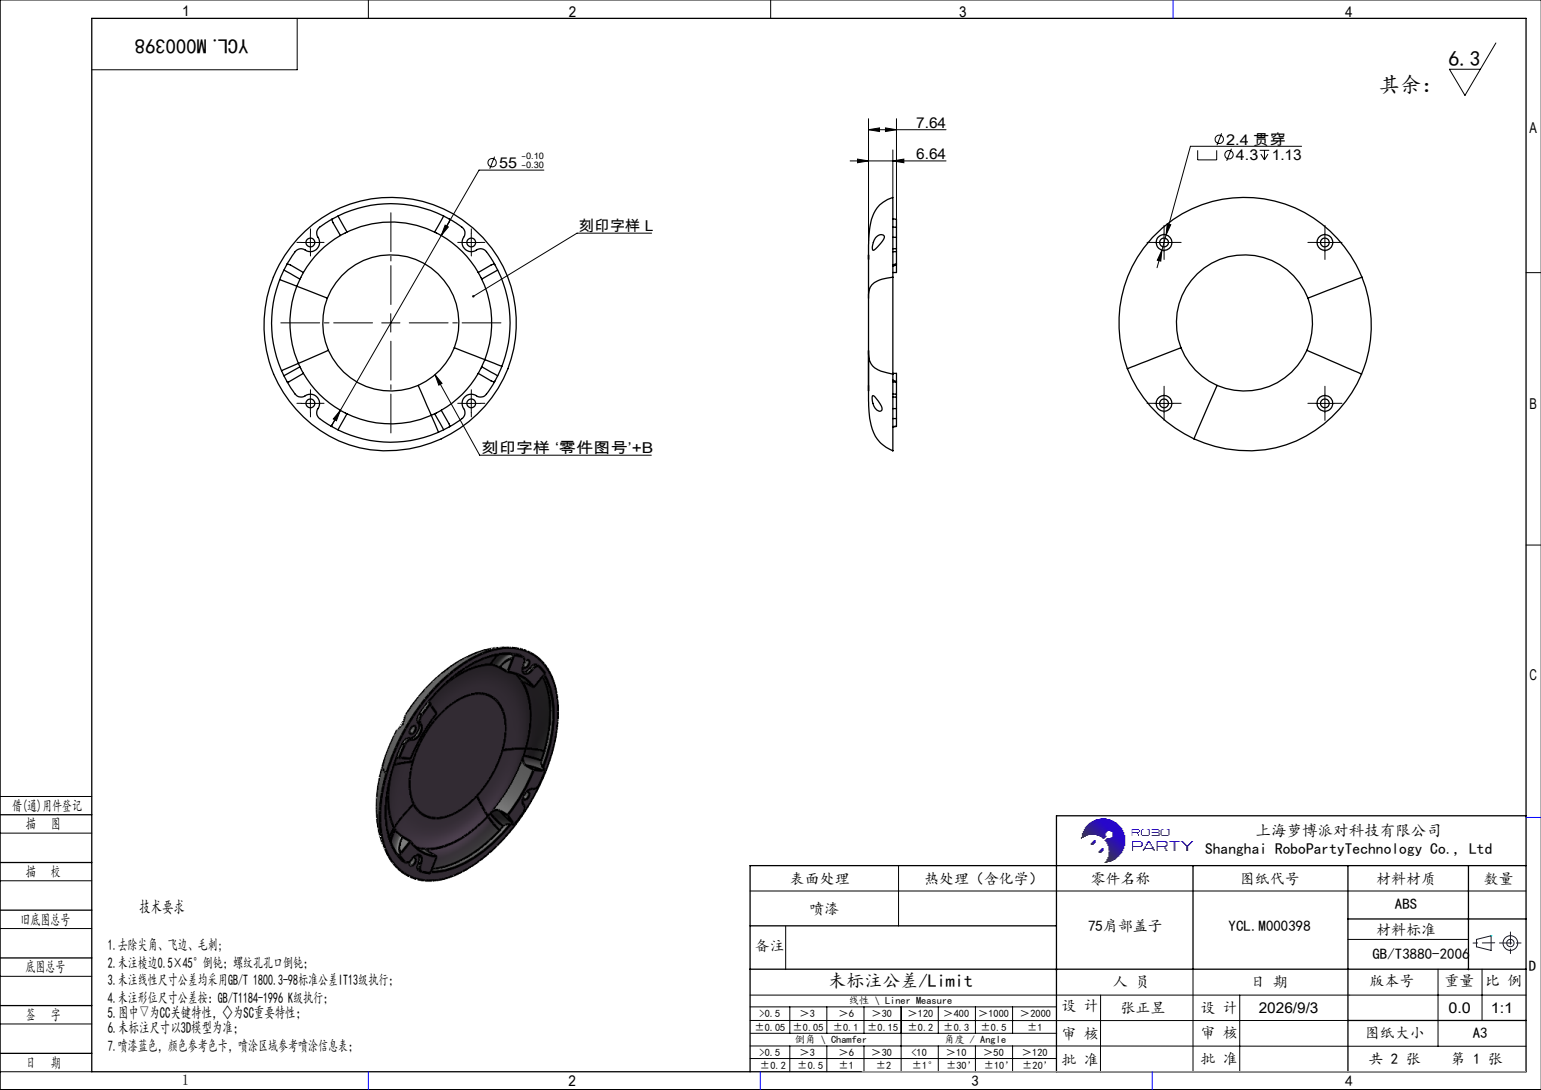
[picture p84: page 1]
刻印字样 ‘零件图号’+B; 刻印字样 L

Shanghai RoboPartyTechnology Co., Ltd

表面处理 | 热处理（含化学） | 零件名称 | 图纸代号 | 材料材质 | 数量
喷漆 | | 75肩部盖子 | YCL.M000398 | ABS

材料标准

1.去除尖角、飞边、毛刺;
2.未注棱边0.5×45°倒钝；螺纹孔孔口倒钝；
3.未注线性尺寸公差均采用GB/T 1800.3-98标准公差IT13级执行；
4.未注形位尺寸公差按：GB/T1184-1996 K级执行；
5.图中▽为CC关键特性，◇为SC重要特性；
6.未标注尺寸以3D模型为准；
7.喷漆蓝色，颜色参考色卡，喷涂区域参考喷涂信息表；

未标注公差/Limit | 人 员 | 日 期 | 版本号 | 重量 | 比 例
线性 \ Liner Measure | 设 计 | 张正昱 | 设 计 | 2026/9/3 | | 0.0 | 1:1

±0.05 | ±0.05 | ±0.1 | ±0.15 | ±0.2 | ±0.3 | ±0.5 | ±1 | 审 核 | 审 核 | 图纸大小 | A3
>0.5 | ＞3 | ＞6 | ＞30 | <10 | ＞10 | ＞50 | ＞120 | 批 准 | 批 准 | 共 2 张 第 1 张
±0.2 | ±0.5 | ±1 | ±2 | ±1° | ±30’ | ±10’ ±20’

倒角 \ Chamfer | | | | 角度 / Angle
