CloudEngineHub/RP1_hardware/01_Mechanic/02_Manufacturing/02_3D_Printing/PDF文件/YCL.M000402 镜向75肩部盖子.pdf

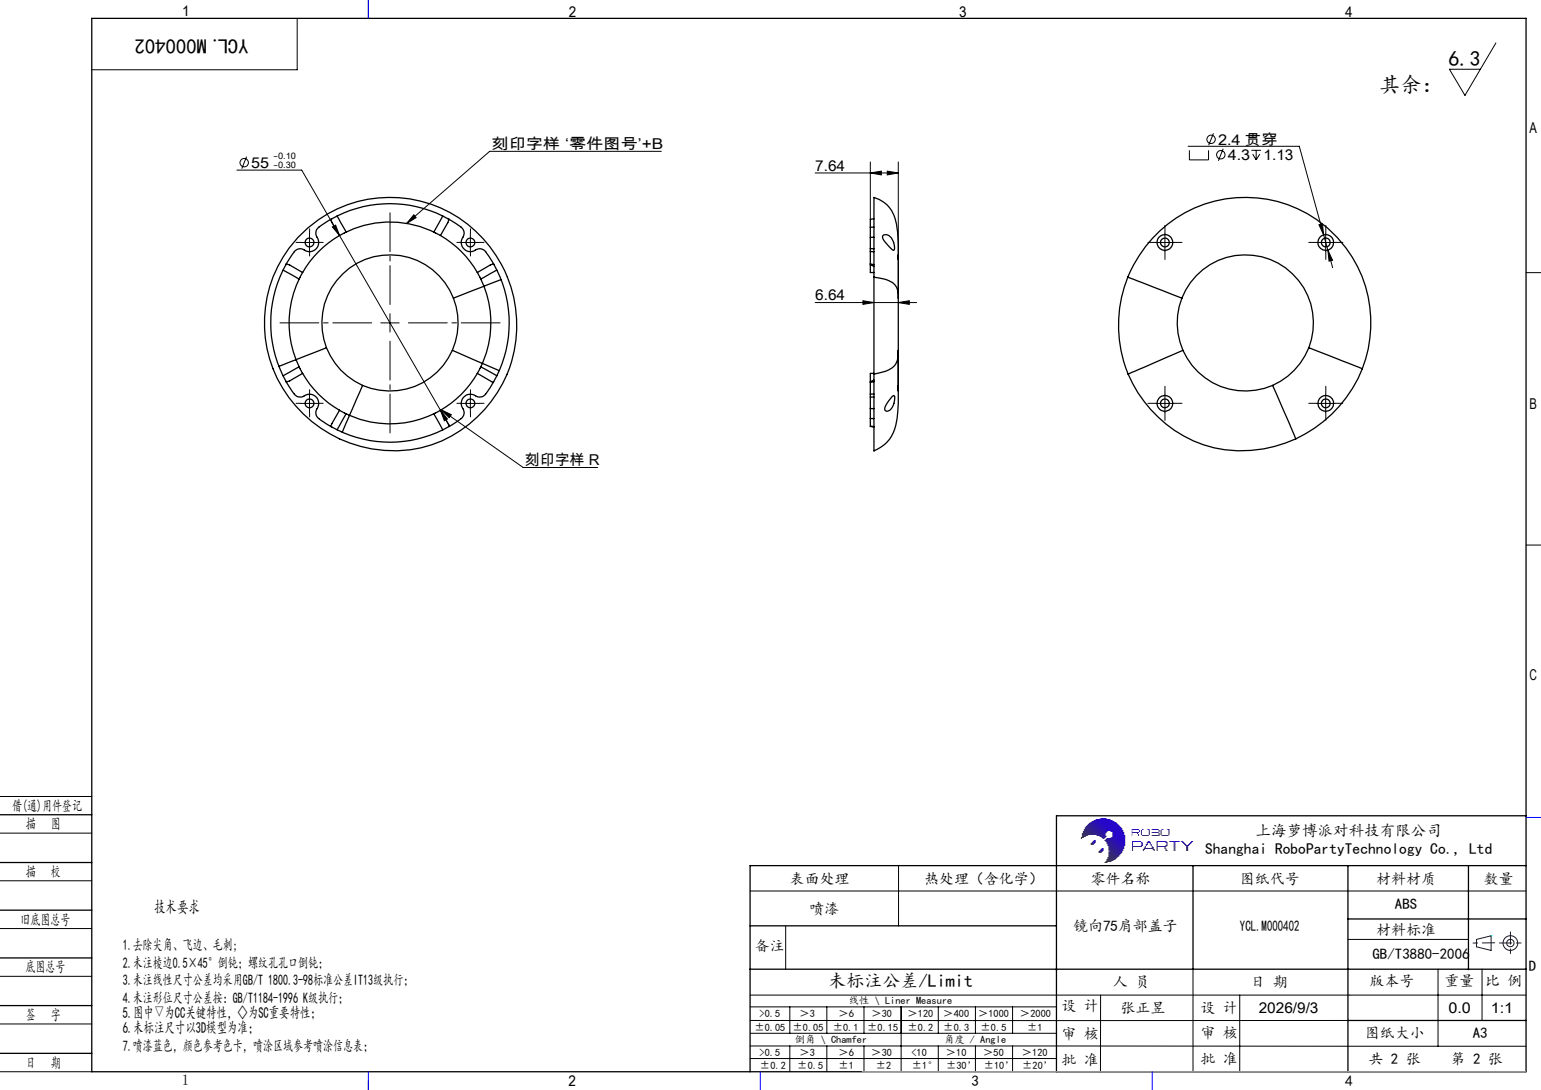
[picture p85: page 1]
刻印字样 ‘零件图号’+B; 刻印字样 R

Shanghai RoboPartyTechnology Co., Ltd

表面处理 | 热处理（含化学） | 零件名称 | 图纸代号 | 材料材质 | 数量
喷漆 | | 镜向75肩部盖子 | YCL.M000402 | ABS

材料标准

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

>0.5 | ＞3 | ＞6 | ＞30 | ＞120 | ＞400 | ＞1000 | ＞2000
±0.05 | ±0.05 | ±0.1 | ±0.15 | ±0.2 | ±0.3 | ±0.5 | ±1 | 审 核 | 审 核 | 图纸大小 | A3

倒角 \ Chamfer | | | | 角度 / Angle
