CloudEngineHub/RP1_hardware/01_Mechanic/02_Manufacturing/02_3D_Printing/PDF文件/YCL.M000710 kickme_版本电池导向支架.pdf

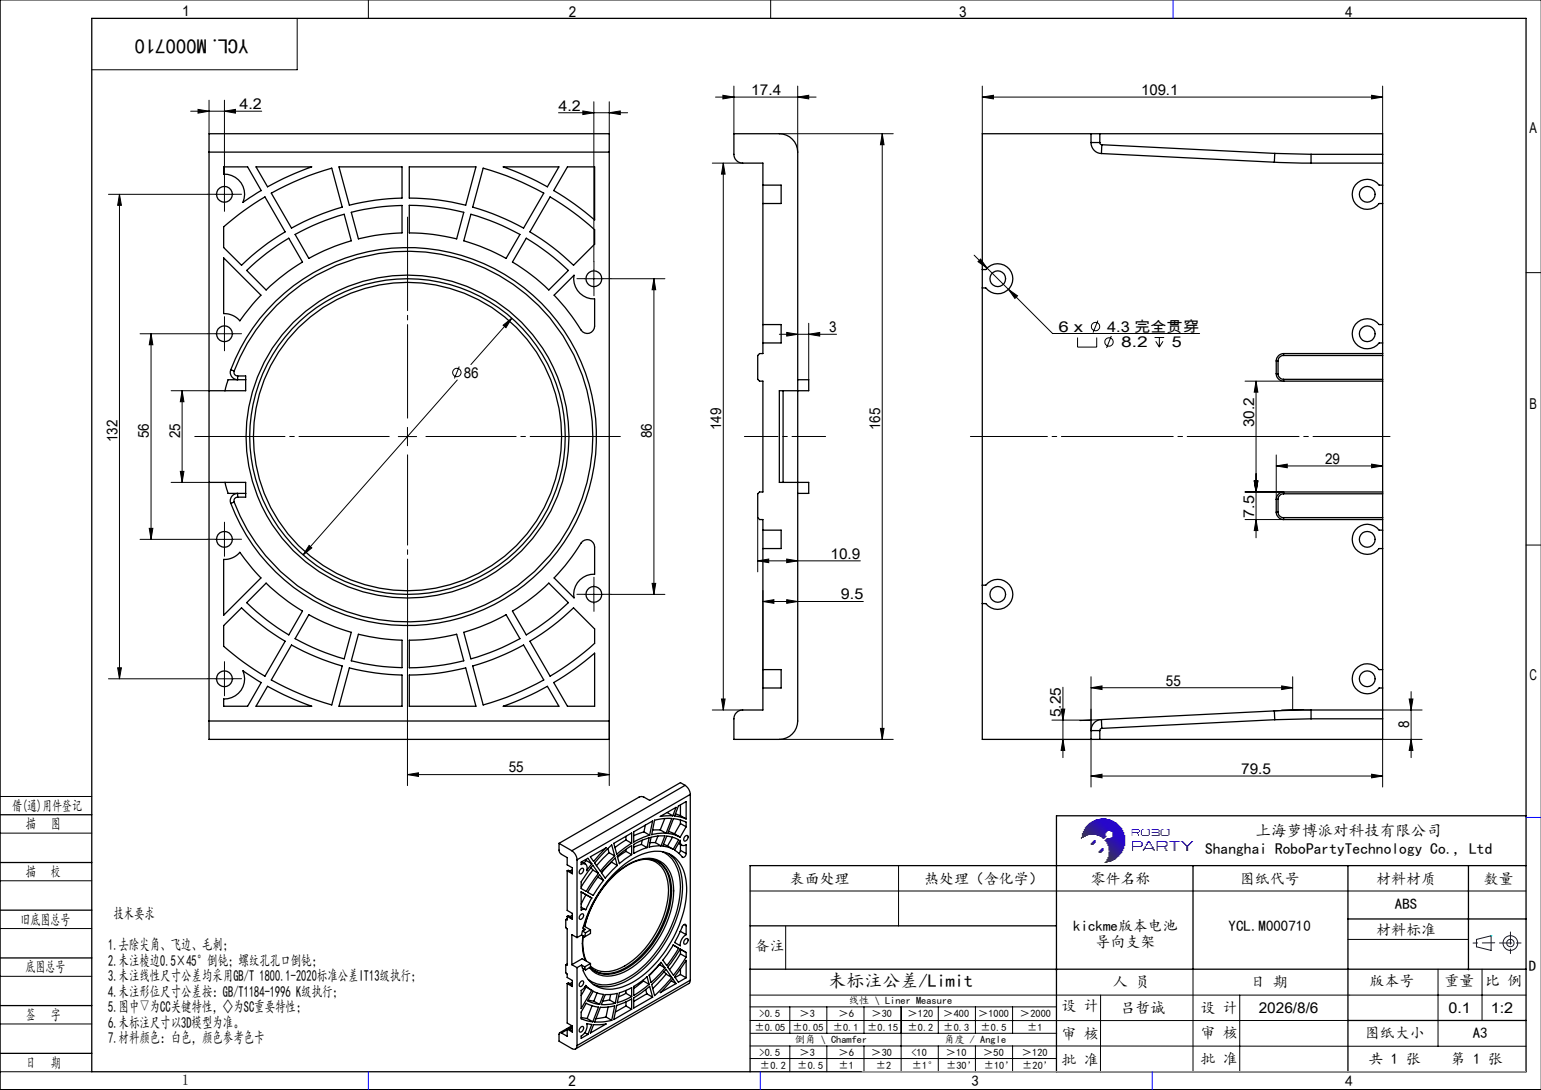
[picture p86: page 1]
6 x 4.3 完全贯穿 8.2 5

Shanghai RoboPartyTechnology Co., Ltd

表面处理 | 热处理（含化学） | 零件名称 | 图纸代号 | 材料材质 | 数量

kickme版本电池 导向支架 | YCL.M000710 | ABS

材料标准

1.去除尖角、飞边、毛刺；
2.未注棱边0.5×45°倒钝；螺纹孔孔口倒钝；
3.未注线性尺寸公差均采用GB/T 1800.1-2020标准公差IT13级执行；
4.未注形位尺寸公差按：GB/T1184-1996 K级执行；
5.图中▽为CC关键特性，◇为SC重要特性；
6.未标注尺寸以3D模型为准。
7.材料颜色：白色，颜色参考色卡

未标注公差/Limit | 人 员 | 日 期 | 版本号 | 重量 | 比 例
线性 \ Liner Measure | 设 计 | 吕哲诚 | 设 计 | 2026/8/6 | | 0.1 | 1:2

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

倒角 \ Chamfer | | | | 角度 / Angle
