CloudEngineHub/RP1_hardware/01_Mechanic/02_Manufacturing/01_CNC/CMF说明/YCL.M000227_腰部一号（LS版）_CMF说明.pdf

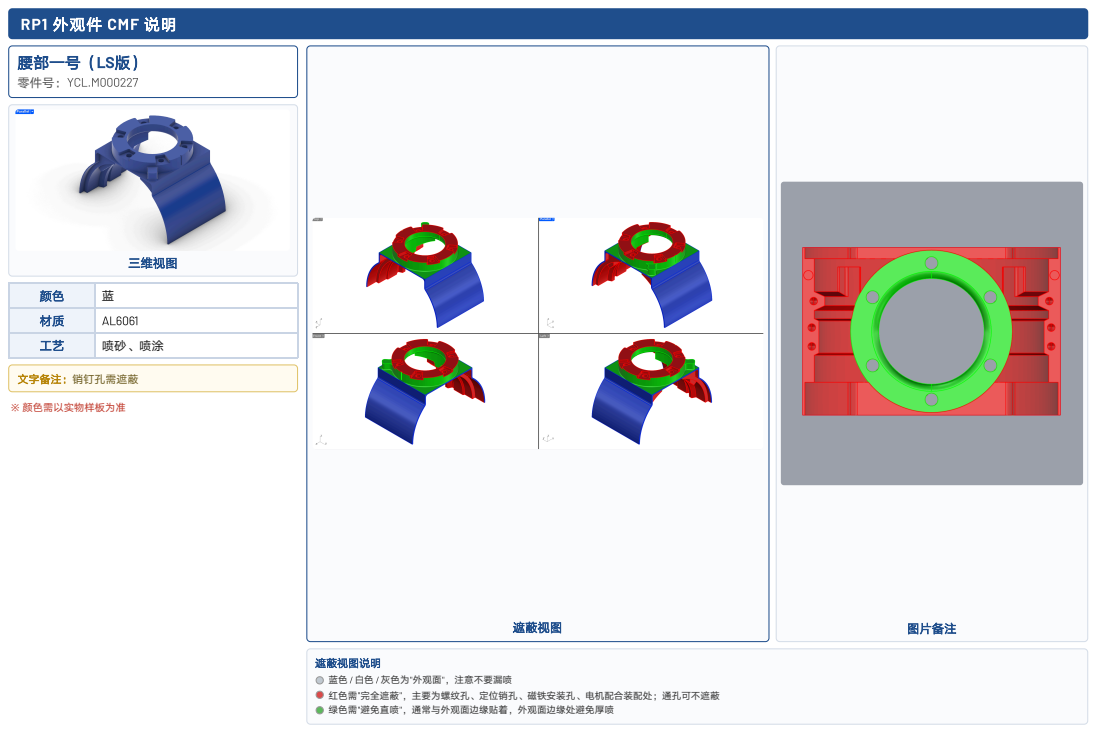
[picture p87: page 1]
腰部一号（LS版）; 零件号：YCL.M000227; 三维视图; 文字备注：销钉孔需遮蔽; ※ 颜色需以实物样板为准; 遮蔽视图; 图片备注

RP1 外观件 CMF 说明

材质 | AL6061
工艺 | 喷砂、喷涂

遮蔽视图说明
蓝色 / 白色 / 灰色为"外观面"，注意不要漏喷
红色需"完全遮蔽"，主要为螺纹孔、定位销孔、磁铁安装孔、电机配合装配处；通孔可不遮蔽
绿色需"避免直喷"，通常与外观面边缘贴着，外观面边缘处避免厚喷
