CloudEngineHub/RP1_hardware/01_Mechanic/02_Manufacturing/01_CNC/CMF说明/YCL.M000373_造型手盖子_CMF说明.pdf

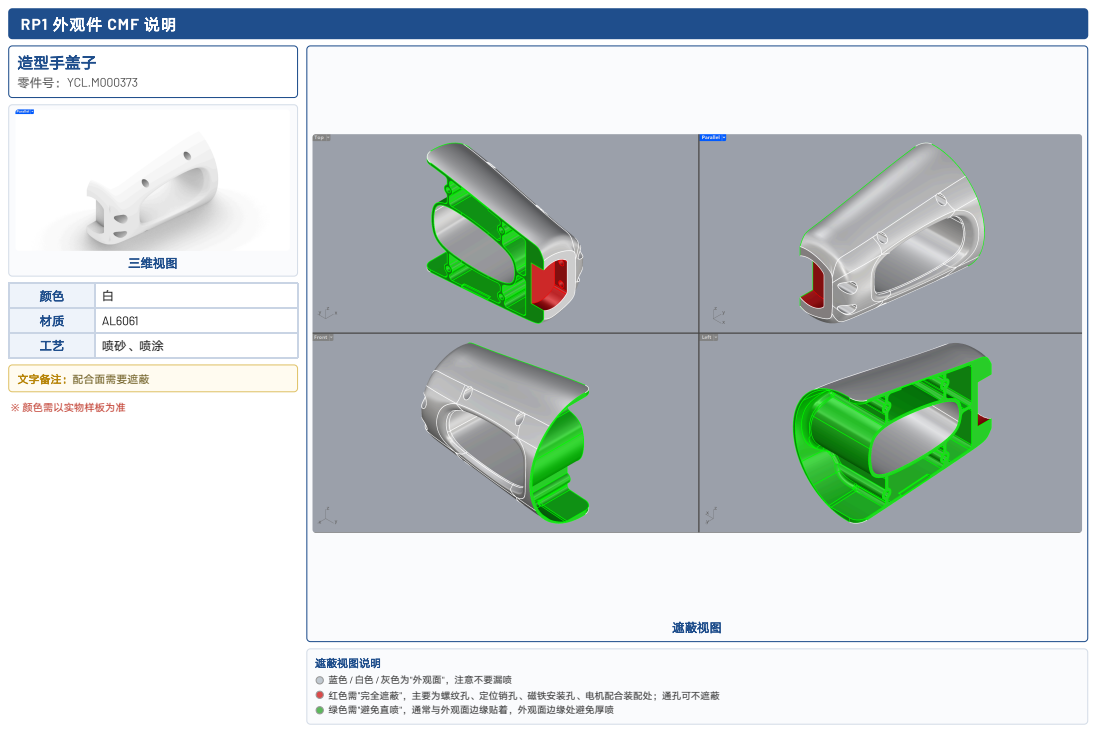
[picture p88: page 1]
造型手盖子; 零件号：YCL.M000373; 三维视图; 文字备注：配合面需要遮蔽; ※ 颜色需以实物样板为准; 遮蔽视图

RP1 外观件 CMF 说明

材质 | AL6061
工艺 | 喷砂、喷涂

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
