CloudEngineHub/RP1_hardware/01_Mechanic/02_Manufacturing/01_CNC/CMF说明/YCL.M000716_kickme版本躯干后壳_CMF说明.pdf

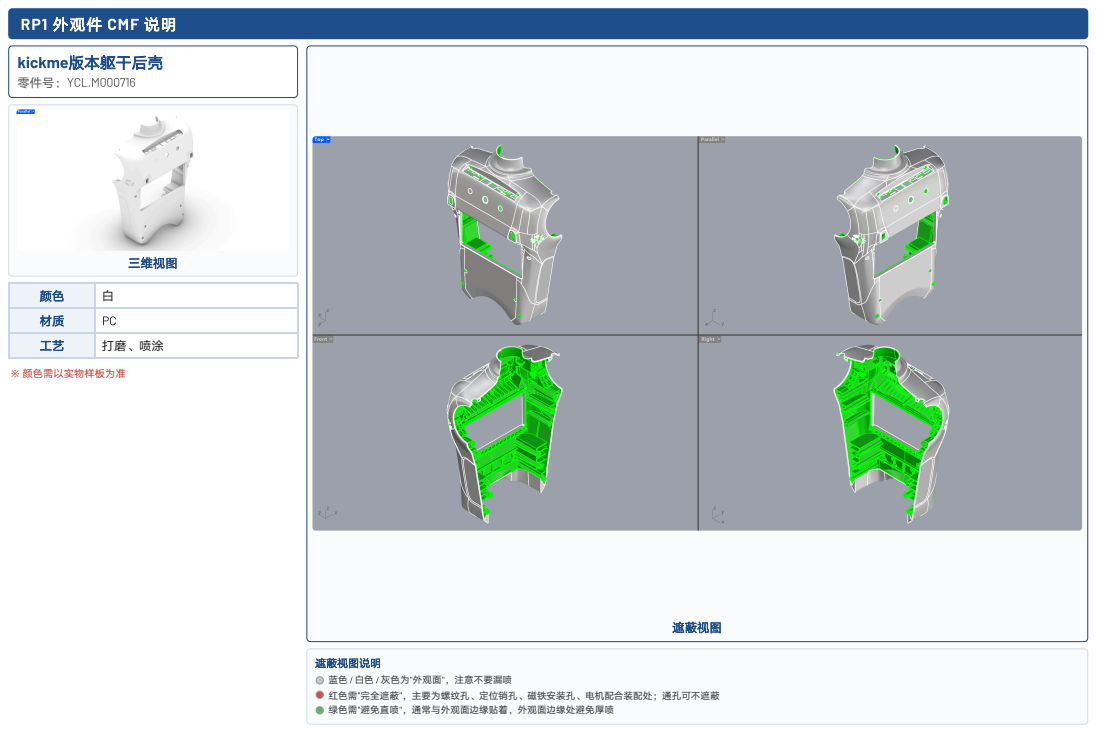
[picture p89: page 1]
kickme版本躯干后壳; 零件号：YCL.M000716; 三维视图; ※ 颜色需以实物样板为准; 遮蔽视图

RP1 外观件 CMF 说明

材质 | PC
工艺 | 打磨、喷涂

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
