CloudEngineHub/RP1_hardware/01_Mechanic/02_Manufacturing/01_CNC/CMF说明/YCL.M000740_头部灯带嵌板_CMF说明.pdf

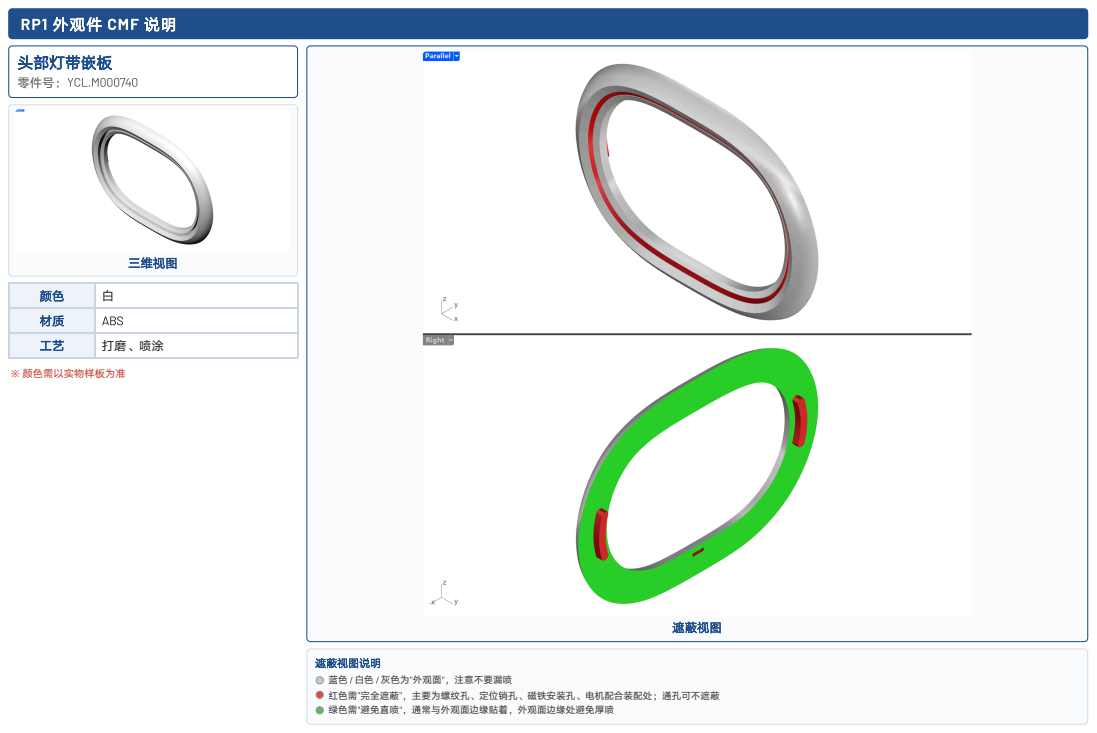
[picture p90: page 1]
头部灯带嵌板; 零件号：YCL.M000740; 三维视图; ※ 颜色需以实物样板为准; 遮蔽视图

RP1 外观件 CMF 说明

材质 | ABS
工艺 | 打磨、喷涂

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
