CloudEngineHub/RP1_hardware/01_Mechanic/02_Manufacturing/01_CNC/5DOF/YCL.M000374 镜向造型手本体.pdf

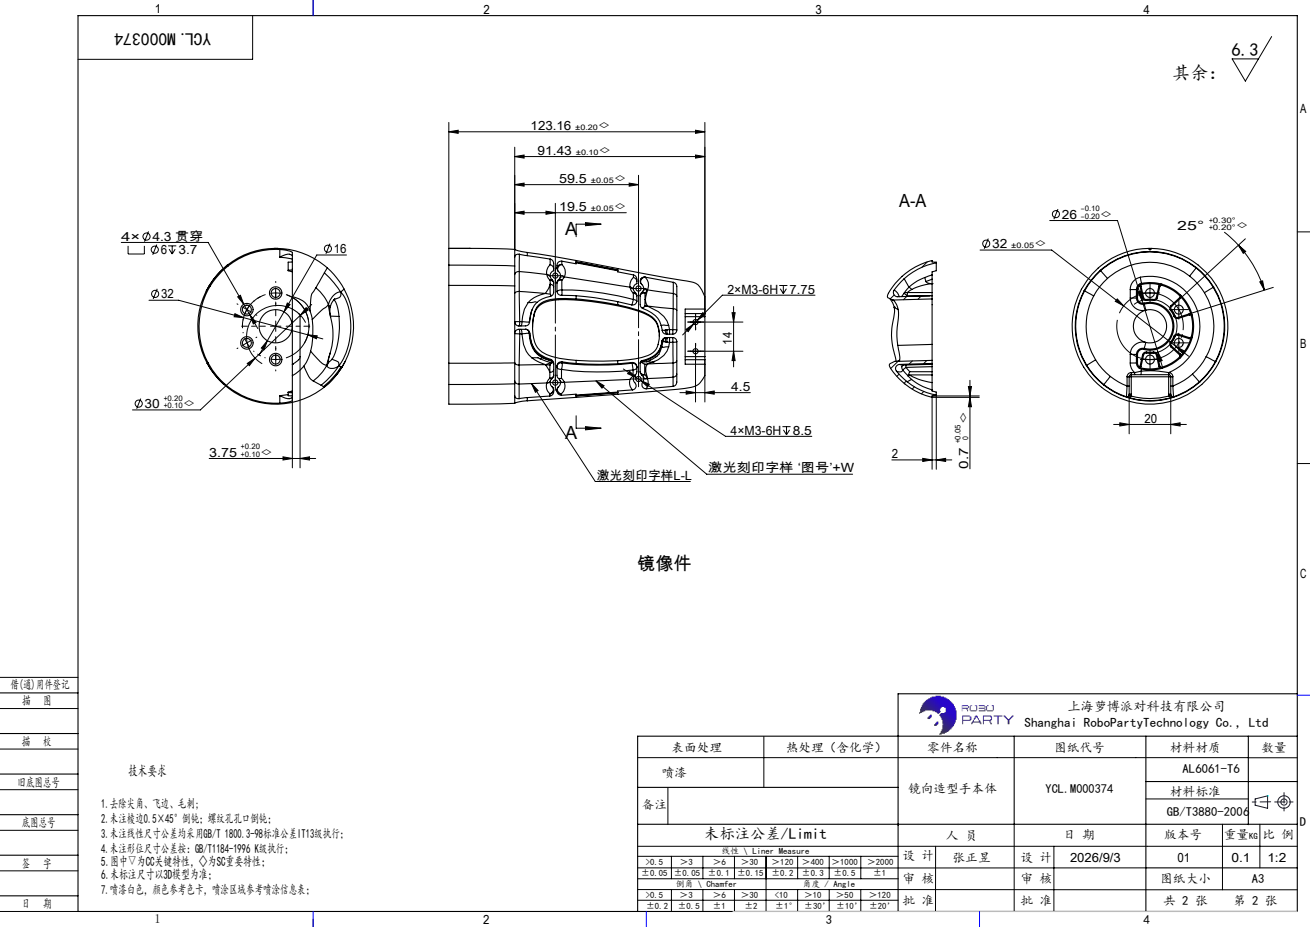
[picture p91: page 1]

激光刻印字样L-L 激光刻印字样 ‘图号’+W

Shanghai RoboPartyTechnology Co., Ltd

表面处理 | 热处理（含化学） | 零件名称 | 图纸代号 | 材料材质 | 数量
喷漆 | | 镜向造型手本体 | YCL.M000374 | AL6061-T6

材料标准

1.去除尖角、飞边、毛刺;
2.未注棱边0.5×45°倒钝；螺纹孔孔口倒钝；
3.未注线性尺寸公差均采用GB/T 1800.3-98标准公差IT13级执行；
4.未注形位尺寸公差按：GB/T1184-1996 K级执行；
5.图中▽为CC关键特性，◇为SC重要特性；
6.未标注尺寸以3D模型为准；
7.喷漆白色，颜色参考色卡，喷涂区域参考喷涂信息表；

未标注公差/Limit | 人 员 | 日 期 | 版本号 | 重量KG | 比 例
线性 \ Liner Measure | 设 计 | 张正昱 | 设 计 | 2026/9/3 | 01 | 0.1 | 1:2

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

倒角 \ Chamfer | | | | 角度 / Angle
