CloudEngineHub/RP1_hardware/(commit log)

2026-10-09 Simplify CAD download instructions
2026-10-15 Update PCB fabrication requirements and harness drawings
2026-10-15 Remove CAD release ZIP download references
2026-10-15 Apply approved motor model names and RP_Hand labels
2026-10-15 Synchronize motor part numbers with approved module catalog
2026-10-25 Replace RP1.3.4 BOM workbooks with updated supplied files
2026-10-25 Update CNC, 3D printing and rubber CMF PDFs
2026-10-26 Add 46 missing 3D printed part PDF drawings
